DexterInd/BrickPi/README.txt

This project combines the brains of a Raspberry Pi with the brawn of a LEGO MINDSTORMS NXT.  Read more about it here:  http://www.dexterindustries.com/BrickPi

This repository only holds firmware and hardware designs.  
	* If you're looking for our BrickPi Python libraries, look here:	https://github.com/DexterInd/BrickPi_Python
	* If you're looking for the BrickPi C Libraries, look here: 		https://github.com/DexterInd/BrickPi_C
	* If you're looking for the BrickPi Scratch libraries, look here:	https://github.com/DexterInd/BrickPi_Scratch

The board firmware is made in Arduino in order to make it super-hackable.  The firmware is written in Arduino 1.0 and can be uploaded via an ISP programmer.  It can also be uploaded with an Arduino Uno, with an adapter explained in this repository.

The board supports LEGO NXT motors and LEGO NXT sensors, as well as many of Dexter Industries sensors for LEGO Mindstorms.

Dexter Industries
http://www.dexterindustries.com/BrickPi
