DexterInd/BrickPi/Software/BrickPi_Scratch/README.md

BrickPi Scratch Code and Examples
===================

This repository contains a Scratch library for BrickPi and Raspberry Pi, allowing you to use Scratch and LEGO Mindstorms NXT motors and sensors.
These files have been made available online through a [Creative Commons Attribution-ShareAlike 3.0](http://creativecommons.org/licenses/by-sa/3.0/) license.

Getting Started
============

Scratch and Scratch Examples come already installed on the Dexter Industries image.  See [more about the image here.](http://www.dexterindustries.com/BrickPi/getting-started/pi-prep/)

For step by step instructions on how to use Scratch with the BrickPi, please see our [tutorial on getting started with Scratch.](http://www.dexterindustries.com/BrickPi/program-it/scratch/)

Video and text tutorials for installation and operation are provided.

See Also
========

[BrickPi](http://www.dexterindustries.com/BrickPi.html) is a [Raspberry Pi](http://www.raspberrypi.org) Board that connects [LEGO MINDSTORMS motors and sensors](http://mindstorms.lego.com) to the Raspberry Pi.

More information on hardware, firmware, and software can be found on the [BrickPi site](http://www.dexterindustries.com/BrickPi)

The BrickPi can be [purchased here.](http://www.dexterindustries.com/BrickPi.html)
