DexterInd/BrickPi/Software/BrickPi_Python/Project_Examples/README.MD

# BrickPi Project Examples

This folder contains the code for the four example python projects..

BrickPi is a Raspberry Pi Board that connects LEGO MINDSTORMS motors and sensors to the Raspberry Pi.

[More information on hardware, firmware, and software can be found here.](http://www.dexterindustries.com/BrickPi)
