DexterInd/BrickPi/Software/BrickPi_Scratch/Programming/README.md

BrickPi Scratch Code and Examples
===================

This repository contains a Scratch library for BrickPi and Raspberry Pi, allowing you to use Scratch and LEGO Mindstorms NXT motors and sensors.
These files have been made available online through a [Creative Commons Attribution-ShareAlike 3.0](http://creativecommons.org/licenses/by-sa/3.0/) license.

Getting Started
============

Scratch and Scratch Examples come already installed on the Dexter Industries image.  See [more about the image here.](http://www.dexterindustries.com/BrickPi/getting-started/pi-prep/)

For step by step instructions on how to use Scratch with the BrickPi, please see our [tutorial on getting started with Scratch.](http://www.dexterindustries.com/BrickPi/program-it/scratch/)

Video and text tutorials for installation and operation are provided.

EV3 Sensors
============
Below are a few screenshots of various programs using EV3 sensors with the BrickPi and Scratch.

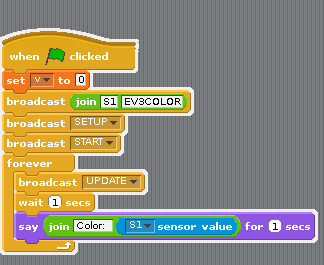
[picture p1: Software/BrickPi_Scratch/Programming/EV3_Color_on_S1.PNG]
EV3 Color Sensor


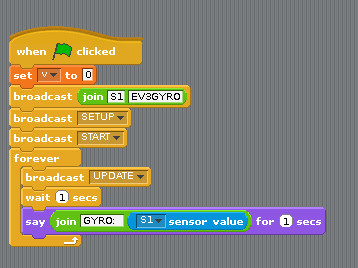
[picture p2: Software/BrickPi_Scratch/Programming/EV3_Gyro_on_S1.PNG]
EV3 Gyroscope Sensor


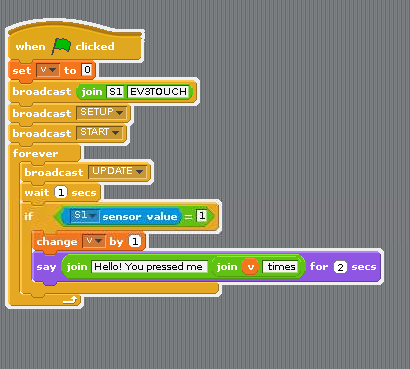
[picture p3: Software/BrickPi_Scratch/Programming/EV3_Touch_on_S1.PNG]
EV3 Touch Sensor


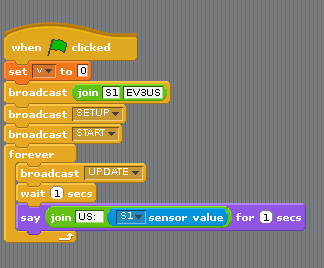
[picture p4: Software/BrickPi_Scratch/Programming/EV3_Ultrasonic_Sensor_on_S1.PNG]
EV3 Ultrasonic Sensor


See Also
========

[BrickPi](http://www.dexterindustries.com/brickpi) is a [Raspberry Pi](http://www.raspberrypi.org) Board that connects [LEGO MINDSTORMS motors and sensors](http://mindstorms.lego.com) to the Raspberry Pi.

More information on hardware, firmware, and software can be found on the [BrickPi site](http://www.dexterindustries.com/BrickPi)

The BrickPi can be [purchased here.](http://www.dexterindustries.com/BrickPi.html)
