DexterInd/BrickPi/Software/BrickPi_Python/Project_Examples/candysorter/README.md

## Raspberry Pi Candy Sorting Robot
### Candy Sorting Robot Using Google Cloud Vision, the Raspberry Pi, and the BrickPi.

In this tutorial, we're going to build a machine to sort your Halloween candy, using the Raspberry Pi and Google Cloud Vision.

Pile of candy too big this year?  Need to sort the junk from the gold?  Have a certain candy you hate?  Fear not, the BrickPi Candy Sorter is here to help!  In this tutorial we'll harness the powerful Google Cloud Vision, the BrickPi, the Raspberry Pi, the Pi Camera, and a pile of LEGO's to build a machine to fine what you want (and don't want) automatically!  After you run the BrickPi Candy Sorter, you'll have a pile of candy you want, and the junk you can give your little brother.

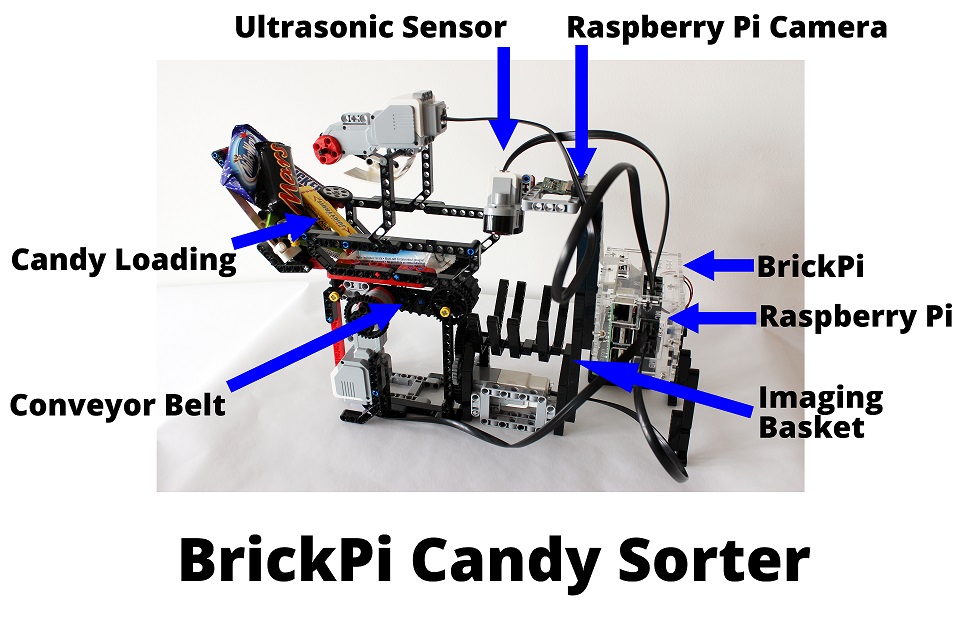
[picture p5: Software/BrickPi_Python/Project_Examples/candysorter/Overview-BrickPi-Candy-Sorter.jpg]
Controlling the GoPiGo robot with a mobile phone Overview of a Candy Sorting Robot Using Google Cloud Vision, the Raspberry Pi, and the BrickPi..


### Learn More

See the full [tutorial on how to build the Candy Sorting Robot on our website here.](http://www.dexterindustries.com/projects/brickpi-candy-sorter-sort-halloween-candy-with-google-cloud-vision-and-the-raspberry-pi)

See more about [the BrickPi here.](http://www.dexterindustries.com/BrickPi)
