DexterInd/BrickPi/Models/SimpleBot/README.md

SimpleBot Model
=====

These are the design files for the BrickPi SimpleBot robot, developed by Dexter Industries.

The SimpleBot as its name says is one of the simplest bot that you can build with the BrickPi. It is a 2 wheeled robot with a very easy to build chassis. We have added examples in the Github Repo for both Python(https://github.com/DexterInd/BrickPi/tree/master/Software/BrickPi_Python/Project_Examples/simplebot) and C(https://github.com/DexterInd/BrickPi/tree/master/Software/BrickPi_C/Project_Examples/simplebot) using which you can get this bot running directly from WiFi or use a PSP Controller to control the bot.

These files have been made available online through a [Creative Commons Attribution-ShareAlike 3.0](http://creativecommons.org/licenses/by-sa/3.0/) license.

You are welcome to distribute, remix, and use these files for commercial purposes. If you do so, please attribute the original design to Dexter Industries both on the website and on the physical packaging of the product or in the instruction manual. All derivative works must be published under the same or a similar license.

## What's Here

simplebot.lxf — LEGO Digital Designer Files fro the simplebot which can help you in building the simplebot
simplebot_bom - The Bill of Material for the SimpleBot with all the parts used in the build
