DexterInd/BrickPi/BrickPi_B+_Layout-Motors.png

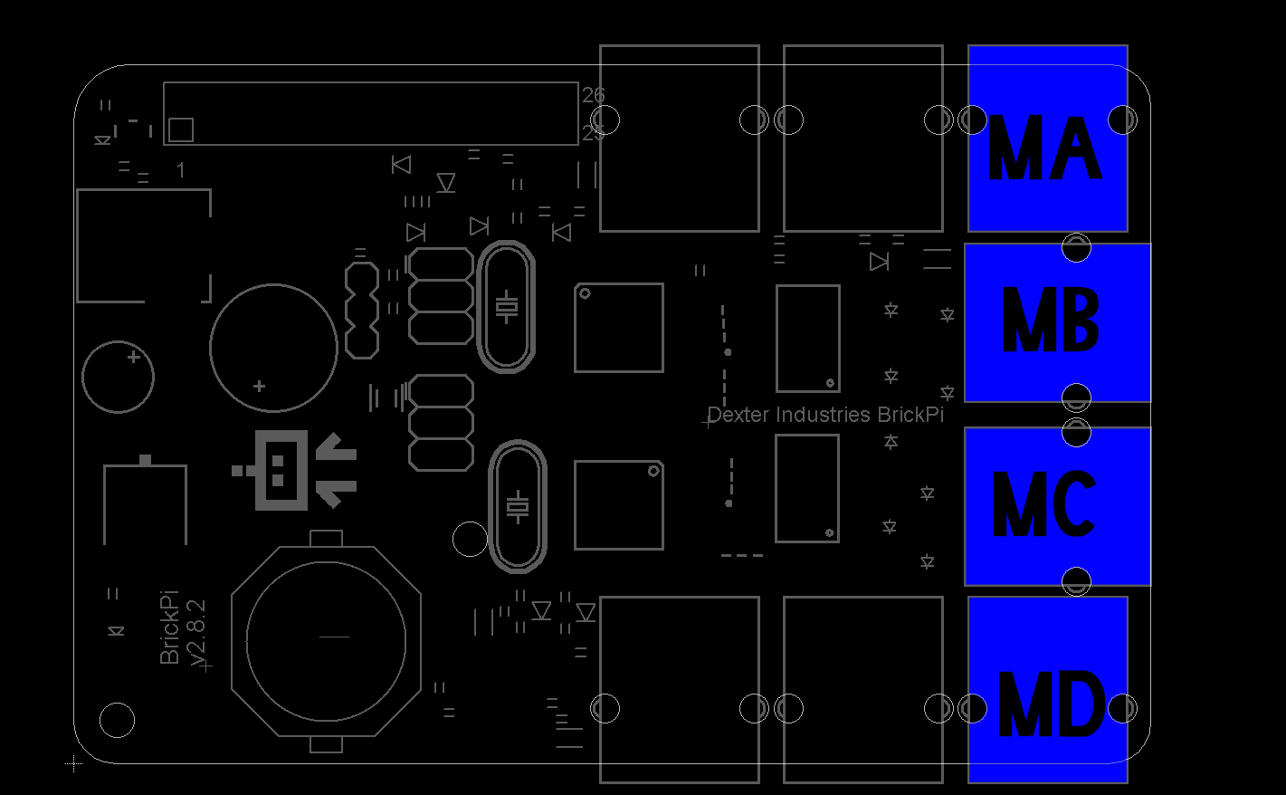
BrickPi_B+_Layout-Motors.png
