DexterInd/BrickPi/BrickPi_B+_Layout-Sensors.png

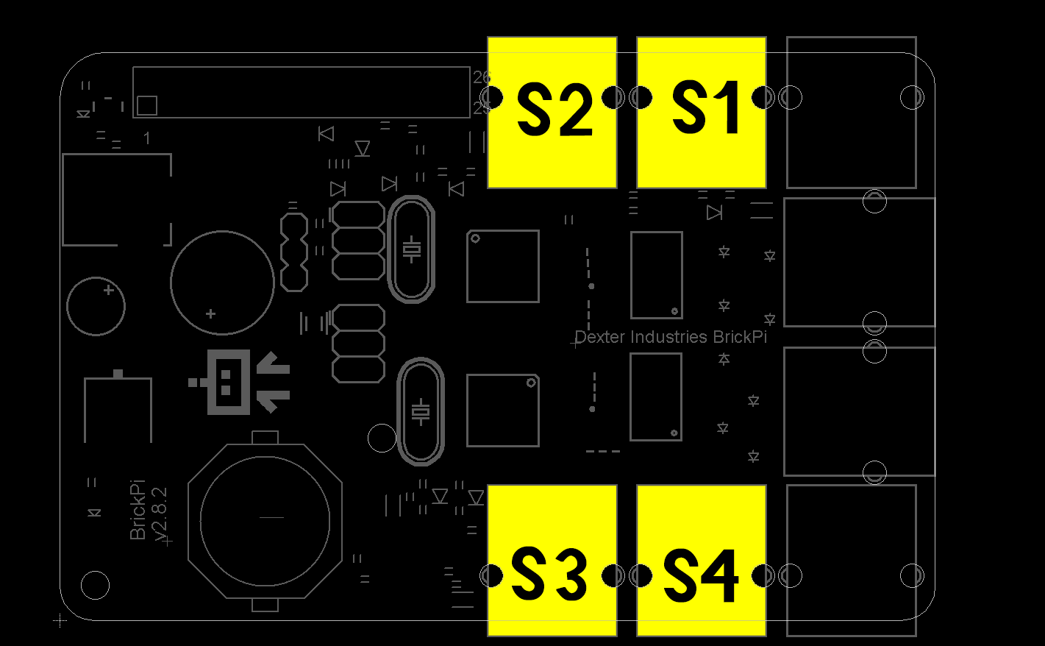
BrickPi_B+_Layout-Sensors.png
