DexterInd/BrickPi/Firmware_BrickPi/Updating_the_Firmware/BrickPi Programming - Arduino.jpg

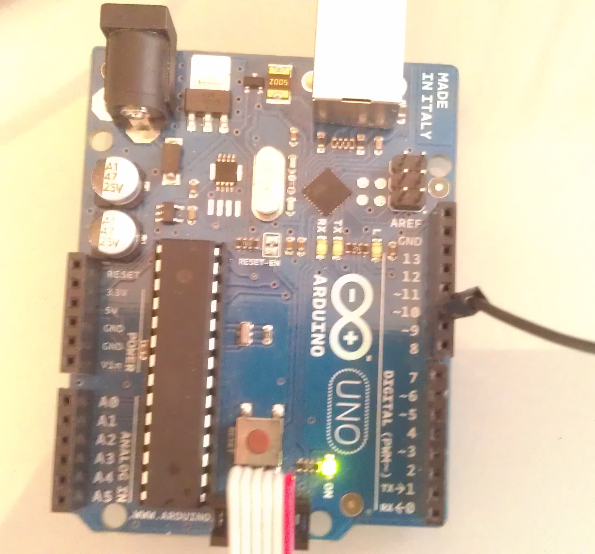
Firmware_BrickPi/Updating_the_Firmware/BrickPi Programming - Arduino.jpg
