DexterInd/BrickPi/Firmware_BrickPi/Updating_the_Firmware/BrickPi Programming - BrickPi and Arduino Programmer.jpg

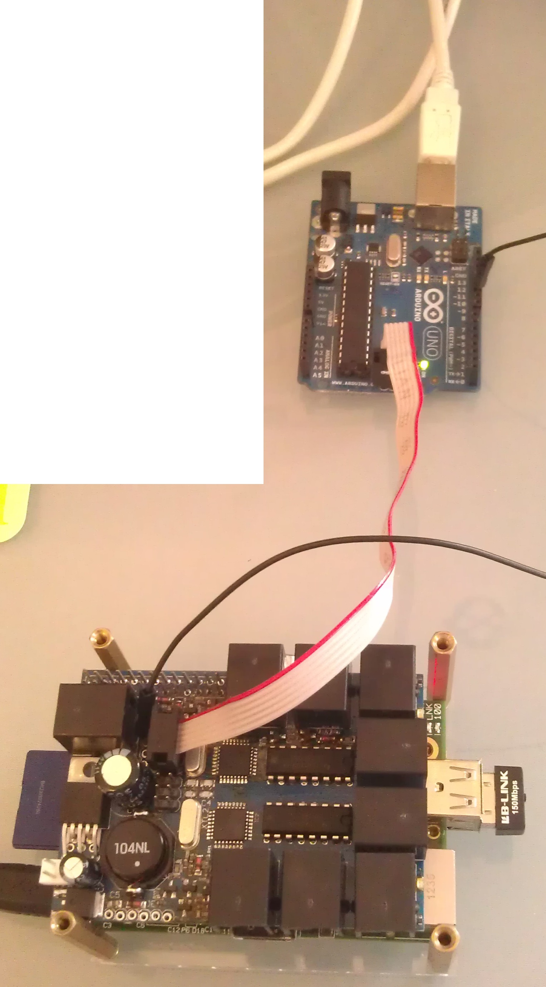
Firmware_BrickPi/Updating_the_Firmware/BrickPi Programming - BrickPi and Arduino Programmer.jpg
