DexterInd/BrickPi/Firmware_BrickPi/Updating_the_Firmware/BrickPi Programming - BrickPi from Above.jpg

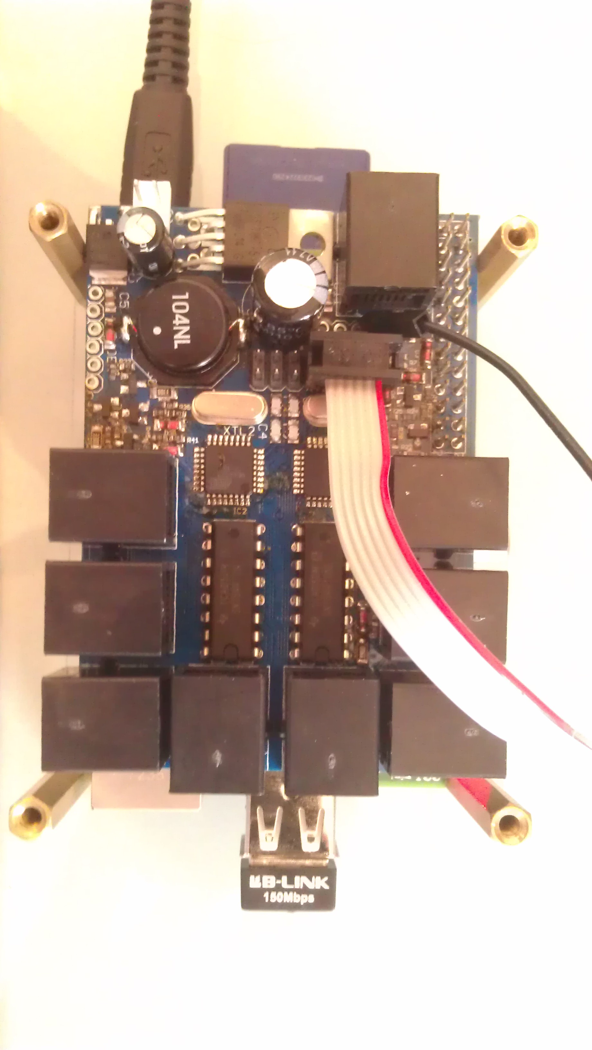
Firmware_BrickPi/Updating_the_Firmware/BrickPi Programming - BrickPi from Above.jpg
