DexterInd/BrickPi/Firmware_BrickPi/Updating_the_Firmware/Finding_the_COM_Port_Number.PNG

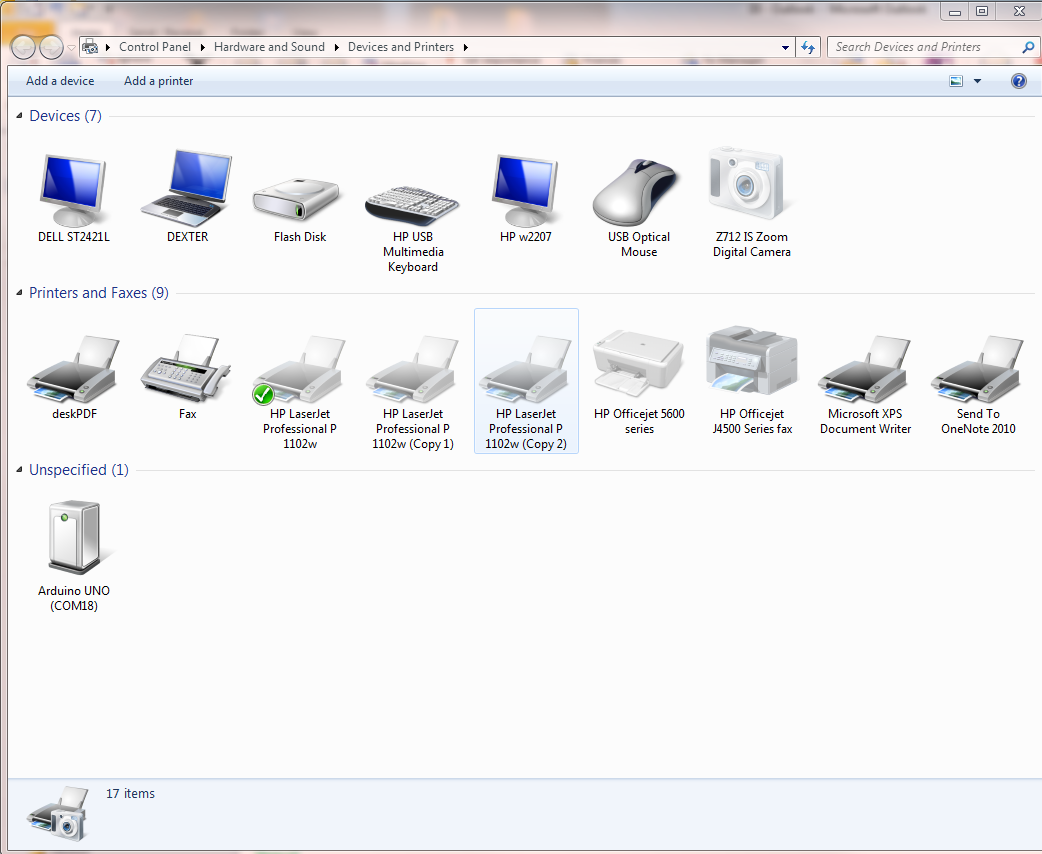
Firmware_BrickPi/Updating_the_Firmware/Finding_the_COM_Port_Number.PNG
