DexterInd/BrickPi/Firmware_BrickPi/Updating_the_Firmware/Finishing A Succesful Programming.PNG

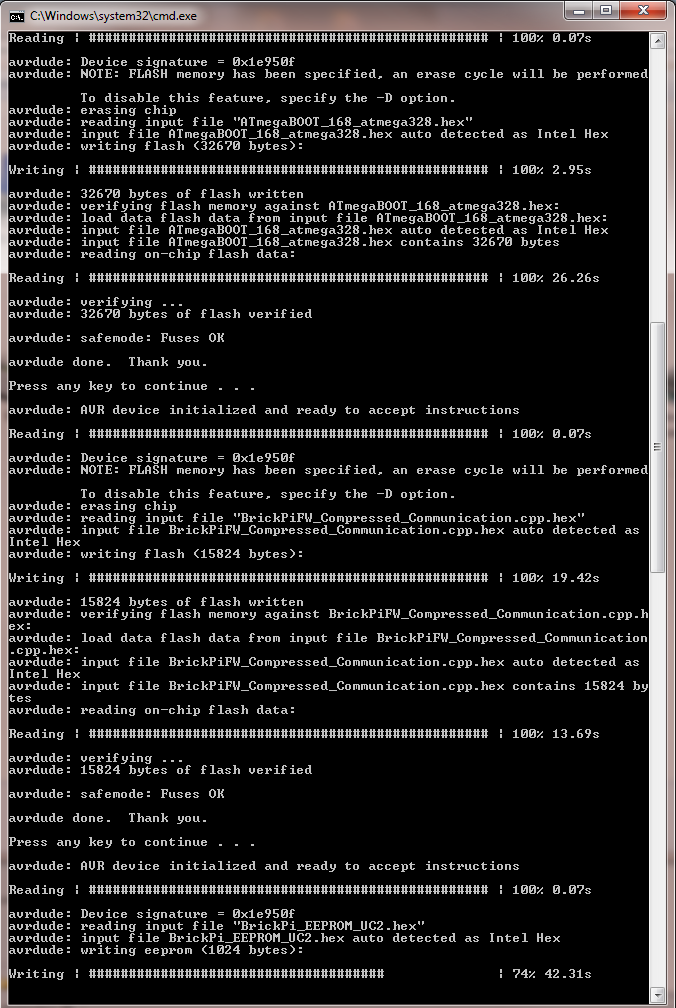
Firmware_BrickPi/Updating_the_Firmware/Finishing A Succesful Programming.PNG
