DexterInd/BrickPi/Firmware_BrickPi/Updating_the_Firmware/Setting Fuses Succesfully.PNG

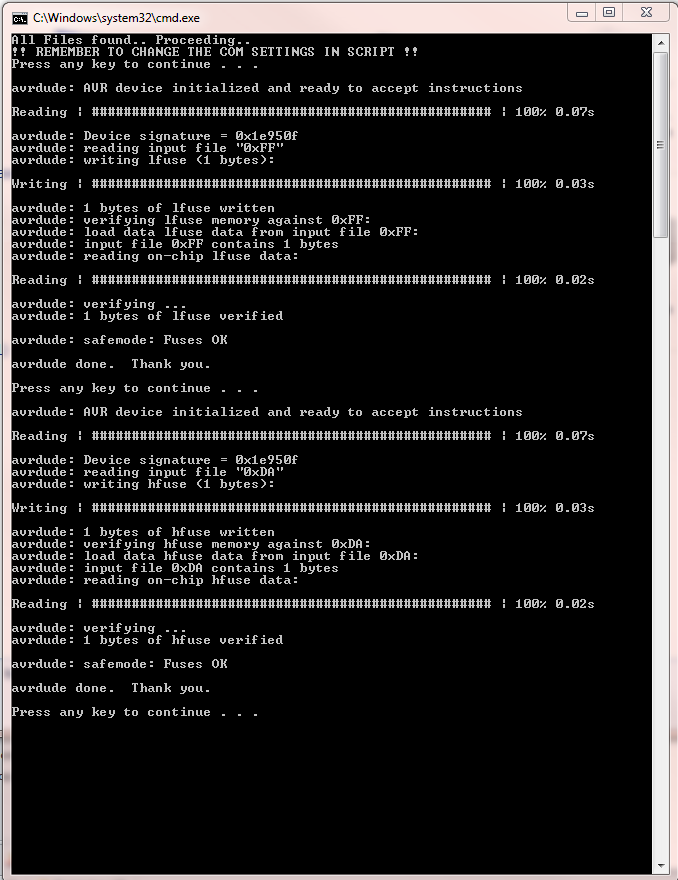
Firmware_BrickPi/Updating_the_Firmware/Setting Fuses Succesfully.PNG
