DexterInd/BrickPi/High Altitude Ballooning Project/weather_balloon_picture.jpg

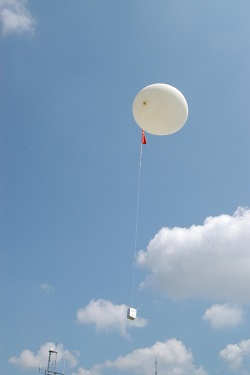
High Altitude Ballooning Project/weather_balloon_picture.jpg
