DexterInd/BrickPi/Models/Robotic_Arm/arm.png

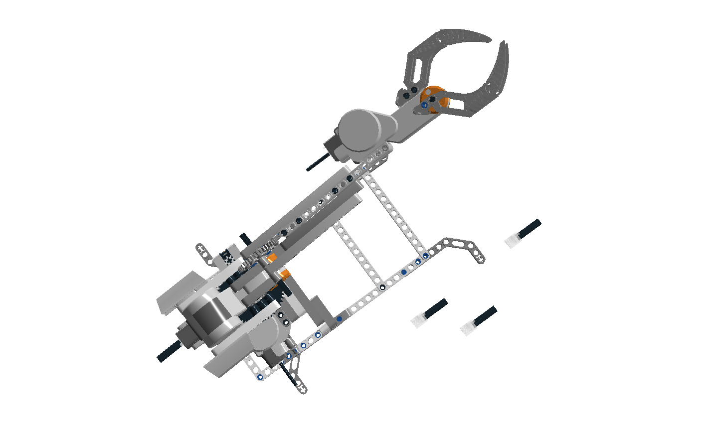
Models/Robotic_Arm/arm.png
