DexterInd/BrickPi/Models/Shooter/shooter.png

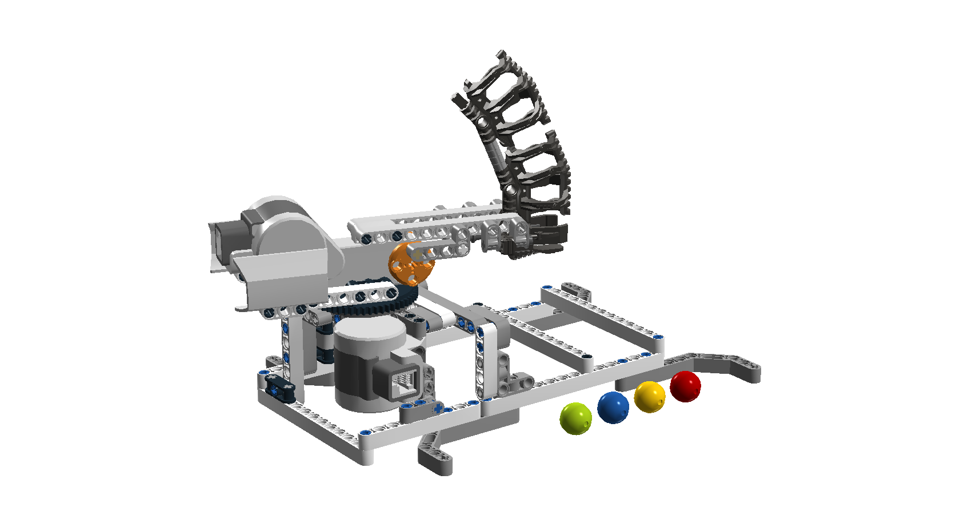
Models/Shooter/shooter.png
