DexterInd/BrickPi/Models/Tank/Tank.png

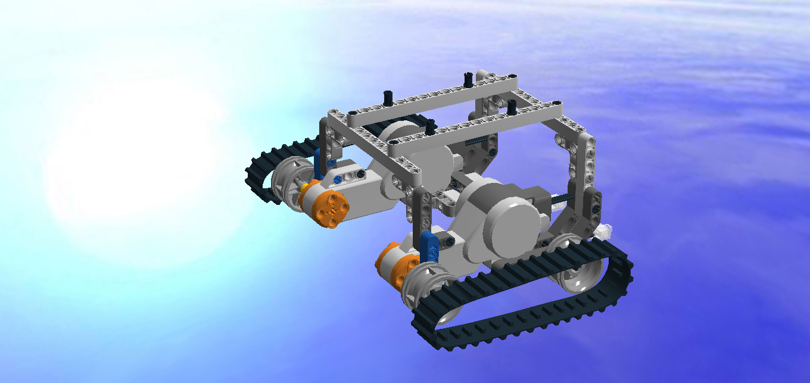
Models/Tank/Tank.png
