DexterInd/BrickPi/Models/WIFI_Car/WiFi Car in Space.png

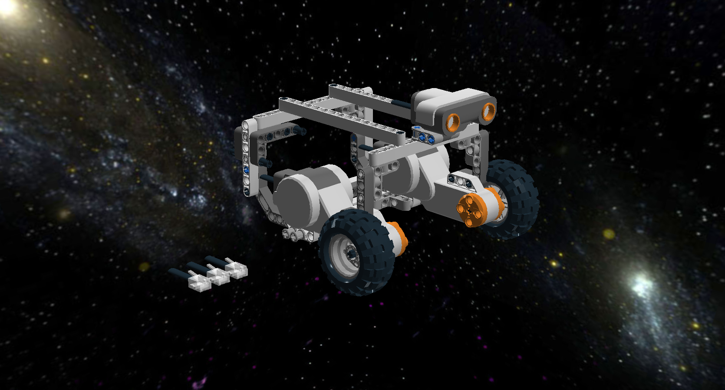
Models/WIFI_Car/WiFi Car in Space.png
