DexterInd/BrickPi/Models/WIFI_Car/WiFi Car In the Desert.png

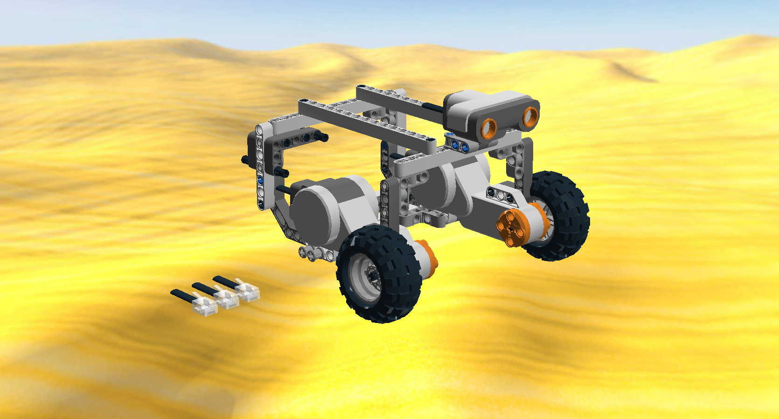
Models/WIFI_Car/WiFi Car In the Desert.png
