DexterInd/BrickPi/Models/WIFI_Car/WiFi Car.png

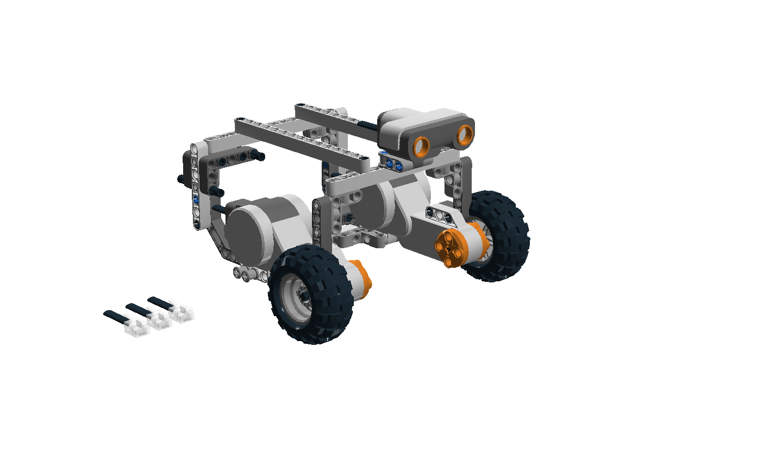
Models/WIFI_Car/WiFi Car.png
