DexterInd/BrickPi/Software/BrickPi_Python/Project_Examples/openCV/curve1.jpg

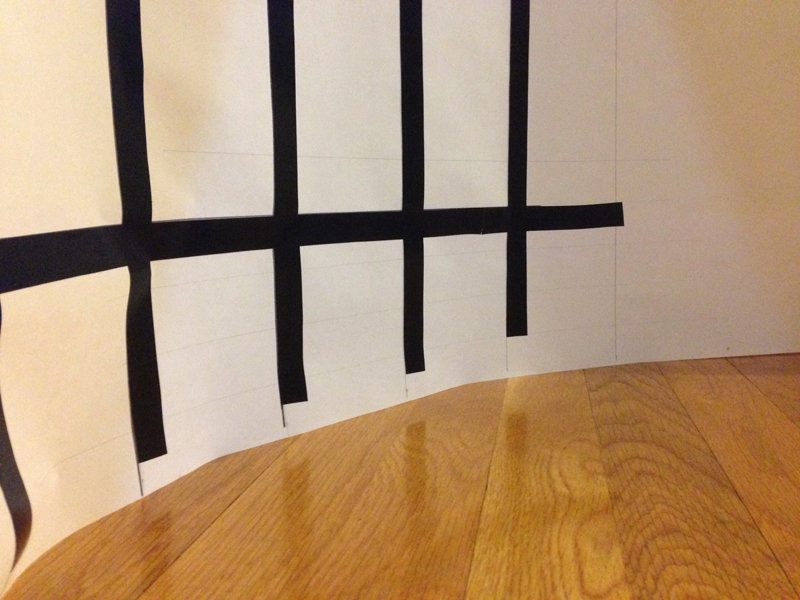
Software/BrickPi_Python/Project_Examples/openCV/curve1.jpg
