DexterInd/BrickPi/Software/BrickPi_Python/Project_Examples/openCV/curve2.jpg

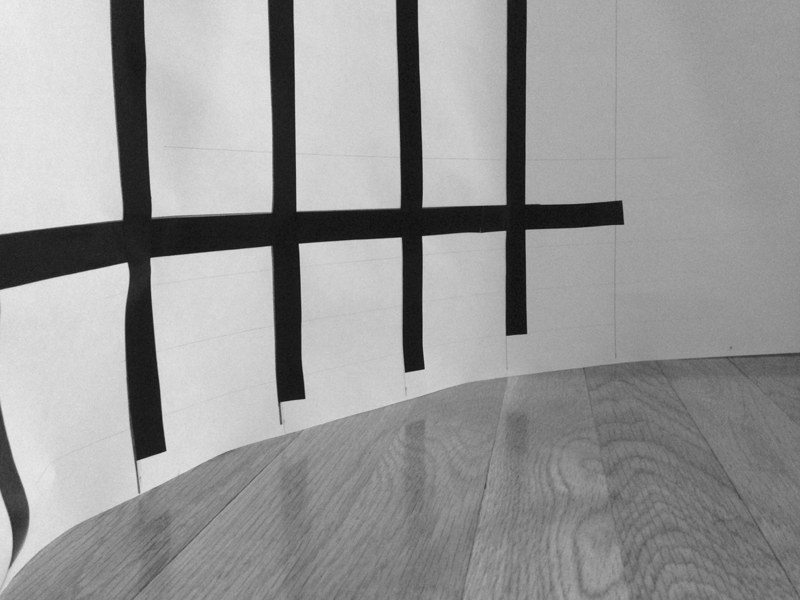
Software/BrickPi_Python/Project_Examples/openCV/curve2.jpg
