DexterInd/BrickPi/Software/BrickPi_Python/Project_Examples/openCV/gridlines1.jpg

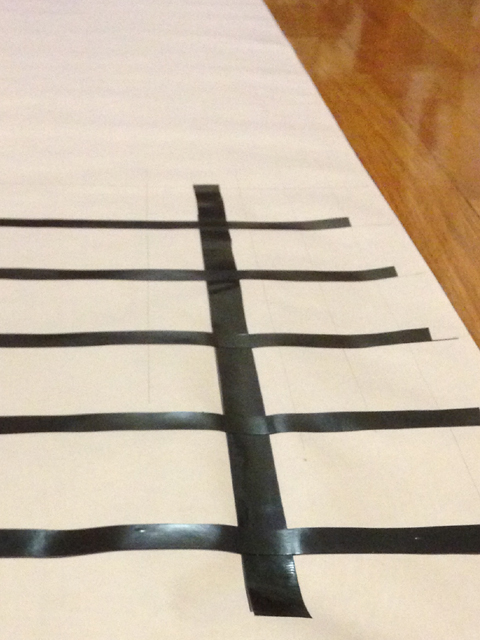
Software/BrickPi_Python/Project_Examples/openCV/gridlines1.jpg
