DexterInd/BrickPi/Software/BrickPi_Python/Project_Examples/openCV/gridlines2.jpg

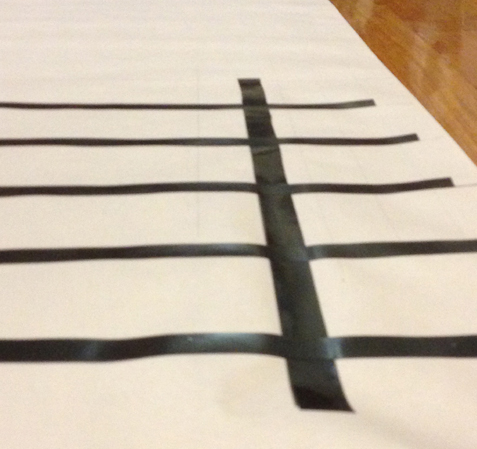
Software/BrickPi_Python/Project_Examples/openCV/gridlines2.jpg
