DexterInd/BrickPi/Software/BrickPi_Python/Project_Examples/openCV/gridlines3.jpg

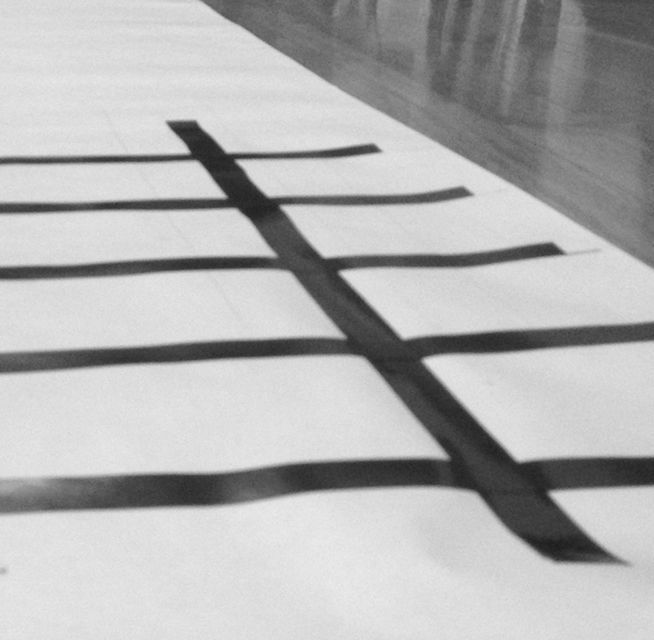
Software/BrickPi_Python/Project_Examples/openCV/gridlines3.jpg
