DexterInd/BrickPi/Software/BrickPi_Python/Project_Examples/openCV/houghlines5.jpg

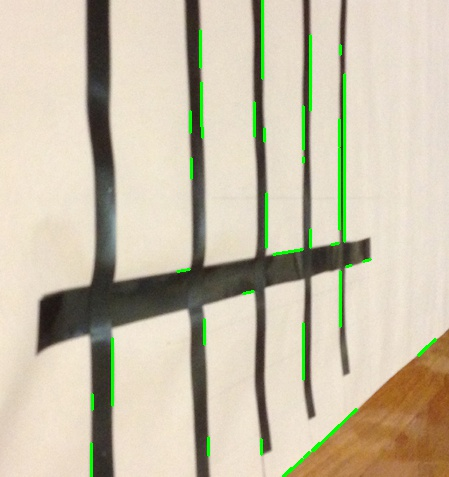
Software/BrickPi_Python/Project_Examples/openCV/houghlines5.jpg
