DexterInd/BrickPi/Software/BrickPi_Python/Project_Examples/openCV/houghlines7.jpg

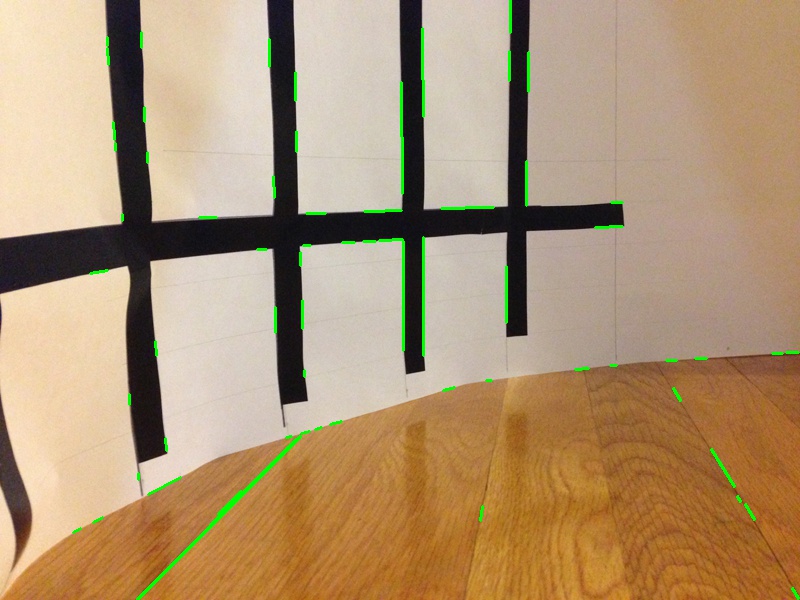
Software/BrickPi_Python/Project_Examples/openCV/houghlines7.jpg
