DexterInd/BrickPi/Software/BrickPi_Python/Project_Examples/openCV/racelines1.jpg

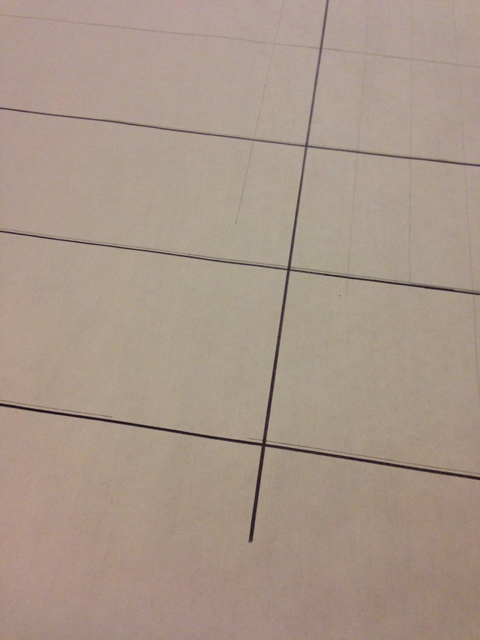
Software/BrickPi_Python/Project_Examples/openCV/racelines1.jpg
