DexterInd/BrickPi/Software/BrickPi_Python/Project_Examples/openCV/racelines2.jpg

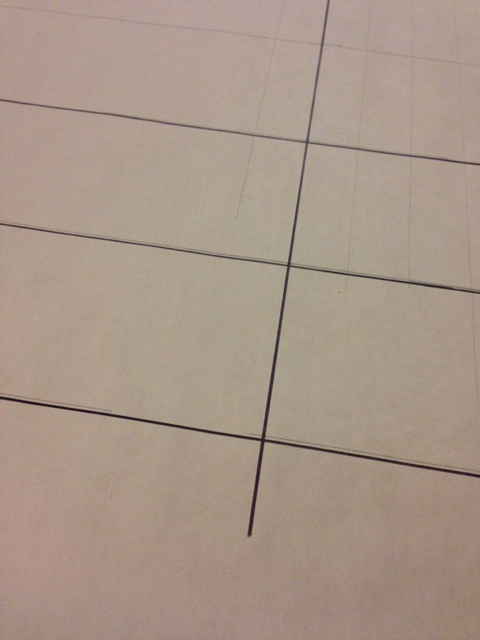
Software/BrickPi_Python/Project_Examples/openCV/racelines2.jpg
