DexterInd/BrickPi/Software/BrickPi_Python/Project_Examples/openCV/simple.jpg

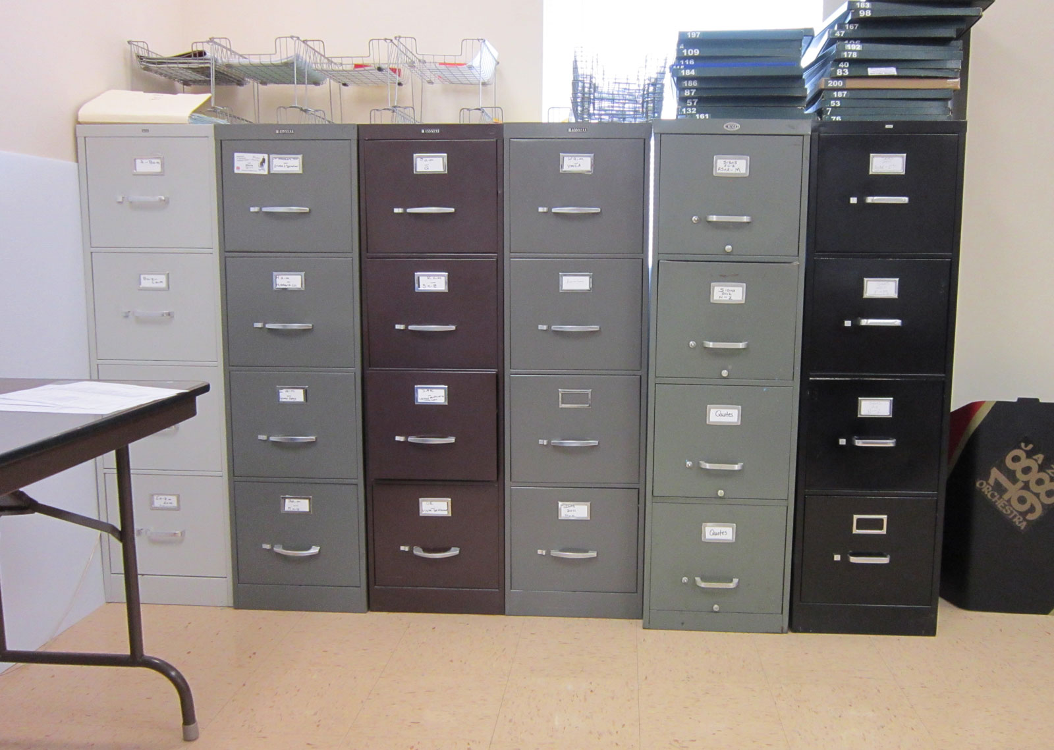
Software/BrickPi_Python/Project_Examples/openCV/simple.jpg
