DexterInd/BrickPi/Hardware Design/BrickPi BOM 1.7.3.xlsx

Sheet: BOM - BrickPi Basic
Part | Value | Device | Package | Description | Part Number and Link
C1 | 22 pF | C-USC0805 | C0805 | Capacitor | VJ0805A220GXAPW1BC (http://www.mouser.com/ProductDetail/Vishay-Vitramon/VJ0805A220GXAPW1BC/)
C2 | 22 pF | C-USC0805 | C0805 | Capacitor | VJ0805A220GXAPW1BC (http://www.mouser.com/ProductDetail/Vishay-Vitramon/VJ0805A220GXAPW1BC/)
C3 | 22 pF | C-USC0805 | C0805 | Capacitor | VJ0805A220GXAPW1BC (http://www.mouser.com/ProductDetail/Vishay-Vitramon/VJ0805A220GXAPW1BC/)
C4 | 22 pF | C-USC0805 | C0805 | Capacitor | VJ0805A220GXAPW1BC (http://www.mouser.com/ProductDetail/Vishay-Vitramon/VJ0805A220GXAPW1BC/)
C5 | 0.1 uF | C-USC0805 | C0805 | Capacitor | VJ0805V104MXBPW1BC (http://www.mouser.com/ProductDetail/Vishay-Vitramon/VJ0805V104MXBPW1BC/)
C6 | 0.1 uF | C-USC0805 | C0805 | Capacitor | VJ0805V104MXBPW1BC (http://www.mouser.com/ProductDetail/Vishay-Vitramon/VJ0805V104MXBPW1BC/)
C8 | 0.1 uF | C-USC0805 | C0805 | Capacitor | VJ0805V104MXBPW1BC (http://www.mouser.com/ProductDetail/Vishay-Vitramon/VJ0805V104MXBPW1BC/)
C10 | 0.1 uF | C-USC0805 | C0805 | Capacitor | VJ0805V104MXBPW1BC (http://www.mouser.com/ProductDetail/Vishay-Vitramon/VJ0805V104MXBPW1BC/)
C11 | 10uf | C-USC0805 | C0805 | CAPACITOR, American symbol | CGA4J1X5R1C106K (http://www.mouser.com/ProductDetail/TDK/CGA4J1X5R1C106K/)
D2 |  | DIODE-SOD80C | SOD80C | DIODE | LS4448GS08 (http://www.mouser.com/ProductDetail/Vishay-Semiconductors/LS4448GS08/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)
D3 |  | DIODE-SOD80C | SOD80C | DIODE | LS4448GS09 (http://www.mouser.com/ProductDetail/Vishay-Semiconductors/LS4448GS08/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)
D4 |  | DIODE-SOD80C | SOD80C | DIODE | LS4448GS10 (http://www.mouser.com/ProductDetail/Vishay-Semiconductors/LS4448GS08/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)
D5 |  | DIODE-SOD80C | SOD80C | DIODE | LS4448GS11 (http://www.mouser.com/ProductDetail/Vishay-Semiconductors/LS4448GS08/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)
D6 |  | DIODE-SOD80C | SOD80C | DIODE | LS4448GS12 (http://www.mouser.com/ProductDetail/Vishay-Semiconductors/LS4448GS08/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)
D10 |  | DIODE-SOD80C | SOD80C | DIODE | LS4448GS13 (http://www.mouser.com/ProductDetail/Vishay-Semiconductors/LS4448GS08/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)
D20 |  | DIODE-SOD80C | SOD80C | DIODE | LS4448GS14 (http://www.mouser.com/ProductDetail/Vishay-Semiconductors/LS4448GS08/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)
D30 |  | DIODE-SOD80C | SOD80C | DIODE | LS4448GS15 (http://www.mouser.com/ProductDetail/Vishay-Semiconductors/LS4448GS08/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)
D40 |  | DIODE-SOD80C | SOD80C | DIODE | LS4448GS16 (http://www.mouser.com/ProductDetail/Vishay-Semiconductors/LS4448GS08/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)
D50 |  | DIODE-SOD80C | SOD80C | DIODE | LS4448GS15 (http://www.mouser.com/ProductDetail/Vishay-Semiconductors/LS4448GS08/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)
D51 |  | DIODE-SOD80C | SOD80C | DIODE | LS4448GS16 (http://www.mouser.com/ProductDetail/Vishay-Semiconductors/LS4448GS08/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)
F1 | PTCSMD | PTCSMD | PTC-1206 | Resettable Fuse PTC | PTS12066V110 (http://www.mouser.com/ProductDetail/Cooper-Bussmann/PTS12066V110/)
IC1 |  | ATMEGA328P-AU | TQFP32-08 | Arduino | ATMEGA328P-AU (http://www.mouser.com/ProductDetail/Atmel/ATMEGA328P-AU/?qs=sGAEpiMZZMtVoztFdqDXO3RbBx7FKCmV)
IC2 |  | ATMEGA328P-AU | TQFP32-08 | Arduino | ATMEGA328P-AU (http://www.mouser.com/ProductDetail/Atmel/ATMEGA328P-AU/?qs=sGAEpiMZZMtVoztFdqDXO3RbBx7FKCmV)
IC3 | SN754410 | DIL16-ROUND-HEAT_DIS_SN754410 |  |  | SN754410NE (http://www.mouser.com/ProductDetail/Texas-Instruments/SN754410NE/)
IC4 | SN754410 | DIL16-ROUND-HEAT_DIS_SN754410 |  |  | SN754410NE (http://www.mouser.com/ProductDetail/Texas-Instruments/SN754410NE/)
IC6 | REGULATOR_5V_TO220-H_7805 | REGULATOR_5V_TO220-H_7805 | TO220-H | Positive VOLTAGE REGULATOR | 512-LM7805ACT (http://www.mouser.com/ProductDetail/Fairchild-Semiconductor/LM7805ACT/)
JP2 |  | M02LOCK | 1X02_LOCK | Header 2 | 538-22-23-2021 (http://www.mouser.com/ProductDetail/Molex/22-23-2021/)
LED1 |  | LED0805 | 0805-LED | LEDs | 638-172BHC-AN1P23T (https://www.mouser.com/Search/ProductDetail.aspx)
LED2 |  | LED0805 | 0805-LED | LEDs | 638-172BHC-AN1P23T (https://www.mouser.com/Search/ProductDetail.aspx)
Q10 |  | PNP-TRANSISTOR_SOT23 | SOT23 | PNP TRANSISTOR | MMBT3906LT3G (http://www.mouser.com/ProductDetail/ON-Semiconductor/MMBT3906LT3G/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)
Q11 |  | NPN-TRANSISTOR_SOT23 | SOT23 | NPN TRANSISTOR | MMBT3904 (http://www.mouser.com/ProductDetail/Fairchild-Semiconductor/MMBT3904/)
Q20 |  | PNP-TRANSISTOR_SOT23 | SOT23 | PNP TRANSISTOR | MMBT3906LT3G (http://www.mouser.com/ProductDetail/ON-Semiconductor/MMBT3906LT3G/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)
Q21 |  | NPN-TRANSISTOR_SOT23 | SOT23 | NPN TRANSISTOR | MMBT3904 (http://www.mouser.com/ProductDetail/Fairchild-Semiconductor/MMBT3904/)
Q30 |  | PNP-TRANSISTOR_SOT23 | SOT23 | PNP TRANSISTOR | MMBT3906LT3G (http://www.mouser.com/ProductDetail/ON-Semiconductor/MMBT3906LT3G/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)
Q31 |  | NPN-TRANSISTOR_SOT23 | SOT23 | NPN TRANSISTOR | MMBT3904 (http://www.mouser.com/ProductDetail/Fairchild-Semiconductor/MMBT3904/)
Q40 |  | PNP-TRANSISTOR_SOT23 | SOT23 | PNP TRANSISTOR | MMBT3906LT3G (http://www.mouser.com/ProductDetail/ON-Semiconductor/MMBT3906LT3G/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)
Q41 |  | NPN-TRANSISTOR_SOT23 | SOT23 | NPN TRANSISTOR | MMBT3904 (http://www.mouser.com/ProductDetail/Fairchild-Semiconductor/MMBT3904/)
XTL1 |  | CRYSTALHC49S | HC49/S | CRYSTAL | ATS16B (http://www.mouser.com/ProductDetail/CTS-Electronic-Components/ATS16B/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)
XTL2 |  | CRYSTALHC49S | HC49/S | CRYSTAL | ATS16B (http://www.mouser.com/ProductDetail/CTS-Electronic-Components/ATS16B/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)
U$3 |  | NXT-SOCKETREGULAR | NXT-SOCKETREGULAR | NXT-SOCKET | Female Sockets (http://www.dexterindustries.com/NXTFemaleSockets.html)
U$4 |  | NXT-SOCKETREGULAR | NXT-SOCKETREGULAR | NXT-SOCKET | Female Sockets (http://www.dexterindustries.com/NXTFemaleSockets.html)
U$5 |  | NXT-SOCKETREGULAR | NXT-SOCKETREGULAR | NXT-SOCKET | Female Sockets (http://www.dexterindustries.com/NXTFemaleSockets.html)
U$7 |  | NXT-SOCKETREGULAR | NXT-SOCKETREGULAR | NXT-SOCKET | Female Sockets (http://www.dexterindustries.com/NXTFemaleSockets.html)
U$8 |  | NXT-SOCKETREGULAR | NXT-SOCKETREGULAR | NXT-SOCKET | Female Sockets (http://www.dexterindustries.com/NXTFemaleSockets.html)
U$9 |  | NXT-SOCKETREGULAR | NXT-SOCKETREGULAR | NXT-SOCKET | Female Sockets (http://www.dexterindustries.com/NXTFemaleSockets.html)
U$10 |  | NXT-SOCKETREGULAR | NXT-SOCKETREGULAR | NXT-SOCKET | Female Sockets (http://www.dexterindustries.com/NXTFemaleSockets.html)
U$11 |  | NXT-SOCKETREGULAR | NXT-SOCKETREGULAR | NXT-SOCKET | Female Sockets (http://www.dexterindustries.com/NXTFemaleSockets.html)
U$12 |  | NXT-SOCKETREGULAR | NXT-SOCKETREGULAR | NXT-SOCKET | Female Sockets (http://www.dexterindustries.com/NXTFemaleSockets.html)
R1 | 10k | RESISTOR0603-RES | 603 | Resistor | RK73B1JTTDD103J (http://www.mouser.com/ProductDetail/KOA-Speer/RK73B1JTTDD103J/)
R2 | 10k | RESISTOR0603-RES | 603 | Resistor | RK73B1JTTDD103J (http://www.mouser.com/ProductDetail/KOA-Speer/RK73B1JTTDD103J/)
R3 | 2k4 | RESISTOR0603-RES | 603 | Resistor | RK73B1JTTDD242J (http://www.mouser.com/ProductDetail/KOA-Speer/RK73B1JTTDD242J/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)
R4 | 10k | RESISTOR0603-RES | 603 | Resistor | RK73B1JTTDD103J (http://www.mouser.com/ProductDetail/KOA-Speer/RK73B1JTTDD103J/)
R6 | 4k7 | RESISTOR0603-RES | 603 | Resistor | RK73B1JTTDD472J (http://www.mouser.com/ProductDetail/KOA-Speer/RK73B1JTTDD472J/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)
R7 | 2k4 | RESISTOR0603-RES | 603 | Resistor | RK73B1JTTDD242J (http://www.mouser.com/ProductDetail/KOA-Speer/RK73B1JTTDD242J/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)
R8 | 220 | RESISTOR0603-RES | 603 | Resistor | RK73B1JTTDD221J (http://www.mouser.com/ProductDetail/KOA-Speer/RK73B1JTTDD221J/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)
R9 | 220 | RESISTOR0603-RES | 603 | Resistor | RK73B1JTTDD221J (http://www.mouser.com/ProductDetail/KOA-Speer/RK73B1JTTDD221J/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)
R10 | 10k | RESISTOR0603-RES | 603 | Resistor | RK73B1JTTDD103J (http://www.mouser.com/ProductDetail/KOA-Speer/RK73B1JTTDD103J/)
R11 | 4k7 | RESISTOR0603-RES | 603 | Resistor | RK73B1JTTDD472J (http://www.mouser.com/ProductDetail/KOA-Speer/RK73B1JTTDD472J/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)
R12 | 325 | RESISTOR1206 | 1206 | Resistor | CR1206-FX-3300ELF (http://www.mouser.com/ProductDetail/Bourns/CR1206-FX-3300ELF/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)
R13 | 4k7 | RESISTOR0603-RES | 603 | Resistor | RK73B1JTTDD472J (http://www.mouser.com/ProductDetail/KOA-Speer/RK73B1JTTDD472J/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)
R14 | 10k | RESISTOR0603-RES | 603 | Resistor | RK73B1JTTDD103J (http://www.mouser.com/ProductDetail/KOA-Speer/RK73B1JTTDD103J/)
R15 | 4k7 | RESISTOR0603-RES | 603 | Resistor | RK73B1JTTDD472J (http://www.mouser.com/ProductDetail/KOA-Speer/RK73B1JTTDD472J/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)
R20 | 10k | RESISTOR0603-RES | 603 | Resistor | RK73B1JTTDD103J (http://www.mouser.com/ProductDetail/KOA-Speer/RK73B1JTTDD103J/)
R21 | 4k7 | RESISTOR0603-RES | 603 | Resistor | RK73B1JTTDD472J (http://www.mouser.com/ProductDetail/KOA-Speer/RK73B1JTTDD472J/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)
R22 | 325 | RESISTOR1206 | 1206 | Resistor | CR1206-FX-3300ELF (http://www.mouser.com/ProductDetail/Bourns/CR1206-FX-3300ELF/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)
R23 | 4k7 | RESISTOR0603-RES | 603 | Resistor | RK73B1JTTDD472J (http://www.mouser.com/ProductDetail/KOA-Speer/RK73B1JTTDD472J/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)
R24 | 10k | RESISTOR0603-RES | 603 | Resistor | RK73B1JTTDD103J (http://www.mouser.com/ProductDetail/KOA-Speer/RK73B1JTTDD103J/)
R25 | 4k7 | RESISTOR0603-RES | 603 | Resistor | RK73B1JTTDD472J (http://www.mouser.com/ProductDetail/KOA-Speer/RK73B1JTTDD472J/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)
R30 | 10k | RESISTOR0603-RES | 603 | Resistor | RK73B1JTTDD103J (http://www.mouser.com/ProductDetail/KOA-Speer/RK73B1JTTDD103J/)
R31 | 4k7 | RESISTOR0603-RES | 603 | Resistor | RK73B1JTTDD472J (http://www.mouser.com/ProductDetail/KOA-Speer/RK73B1JTTDD472J/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)
R32 | 325 | RESISTOR1206 | 1206 | Resistor | CR1206-FX-3300ELF (http://www.mouser.com/ProductDetail/Bourns/CR1206-FX-3300ELF/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)
R33 | 4k7 | RESISTOR0603-RES | 603 | Resistor | RK73B1JTTDD472J (http://www.mouser.com/ProductDetail/KOA-Speer/RK73B1JTTDD472J/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)
R34 | 10k | RESISTOR0603-RES | 603 | Resistor | RK73B1JTTDD103J (http://www.mouser.com/ProductDetail/KOA-Speer/RK73B1JTTDD103J/)
R35 | 4k7 | RESISTOR0603-RES | 603 | Resistor | RK73B1JTTDD472J (http://www.mouser.com/ProductDetail/KOA-Speer/RK73B1JTTDD472J/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)
R40 | 10k | RESISTOR0603-RES | 603 | Resistor | RK73B1JTTDD103J (http://www.mouser.com/ProductDetail/KOA-Speer/RK73B1JTTDD103J/)
R41 | 4k7 | RESISTOR0603-RES | 603 | Resistor | RK73B1JTTDD472J (http://www.mouser.com/ProductDetail/KOA-Speer/RK73B1JTTDD472J/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)
R42 | 325 | RESISTOR1206 | 1206 | Resistor | CR1206-FX-3300ELF (http://www.mouser.com/ProductDetail/Bourns/CR1206-FX-3300ELF/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)
R43 | 4k7 | RESISTOR0603-RES | 603 | Resistor | RK73B1JTTDD472J (http://www.mouser.com/ProductDetail/KOA-Speer/RK73B1JTTDD472J/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)
R44 | 10k | RESISTOR0603-RES | 603 | Resistor | RK73B1JTTDD103J (http://www.mouser.com/ProductDetail/KOA-Speer/RK73B1JTTDD103J/)
R45 | 4k7 | RESISTOR0603-RES | 603 | Resistor | RK73B1JTTDD472J (http://www.mouser.com/ProductDetail/KOA-Speer/RK73B1JTTDD472J/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)
R52 | 325 | RESISTOR1206 | 1206 | Resistor | NOT FILLED
PI_OUTLINE | RASPBERRY-PI | RASPBERRY-PI | RASPBERRY-PI | Raspberry Pi Adapter | Stacking Header 2x13 Extra Tall (http://www.adafruit.com/products/1112)
SJ1 | SOLDERJUMPERNO | SOLDERJUMPERNO | SJ_2 | Solder Jumper | NOT FILLED
FTDI-HEADER |  | M06LOCK | 1X06_LOCK | Header 6 | NOT FILLED
J1 | AVR_SPI_PRG_62X3_LOCK | AVR_SPI_PRG_62X3_LOCK | 2X3_LOCK | AVR ISP 6 Pin | NOT FILLED
J2 | AVR_SPI_PRG_62X3_LOCK | AVR_SPI_PRG_62X3_LOCK | 2X3_LOCK | AVR ISP 6 Pin | NOT FILLED
JP1 |  | M03LOCK | 1X03_LOCK | Header 3 | NOT FILLED
C7 | 120uF |  |  |  | NOT FILLED
C9 | 1000uF |  |  |  | NOT FILLED
D1 | DIODE_SCHOTTKY_VS-6CWQ04FNTRPBF | DIODE_SCHOTTKY_VS-6CWQ04FNTRPBF | DPAK |  | NOT FILLED
IC5 | LM2576 |  |  |  | NOT FILLED
U$14 | INDUCTOR_PULSE_P0250.XXXNL | INDUCTOR_PULSE_P0250.XXXNL | INDUCTOR_PULSE_P0250.XXXNL |  | NOT FILLED

Sheet: BOM - BrickPi Advanced
Part | Value | Device | Package | Description | Part Number and Link
C1 | 22 pF | C-USC0805 | C0805 | Capacitor | VJ0805A220GXAPW1BC (http://www.mouser.com/ProductDetail/Vishay-Vitramon/VJ0805A220GXAPW1BC/)
C2 | 22 pF | C-USC0805 | C0805 | Capacitor | VJ0805A220GXAPW1BC (http://www.mouser.com/ProductDetail/Vishay-Vitramon/VJ0805A220GXAPW1BC/)
C3 | 22 pF | C-USC0805 | C0805 | Capacitor | VJ0805A220GXAPW1BC (http://www.mouser.com/ProductDetail/Vishay-Vitramon/VJ0805A220GXAPW1BC/)
C4 | 22 pF | C-USC0805 | C0805 | Capacitor | VJ0805A220GXAPW1BC (http://www.mouser.com/ProductDetail/Vishay-Vitramon/VJ0805A220GXAPW1BC/)
C5 | 0.1 uF | C-USC0805 | C0805 | Capacitor | VJ0805V104MXBPW1BC (http://www.mouser.com/ProductDetail/Vishay-Vitramon/VJ0805V104MXBPW1BC/)
C6 | 0.1 uF | C-USC0805 | C0805 | Capacitor | VJ0805V104MXBPW1BC (http://www.mouser.com/ProductDetail/Vishay-Vitramon/VJ0805V104MXBPW1BC/)
C8 | 0.1 uF | C-USC0805 | C0805 | Capacitor | VJ0805V104MXBPW1BC (http://www.mouser.com/ProductDetail/Vishay-Vitramon/VJ0805V104MXBPW1BC/)
C10 | 0.1 uF | C-USC0805 | C0805 | Capacitor | VJ0805V104MXBPW1BC (http://www.mouser.com/ProductDetail/Vishay-Vitramon/VJ0805V104MXBPW1BC/)
C11 | 10uf | C-USC0805 | C0805 | CAPACITOR, American symbol | CGA4J1X5R1C106K (http://www.mouser.com/ProductDetail/TDK/CGA4J1X5R1C106K/)
D2 |  | DIODE-SOD80C | SOD80C | DIODE | LS4448GS08 (http://www.mouser.com/ProductDetail/Vishay-Semiconductors/LS4448GS08/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)
D3 |  | DIODE-SOD80C | SOD80C | DIODE | LS4448GS09 (http://www.mouser.com/ProductDetail/Vishay-Semiconductors/LS4448GS08/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)
D4 |  | DIODE-SOD80C | SOD80C | DIODE | LS4448GS10 (http://www.mouser.com/ProductDetail/Vishay-Semiconductors/LS4448GS08/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)
D5 |  | DIODE-SOD80C | SOD80C | DIODE | LS4448GS11 (http://www.mouser.com/ProductDetail/Vishay-Semiconductors/LS4448GS08/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)
D6 |  | DIODE-SOD80C | SOD80C | DIODE | LS4448GS12 (http://www.mouser.com/ProductDetail/Vishay-Semiconductors/LS4448GS08/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)
D10 |  | DIODE-SOD80C | SOD80C | DIODE | LS4448GS13 (http://www.mouser.com/ProductDetail/Vishay-Semiconductors/LS4448GS08/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)
D20 |  | DIODE-SOD80C | SOD80C | DIODE | LS4448GS14 (http://www.mouser.com/ProductDetail/Vishay-Semiconductors/LS4448GS08/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)
D30 |  | DIODE-SOD80C | SOD80C | DIODE | LS4448GS15 (http://www.mouser.com/ProductDetail/Vishay-Semiconductors/LS4448GS08/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)
D40 |  | DIODE-SOD80C | SOD80C | DIODE | LS4448GS16 (http://www.mouser.com/ProductDetail/Vishay-Semiconductors/LS4448GS08/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)
D50 |  | DIODE-SOD80C | SOD80C | DIODE | LS4448GS15 (http://www.mouser.com/ProductDetail/Vishay-Semiconductors/LS4448GS08/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)
D51 |  | DIODE-SOD80C | SOD80C | DIODE | LS4448GS16 (http://www.mouser.com/ProductDetail/Vishay-Semiconductors/LS4448GS08/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)
F1 | PTCSMD | PTCSMD | PTC-1206 | Resettable Fuse PTC | PTS12066V110 (http://www.mouser.com/ProductDetail/Cooper-Bussmann/PTS12066V110/)
IC1 |  | ATMEGA328P-AU | TQFP32-08 | Arduino | ATMEGA328P-AU (http://www.mouser.com/ProductDetail/Atmel/ATMEGA328P-AU/?qs=sGAEpiMZZMtVoztFdqDXO3RbBx7FKCmV)
IC2 |  | ATMEGA328P-AU | TQFP32-08 | Arduino | ATMEGA328P-AU (http://www.mouser.com/ProductDetail/Atmel/ATMEGA328P-AU/?qs=sGAEpiMZZMtVoztFdqDXO3RbBx7FKCmV)
IC3 | SN754410 | DIL16-ROUND-HEAT_DIS_SN754410 |  |  | SN754410NE (http://www.mouser.com/ProductDetail/Texas-Instruments/SN754410NE/)
IC4 | SN754410 | DIL16-ROUND-HEAT_DIS_SN754410 |  |  | SN754410NE (http://www.mouser.com/ProductDetail/Texas-Instruments/SN754410NE/)
JP2 |  | M02LOCK | 1X02_LOCK | Header 2 | 538-22-23-2021 (http://www.mouser.com/ProductDetail/Molex/22-23-2021/)
LED1 |  | LED0805 | 0805-LED | LEDs | 638-172BHC-AN1P23T (https://www.mouser.com/Search/ProductDetail.aspx)
LED2 |  | LED0805 | 0805-LED | LEDs | 638-172BHC-AN1P23T (https://www.mouser.com/Search/ProductDetail.aspx)
Q10 |  | PNP-TRANSISTOR_SOT23 | SOT23 | PNP TRANSISTOR | MMBT3906LT3G (http://www.mouser.com/ProductDetail/ON-Semiconductor/MMBT3906LT3G/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)
Q11 |  | NPN-TRANSISTOR_SOT23 | SOT23 | NPN TRANSISTOR | MMBT3904 (http://www.mouser.com/ProductDetail/Fairchild-Semiconductor/MMBT3904/)
Q20 |  | PNP-TRANSISTOR_SOT23 | SOT23 | PNP TRANSISTOR | MMBT3906LT3G (http://www.mouser.com/ProductDetail/ON-Semiconductor/MMBT3906LT3G/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)
Q21 |  | NPN-TRANSISTOR_SOT23 | SOT23 | NPN TRANSISTOR | MMBT3904 (http://www.mouser.com/ProductDetail/Fairchild-Semiconductor/MMBT3904/)
Q30 |  | PNP-TRANSISTOR_SOT23 | SOT23 | PNP TRANSISTOR | MMBT3906LT3G (http://www.mouser.com/ProductDetail/ON-Semiconductor/MMBT3906LT3G/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)
Q31 |  | NPN-TRANSISTOR_SOT23 | SOT23 | NPN TRANSISTOR | MMBT3904 (http://www.mouser.com/ProductDetail/Fairchild-Semiconductor/MMBT3904/)
Q40 |  | PNP-TRANSISTOR_SOT23 | SOT23 | PNP TRANSISTOR | MMBT3906LT3G (http://www.mouser.com/ProductDetail/ON-Semiconductor/MMBT3906LT3G/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)
Q41 |  | NPN-TRANSISTOR_SOT23 | SOT23 | NPN TRANSISTOR | MMBT3904 (http://www.mouser.com/ProductDetail/Fairchild-Semiconductor/MMBT3904/)
XTL1 |  | CRYSTALHC49S | HC49/S | CRYSTAL | ATS16B (http://www.mouser.com/ProductDetail/CTS-Electronic-Components/ATS16B/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)
XTL2 |  | CRYSTALHC49S | HC49/S | CRYSTAL | ATS16B (http://www.mouser.com/ProductDetail/CTS-Electronic-Components/ATS16B/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)
U$3 |  | NXT-SOCKETREGULAR | NXT-SOCKETREGULAR | NXT-SOCKET | Female Sockets (http://www.dexterindustries.com/NXTFemaleSockets.html)
U$4 |  | NXT-SOCKETREGULAR | NXT-SOCKETREGULAR | NXT-SOCKET | Female Sockets (http://www.dexterindustries.com/NXTFemaleSockets.html)
U$5 |  | NXT-SOCKETREGULAR | NXT-SOCKETREGULAR | NXT-SOCKET | Female Sockets (http://www.dexterindustries.com/NXTFemaleSockets.html)
U$7 |  | NXT-SOCKETREGULAR | NXT-SOCKETREGULAR | NXT-SOCKET | Female Sockets (http://www.dexterindustries.com/NXTFemaleSockets.html)
U$8 |  | NXT-SOCKETREGULAR | NXT-SOCKETREGULAR | NXT-SOCKET | Female Sockets (http://www.dexterindustries.com/NXTFemaleSockets.html)
U$9 |  | NXT-SOCKETREGULAR | NXT-SOCKETREGULAR | NXT-SOCKET | Female Sockets (http://www.dexterindustries.com/NXTFemaleSockets.html)
U$10 |  | NXT-SOCKETREGULAR | NXT-SOCKETREGULAR | NXT-SOCKET | Female Sockets (http://www.dexterindustries.com/NXTFemaleSockets.html)
U$11 |  | NXT-SOCKETREGULAR | NXT-SOCKETREGULAR | NXT-SOCKET | Female Sockets (http://www.dexterindustries.com/NXTFemaleSockets.html)
U$12 |  | NXT-SOCKETREGULAR | NXT-SOCKETREGULAR | NXT-SOCKET | Female Sockets (http://www.dexterindustries.com/NXTFemaleSockets.html)
R1 | 10k | RESISTOR0603-RES | 603 | Resistor | RK73B1JTTDD103J (http://www.mouser.com/ProductDetail/KOA-Speer/RK73B1JTTDD103J/)
R2 | 10k | RESISTOR0603-RES | 603 | Resistor | RK73B1JTTDD103J (http://www.mouser.com/ProductDetail/KOA-Speer/RK73B1JTTDD103J/)
R3 | 2k4 | RESISTOR0603-RES | 603 | Resistor | RK73B1JTTDD242J (http://www.mouser.com/ProductDetail/KOA-Speer/RK73B1JTTDD242J/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)
R4 | 10k | RESISTOR0603-RES | 603 | Resistor | RK73B1JTTDD103J (http://www.mouser.com/ProductDetail/KOA-Speer/RK73B1JTTDD103J/)
R6 | 4k7 | RESISTOR0603-RES | 603 | Resistor | RK73B1JTTDD472J (http://www.mouser.com/ProductDetail/KOA-Speer/RK73B1JTTDD472J/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)
R7 | 2k4 | RESISTOR0603-RES | 603 | Resistor | RK73B1JTTDD242J (http://www.mouser.com/ProductDetail/KOA-Speer/RK73B1JTTDD242J/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)
R8 | 220 | RESISTOR0603-RES | 603 | Resistor | RK73B1JTTDD221J (http://www.mouser.com/ProductDetail/KOA-Speer/RK73B1JTTDD221J/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)
R9 | 220 | RESISTOR0603-RES | 603 | Resistor | RK73B1JTTDD221J (http://www.mouser.com/ProductDetail/KOA-Speer/RK73B1JTTDD221J/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)
R10 | 10k | RESISTOR0603-RES | 603 | Resistor | RK73B1JTTDD103J (http://www.mouser.com/ProductDetail/KOA-Speer/RK73B1JTTDD103J/)
R11 | 4k7 | RESISTOR0603-RES | 603 | Resistor | RK73B1JTTDD472J (http://www.mouser.com/ProductDetail/KOA-Speer/RK73B1JTTDD472J/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)
R12 | 325 | RESISTOR1206 | 1206 | Resistor | CR1206-FX-3300ELF (http://www.mouser.com/ProductDetail/Bourns/CR1206-FX-3300ELF/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)
R13 | 4k7 | RESISTOR0603-RES | 603 | Resistor | RK73B1JTTDD472J (http://www.mouser.com/ProductDetail/KOA-Speer/RK73B1JTTDD472J/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)
R14 | 10k | RESISTOR0603-RES | 603 | Resistor | RK73B1JTTDD103J (http://www.mouser.com/ProductDetail/KOA-Speer/RK73B1JTTDD103J/)
R15 | 4k7 | RESISTOR0603-RES | 603 | Resistor | RK73B1JTTDD472J (http://www.mouser.com/ProductDetail/KOA-Speer/RK73B1JTTDD472J/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)
R20 | 10k | RESISTOR0603-RES | 603 | Resistor | RK73B1JTTDD103J (http://www.mouser.com/ProductDetail/KOA-Speer/RK73B1JTTDD103J/)
R21 | 4k7 | RESISTOR0603-RES | 603 | Resistor | RK73B1JTTDD472J (http://www.mouser.com/ProductDetail/KOA-Speer/RK73B1JTTDD472J/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)
R22 | 325 | RESISTOR1206 | 1206 | Resistor | CR1206-FX-3300ELF (http://www.mouser.com/ProductDetail/Bourns/CR1206-FX-3300ELF/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)
R23 | 4k7 | RESISTOR0603-RES | 603 | Resistor | RK73B1JTTDD472J (http://www.mouser.com/ProductDetail/KOA-Speer/RK73B1JTTDD472J/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)
R24 | 10k | RESISTOR0603-RES | 603 | Resistor | RK73B1JTTDD103J (http://www.mouser.com/ProductDetail/KOA-Speer/RK73B1JTTDD103J/)
R25 | 4k7 | RESISTOR0603-RES | 603 | Resistor | RK73B1JTTDD472J (http://www.mouser.com/ProductDetail/KOA-Speer/RK73B1JTTDD472J/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)
R30 | 10k | RESISTOR0603-RES | 603 | Resistor | RK73B1JTTDD103J (http://www.mouser.com/ProductDetail/KOA-Speer/RK73B1JTTDD103J/)
R31 | 4k7 | RESISTOR0603-RES | 603 | Resistor | RK73B1JTTDD472J (http://www.mouser.com/ProductDetail/KOA-Speer/RK73B1JTTDD472J/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)
R32 | 325 | RESISTOR1206 | 1206 | Resistor | CR1206-FX-3300ELF (http://www.mouser.com/ProductDetail/Bourns/CR1206-FX-3300ELF/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)
R33 | 4k7 | RESISTOR0603-RES | 603 | Resistor | RK73B1JTTDD472J (http://www.mouser.com/ProductDetail/KOA-Speer/RK73B1JTTDD472J/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)
R34 | 10k | RESISTOR0603-RES | 603 | Resistor | RK73B1JTTDD103J (http://www.mouser.com/ProductDetail/KOA-Speer/RK73B1JTTDD103J/)
R35 | 4k7 | RESISTOR0603-RES | 603 | Resistor | RK73B1JTTDD472J (http://www.mouser.com/ProductDetail/KOA-Speer/RK73B1JTTDD472J/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)
R40 | 10k | RESISTOR0603-RES | 603 | Resistor | RK73B1JTTDD103J (http://www.mouser.com/ProductDetail/KOA-Speer/RK73B1JTTDD103J/)
R41 | 4k7 | RESISTOR0603-RES | 603 | Resistor | RK73B1JTTDD472J (http://www.mouser.com/ProductDetail/KOA-Speer/RK73B1JTTDD472J/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)
R42 | 325 | RESISTOR1206 | 1206 | Resistor | CR1206-FX-3300ELF (http://www.mouser.com/ProductDetail/Bourns/CR1206-FX-3300ELF/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)
R43 | 4k7 | RESISTOR0603-RES | 603 | Resistor | RK73B1JTTDD472J (http://www.mouser.com/ProductDetail/KOA-Speer/RK73B1JTTDD472J/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)
R44 | 10k | RESISTOR0603-RES | 603 | Resistor | RK73B1JTTDD103J (http://www.mouser.com/ProductDetail/KOA-Speer/RK73B1JTTDD103J/)
R45 | 4k7 | RESISTOR0603-RES | 603 | Resistor | RK73B1JTTDD472J (http://www.mouser.com/ProductDetail/KOA-Speer/RK73B1JTTDD472J/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)
R52 | 325 | RESISTOR1206 | 1206 | Resistor | NOT FILLED
PI_OUTLINE | RASPBERRY-PI | RASPBERRY-PI | RASPBERRY-PI | Raspberry Pi Adapter | Stacking Header 2x13 Extra Tall (http://www.adafruit.com/products/1112)
SJ1 | SOLDERJUMPERNO | SOLDERJUMPERNO | SJ_2 | Solder Jumper | NOT FILLED
FTDI-HEADER |  | M06LOCK | 1X06_LOCK | Header 6 | NOT FILLED
J1 | AVR_SPI_PRG_62X3_LOCK | AVR_SPI_PRG_62X3_LOCK | 2X3_LOCK | AVR ISP 6 Pin | NOT FILLED
J2 | AVR_SPI_PRG_62X3_LOCK | AVR_SPI_PRG_62X3_LOCK | 2X3_LOCK | AVR ISP 6 Pin | NOT FILLED
JP1 |  | M03LOCK | 1X03_LOCK | Header 3 | NOT FILLED
C7 | 120uF |  |  |  | EEU-FC1C121 (http://in.mouser.com/ProductDetail/Panasonic-Electronic-Components/EEU-FC1C121/)
C9 | 1000uF |  |  |  | B41827A3108M8 (http://in.mouser.com/ProductDetail/EPCOS/B41827A3108M8/)
D1 | DIODE_SCHOTTKY_VS-6CWQ04FNTRPBF | DIODE_SCHOTTKY_VS-6CWQ04FNTRPBF | DPAK |  | VS-6CWQ04FNTRPBF (http://in.mouser.com/ProductDetail/Vishay-Semiconductors/VS-6CWQ04FNTRPBF/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)
IC5 | LM2576 |  |  |  | LM2576T-005G (http://in.mouser.com/ProductDetail/ON-Semiconductor/LM2576T-005G/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)
U$14 | INDUCTOR_PULSE_P0250.XXXNL | INDUCTOR_PULSE_P0250.XXXNL | INDUCTOR_PULSE_P0250.XXXNL |  | P0250.104NLT (http://in.mouser.com/ProductDetail/Pulse/P0250104NLT/)
