DexterInd/BrickPi/Hardware Design/BrickPi BOM 0.7.xlsx

Part | Value | Device | Package | Description | Part Number and Link | Cost
C1 | 0.10 uF | CAP0805 | 805 | Capacitor | C0805C104M3RACTU (http://in.mouser.com/ProductDetail/Kemet/C0805C104M3RACTU/) | $0.10
C2 | 0.10 uF | CAP0805 | 805 | Capacitor | C0805C104M3RACTU (http://in.mouser.com/ProductDetail/Kemet/C0805C104M3RACTU/) | $0.10
C3 | 0.10 uF | CAP0805 | 805 | Capacitor | C0805C104M3RACTU (http://in.mouser.com/ProductDetail/Kemet/C0805C104M3RACTU/) | $0.10
C4 | 10 uF | CAP0805 | 805 | Capacitor | 603-CC805ZKY5V6BB106 (http://www.mouser.com/ProductDetail/Yageo/CC0805ZKY5V6BB106/) | $0.10
C5 | 10 uF | CAP0805 | 805 | Capacitor | 603-CC805ZKY5V6BB106 (http://www.mouser.com/ProductDetail/Yageo/CC0805ZKY5V6BB106/) | $0.10
IC1 | 7805T | 7805T | TO220H | Positive VOLTAGE REGULATOR | 512-LM7805ACT (http://www.mouser.com/ProductDetail/Fairchild-Semiconductor/LM7805ACT/) | $0.69
F1 | PTCSMD | PTCSMD | PTC-1206 | Resettable Fuse PTC | 1206L150THWR (http://www.mouser.com/ProductDetail/Littelfuse/1206L150THWR/) | $0.53
J1 | AVR_SPI_PRG_62X3_LOCK | AVR_SPI_PRG_62X3_LOCK | 2X3_LOCK | AVR ISP 6 Pin | 538-10-89-7061 (https://www.mouser.com/Search/ProductDetail.aspx) | $0.70
JP1 |  | M02LOCK | 1X02_LOCK | Header 2 | Not Needed | $0.00
JP2 | FTDI_DEVICE | FTDI_DEVICE | FTDI_DEVICE_SIDE |  | Not Needed | $0.00
LED1 |  | LED1206 | LED-1206 | LEDs | 638-172BHC-AN1P23T (https://www.mouser.com/Search/ProductDetail.aspx) | $0.25
LED2 |  | LED1206 | LED-1206 | LEDs | 638-172BHC-AN1P23T (https://www.mouser.com/Search/ProductDetail.aspx) | $0.25
MC1 | SN754410 | SN754410 | DIL16 | Quad Half-Bridge | 595-SN754410NE (https://www.mouser.com/Search/ProductDetail.aspx) | $2.16
MC2 | SN754410 | SN754410 | DIL16 | Quad Half-Bridge | 595-SN754410NE (https://www.mouser.com/Search/ProductDetail.aspx) | $2.16
MOTOR_1 | YH-55-10 | YH-55-10 | YH-55-10 | RJ11 6 connects | NXT Female Socket (http://www.dexterindustries.com/NXTFemaleSockets.html) | $0.75
MOTOR_2 | YH-55-10 | YH-55-10 | YH-55-10 | RJ11 6 connects | NXT Female Socket (http://www.dexterindustries.com/NXTFemaleSockets.html) | $0.75
MOTOR_3 | YH-55-10 | YH-55-10 | YH-55-10 | RJ11 6 connects | NXT Female Socket (http://www.dexterindustries.com/NXTFemaleSockets.html) | $0.75
PI_OUTLINE | RASPBERRY-PI | RASPBERRY-PI | RASPBERRY-PI | Raspberry Pi Adapter | Stacking Header for Raspberry Pi - 2x13 Extra Tall (http://www.adafruit.com/products/1112) | $1.95
R1 | 220 | 220-5% | 0603-RES |  | RK73H1HTTC2200F (http://www.mouser.com/ProductDetail/KOA-Speer/RK73H1HTTC2200F/) | $0.07
R2 | 220 | 220-5% | 0603-RES |  | RK73H1HTTC2200F (http://www.mouser.com/ProductDetail/KOA-Speer/RK73H1HTTC2200F/) | $0.07
R3 | 43k |  | 0603-RES |  | RK73B1HTTC433J (http://www.mouser.com/ProductDetail/KOA-Speer/RK73B1HTTC433J/) | $0.07
R4 | 43k |  | 0603-RES |  | RK73B1HTTC433J (http://www.mouser.com/ProductDetail/KOA-Speer/RK73B1HTTC433J/) | $0.07
R5 | 10k |  | 0603-RES |  | RK73H1HTTC1002F (http://www.mouser.com/ProductDetail/KOA-Speer/RK73H1HTTC1002F/) | $0.07
R6 | 10k |  | 0603-RES |  | RK73H1HTTC1002F (http://www.mouser.com/ProductDetail/KOA-Speer/RK73H1HTTC1002F/) | $0.07
R7 | 10k |  | 0603-RES |  | RK73H1HTTC1002F (http://www.mouser.com/ProductDetail/KOA-Speer/RK73H1HTTC1002F/) | $0.07
R8 | 10k |  | 0603-RES |  | RK73H1HTTC1002F (http://www.mouser.com/ProductDetail/KOA-Speer/RK73H1HTTC1002F/) | $0.07
R9 | 10k |  | 0603-RES |  | RK73H1HTTC1002F (http://www.mouser.com/ProductDetail/KOA-Speer/RK73H1HTTC1002F/) | $0.07
R10 | 1k |  | 0603-RES |  | CR0201-JW-102GLF (http://www.mouser.com/ProductDetail/Bourns/CR0201-JW-102GLF/) | $0.06
R11 | 1k |  | 0603-RES |  | CR0201-JW-102GLF (http://www.mouser.com/ProductDetail/Bourns/CR0201-JW-102GLF/) | $0.06
SENSOR_1 | YH-55-10 | YH-55-10 | YH-55-10 | RJ11 6 connects | NXT Female Socket (http://www.dexterindustries.com/NXTFemaleSockets.html) | $0.75
SENSOR_2 | YH-55-10 | YH-55-10 | YH-55-10 | RJ11 6 connects | NXT Female Socket (http://www.dexterindustries.com/NXTFemaleSockets.html) | $0.75
SENSOR_3 | YH-55-10 | YH-55-10 | YH-55-10 | RJ11 6 connects | NXT Female Socket (http://www.dexterindustries.com/NXTFemaleSockets.html) | $0.75
SENSOR_4 | YH-55-10 | YH-55-10 | YH-55-10 | RJ11 6 connects | NXT Female Socket (http://www.dexterindustries.com/NXTFemaleSockets.html) | $0.75
U1 | ATMEGA328P | ATMEGA328_SMT | TQFP32-08 | 32-Pin Atmega328 | 556-ATMEGA328P-AU (https://www.mouser.com/Search/ProductDetail.aspx) | $3.05
Y1 | RESONATORSMD | RESONATORSMD | RESONATOR-SMD | Resonator | 81-CSTCE16M0V53-R0 (https://www.mouser.com/Search/ProductDetail.aspx) | $0.96
 | 9V Battery Adapter |  |  |  | 123-5006/M-GR (http://www.mouser.com/Search/ProductDetail.aspx) | $0.53
 |  |  |  |  | Total: | $19.73
