DexterInd/BrickPi/Models/Tank/Tank_BOM.xlsx

Brick | Name | Picture | Part | Color code | Quantity
4297210 | RIM WIDE W.CROSS 30x20 |  | 56145 | 194 - Medium Stone Grey | 4
4502834 | CATERPILLAR TRACK |  | 53992 | 26 - Black | 2
6024583 | CABLE 350 MM |  | 11146 | 40 - Transparent, 26 - Black | 2
4297008 | Tacho Motor |  | 53787 | 208 - Light Stone Grey, 199 - Dark Stone Grey, 106 - Bright Orange | 2
4297199 | TECHNIC 7M BEAM |  | 32524 | 208 - Light Stone Grey | 2
4168114 | TECHNIC ANG. BEAM 4X2 90 DEG |  | 32140 | 23 - Bright Blue | 2
4297202 | TECHNIC 9M BEAM |  | 40490 | 208 - Light Stone Grey | 2
4522937 | TECHNIC 13M BEAM |  | 41239 | 199 - Dark Stone Grey | 1
4297203 | TECHNIC 13M BEAM |  | 41239 | 208 - Light Stone Grey | 2
4297197 | TECHNIC 15M BEAM |  | 32278 | 208 - Light Stone Grey | 2
4210753 | TECHNIC ANG. BEAM 3X5 90 DEG. |  | 32526 | 199 - Dark Stone Grey | 2
4210668 | DOUBLE ANGULAR BEAM 3X7 45° |  | 32009 | 199 - Dark Stone Grey | 4
4239601 | 1/2 BUSH |  | 32123 | 24 - Bright Yellow | 4
4121715 | CONNECTOR PEG W. FRICTION |  | 2780 | 26 - Black | 22
4211622 | BUSH FOR CROSS AXLE |  | 6590 | 194 - Medium Stone Grey | 2
4206482 | CONN.BUSH W.FRIC./CROSSALE |  | 43093 | 23 - Bright Blue | 4
4514553 | CONNECTOR PEG W. FRICTION 3M |  | 6558 | 23 - Bright Blue | 2
6031821 | CROSSAXLE 3M WITH KNOB |  | 6587 | 138 - Sand Yellow | 2
4211639 | CROSS AXLE 5M |  | 32073 | 194 - Medium Stone Grey | 2
370626 | CROSS AXLE 6M |  | 3706 | 26 - Black | 2
4296059 | Angular beam 90degr. w.4 snaps |  | 55615 | 194 - Medium Stone Grey | 6
Total:
