DexterInd/BrickPi/Models/SimpleBot/simplebot_bom.xlsx

Brick | Name | Picture | Part | Color code | Quantity
4297210 | RIM WIDE W.CROSS 30x20 |  | 56145 | 194 - Medium Stone Grey | 4
4297209 | TYRE BALOON WIDE Ø56 X 26 |  | 55976 | 26 - Black | 2
4297185 | Cable 495 mm |  | 55806 | 40 - Transparent, 26 - Black | 1
4297008 | Tacho Motor |  | 53787 | 208 - Light Stone Grey, 199 - Dark Stone Grey, 106 - Bright Orange | 2
4297202 | TECHNIC 9M BEAM |  | 40490 | 208 - Light Stone Grey | 2
4522937 | TECHNIC 13M BEAM |  | 41239 | 199 - Dark Stone Grey | 1
4297203 | TECHNIC 13M BEAM |  | 41239 | 208 - Light Stone Grey | 1
4210753 | TECHNIC ANG. BEAM 3X5 90 DEG. |  | 32526 | 199 - Dark Stone Grey | 2
4211573 | 1/2 BUSH |  | 32123 | 194 - Medium Stone Grey | 1
4121715 | CONNECTOR PEG W. FRICTION |  | 2780 | 26 - Black | 16
4211815 | CROSS AXLE 3M |  | 4519 | 194 - Medium Stone Grey | 2
4666579 | CONNECTOR PEG/CROSS AXLE |  | 6562 | 5 - Brick Yellow | 2
4211622 | BUSH FOR CROSS AXLE |  | 6590 | 194 - Medium Stone Grey | 2
4211639 | CROSS AXLE 5M |  | 32073 | 194 - Medium Stone Grey | 2
4121667 | DOUBLE CROSS BLOCK |  | 32184 | 26 - Black | 2
4296059 | Angular beam 90degr. w.4 snaps |  | 55615 | 194 - Medium Stone Grey | 4
Total:
