DexterInd/BrickPi/Models/Robotic_Arm/arm_Bill_Of_Materials.xlsx

Brick | Name | Picture | Part | Color code | Quantity
4297187 | Cable 208mm |  | 55804 | 40 - Transparent, 26 - Black | 2
4297188 | Cable 368 mm |  | 55805 | 40 - Transparent, 26 - Black | 1
4297008 | Tacho Motor |  | 53787 | 208 - Light Stone Grey, 199 - Dark Stone Grey, 106 - Bright Orange | 3
4211655 | TECHNIC 3M BEAM |  | 32523 | 194 - Medium Stone Grey | 4
4140465 | TECHNIC 5M BEAM |  | 32316 | 1 - White | 2
4297199 | TECHNIC 7M BEAM |  | 32524 | 208 - Light Stone Grey | 3
4142969 | TECHNIC 7M BEAM |  | 32524 | 1 - White | 1
4211610 | TECHNIC ANG. BEAM 4X2 90 DEG |  | 32140 | 194 - Medium Stone Grey | 2
 | TECHNIC 9M BEAM |  | 40490 | 1 - White | 4
4156151 | TECHNIC 11M BEAM |  | 32525 | 194 - Medium Stone Grey | 2
4297203 | TECHNIC 13M BEAM |  | 41239 | 208 - Light Stone Grey | 1
4203517 | TECHNIC 13M BEAM |  | 41239 | 1 - White | 3
4297197 | TECHNIC 15M BEAM |  | 32278 | 208 - Light Stone Grey | 2
4141998 | TECHNIC 15M BEAM |  | 32278 | 1 - White | 2
4211713 | TECHNIC ANG. BEAM 3X5 90 DEG. |  | 32526 | 194 - Medium Stone Grey | 3
4234240 | DOUBLE ANGULAR BEAM 3X7 45° |  | 32009 | 194 - Medium Stone Grey | 4
278026 | CONNECTOR PEG W. FRICTION |  | 2780 | 26 - Black | 16
 | CONNECTOR PEG |  | 3673 | 26 - Black | 2
4211807 | CONNECTOR PEG |  | 3673 | 194 - Medium Stone Grey | 2
4129886 | CONNECTOR PEG |  | 3673 | 23 - Bright Blue | 24
4211815 | CROSS AXLE 3M |  | 4519 | 194 - Medium Stone Grey | 4
4211808 | CONNECTOR PEG/CROSS AXLE |  | 6562 | 194 - Medium Stone Grey | 3
4225927 | CONNECTOR PEG/CROSS AXLE |  | 6562 | 23 - Bright Blue | 3
4211622 | BUSH FOR CROSS AXLE |  | 6590 | 194 - Medium Stone Grey | 2
4174429 | CONN.BUSH W.FRIC./CROSSALE |  | 43093 | 1 - White | 1
4189110 | CONN.BUSH W.FRIC./CROSSALE |  | 43093 | 23 - Bright Blue | 8
655826 | CONNECTOR PEG W. FRICTION 3M |  | 6558 | 26 - Black | 8
4514553 | CONNECTOR PEG W. FRICTION 3M |  | 6558 | 23 - Bright Blue | 6
4211709 | 3M CONNECTOR PEG |  | 32556 | 194 - Medium Stone Grey | 1
4114740 | CROSS AXLE 5M |  | 32073 | 26 - Black | 1
370626 | CROSS AXLE 6M |  | 3706 | 26 - Black | 1
4211865 | 2M FRIC. SNAP W/CROSS HOLE |  | 32054 | 194 - Medium Stone Grey | 1
4121667 | DOUBLE CROSS BLOCK |  | 32184 | 26 - Black | 4
370726 | CROSS AXLE 8M |  | 3707 | 26 - Black | 2
4211779 | CROSS BLOCK 3M |  | 42003 | 194 - Medium Stone Grey | 2
4225033 | BEAM 3 M. W/4 SNAPS |  | 48989 | 194 - Medium Stone Grey | 2
4296059 | Angular beam 90degr. w.4 snaps |  | 55615 | 194 - Medium Stone Grey | 2
4140436 | GEAR WHEEL T=8, M=1 |  | 3647 | 1 - White | 2
4211433 | GEAR WHEEL 40T |  | 3649 | 194 - Medium Stone Grey | 1
4235858 | TURNTABLE 4.85 |  | 50163 | 26 - Black, 199 - Dark Stone Grey | 1
4548553 | DESIGN SHELL W. RIBS Ø4.85 |  | 61069 | 208 - Light Stone Grey | 2
4617728 | Tool 4x12 nr. 4 |  | 50914 | 315 - Silver Metallic | 4
Total:
