DexterInd/BrickPi/Models/WIFI_Car/WiFi-Car-BOM.xlsx

Brick | Name | Picture | Part | Color code | Quantity
4211544 | WEDGE-BELT WHEEL Ø24 |  | 4185 | 194 - Medium Stone Grey | 1
4297210 | RIM WIDE W.CROSS 30x20 |  | 56145 | 194 - Medium Stone Grey | 2
4297209 | TYRE BALOON WIDE Ø56 X 26 |  | 55976 | 26 - Black | 2
4297187 | Cable 208mm |  | 55804 | 40 - Transparent, 26 - Black | 2
4297188 | Cable 368 mm |  | 55805 | 40 - Transparent, 26 - Black | 1
4297174 | Ultrasound sensor |  | 53792 | 208 - Light Stone Grey, 199 - Dark Stone Grey, 194 - Medium Stone Grey, 106 - Bright Orange | 1
4297008 | Tacho Motor |  | 53787 | 208 - Light Stone Grey, 199 - Dark Stone Grey, 106 - Bright Orange | 2
4210686 | TECHNIC 5M BEAM |  | 32316 | 199 - Dark Stone Grey | 2
4297199 | TECHNIC 7M BEAM |  | 32524 | 208 - Light Stone Grey | 2
4297202 | TECHNIC 9M BEAM |  | 40490 | 208 - Light Stone Grey | 2
4522937 | TECHNIC 13M BEAM |  | 41239 | 199 - Dark Stone Grey | 1
4297203 | TECHNIC 13M BEAM |  | 41239 | 208 - Light Stone Grey | 2
4297197 | TECHNIC 15M BEAM |  | 32278 | 208 - Light Stone Grey | 2
4210753 | TECHNIC ANG. BEAM 3X5 90 DEG. |  | 32526 | 199 - Dark Stone Grey | 4
4210668 | DOUBLE ANGULAR BEAM 3X7 45° |  | 32009 | 199 - Dark Stone Grey | 2
4211573 | 1/2 BUSH |  | 32123 | 194 - Medium Stone Grey | 1
4121715 | CONNECTOR PEG W. FRICTION |  | 2780 | 26 - Black | 22
4211815 | CROSS AXLE 3M |  | 4519 | 194 - Medium Stone Grey | 1
4211622 | BUSH FOR CROSS AXLE |  | 6590 | 194 - Medium Stone Grey | 1
4206482 | CONN.BUSH W.FRIC./CROSSALE |  | 43093 | 23 - Bright Blue | 7
370526 | CROSS AXLE 4M |  | 3705 | 26 - Black | 2
655826 | CONNECTOR PEG W. FRICTION 3M |  | 6558 | 26 - Black | 2
4514553 | CONNECTOR PEG W. FRICTION 3M |  | 6558 | 23 - Bright Blue | 2
4211639 | CROSS AXLE 5M |  | 32073 | 194 - Medium Stone Grey | 1
4211865 | 2M FRIC. SNAP W/CROSS HOLE |  | 32054 | 194 - Medium Stone Grey | 4
4121667 | DOUBLE CROSS BLOCK |  | 32184 | 26 - Black | 2
4211779 | CROSS BLOCK 3M |  | 42003 | 194 - Medium Stone Grey | 2
4225033 | BEAM 3 M. W/4 SNAPS |  | 48989 | 194 - Medium Stone Grey | 1
4296059 | Angular beam 90degr. w.4 snaps |  | 55615 | 194 - Medium Stone Grey | 6
Total: |  |  |  |  | 82
