DexterInd/BrickPi/Firmware_BrickPi/Old_Firmware/BrickPi_Firmware_3_0/How to enable I2C.txt

https://projects.drogon.net/raspberry-pi/wiringpi/i2c-library/

Install:
	sudo apt-get install libi2c-dev

Load and optionally set speed (in k baud):
	gpio load i2c 10
