DexterInd/BrickPi/Software/BrickPi_Python/Project_Examples/Thingspeak Temperature Logging/Thingspeak- Pictures/Thingspeak - Step 1 - Highlighted.PNG

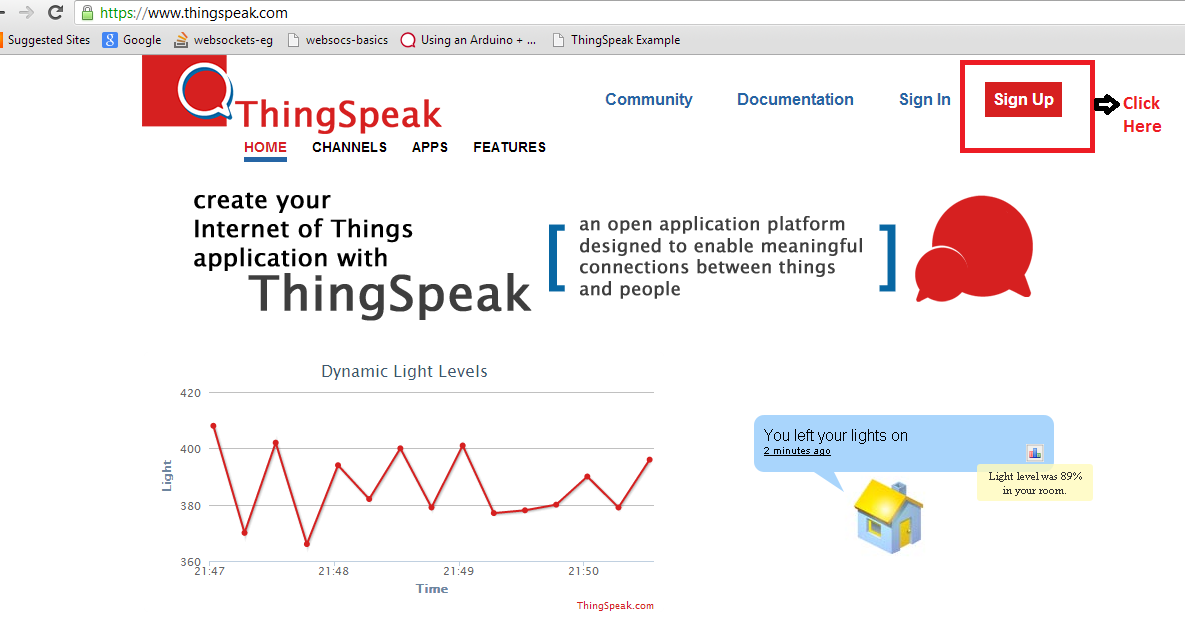
Software/BrickPi_Python/Project_Examples/Thingspeak Temperature Logging/Thingspeak- Pictures/Thingspeak - Step 1 - Highlighted.PNG
