DexterInd/BrickPi/Software/BrickPi_Python/Project_Examples/Thingspeak Temperature Logging/Thingspeak- Pictures/Thingspeak - Step 2 - Highlighted.png

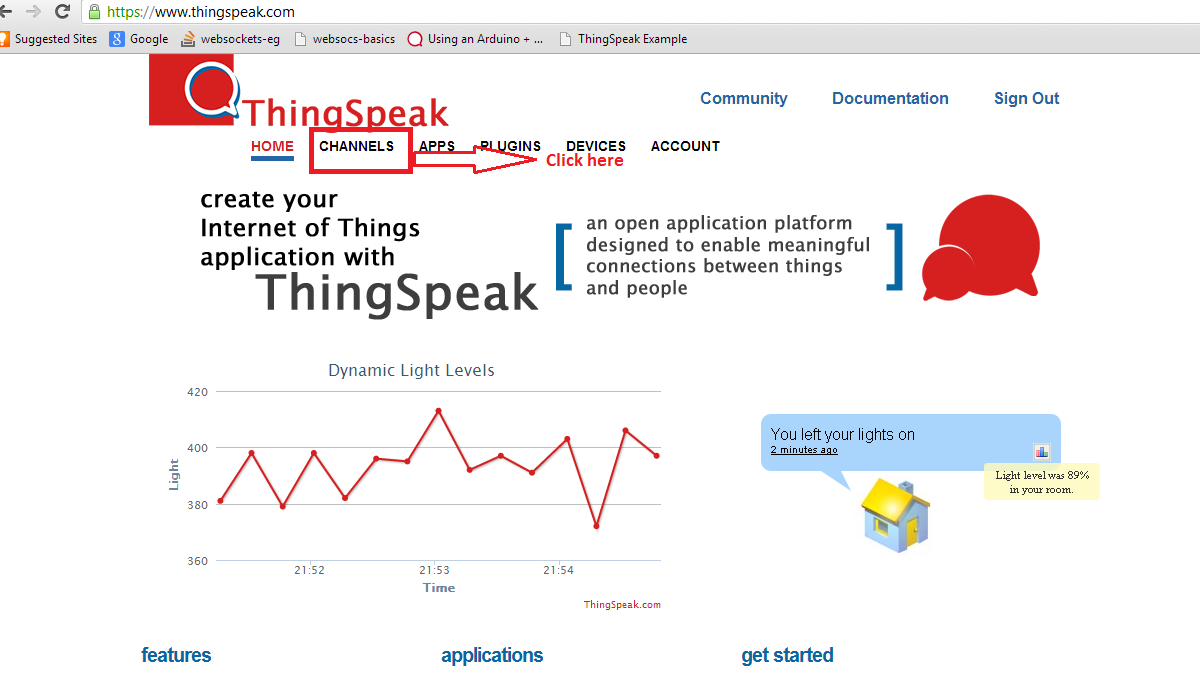
Software/BrickPi_Python/Project_Examples/Thingspeak Temperature Logging/Thingspeak- Pictures/Thingspeak - Step 2 - Highlighted.png
