DexterInd/BrickPi/Software/BrickPi_Python/Project_Examples/browserStreamingRobot/profile-results.xlsx

Sheet: with camera
918/354 | 0.091 | 0 | 0.112 | 0 | sre_parse.py:140(getwidth)
89/86 | 0.003 | 0 | 0.015 | 0 | concurrent.py:138(set_result)
89/86 | 0.003 | 0 | 0.012 | 0 | concurrent.py:173(_set_done)
78/77 | 0.011 | 0 | 0.664 | 0.009 | sre_parse.py:663(parse)
68/55 | 0.001 | 0 | 0.012 | 0 | {issubclass}
643/77 | 0.167 | 0 | 0.481 | 0.006 | sre_compile.py:32(_compile)
591/550 | 0.044 | 0 | 0.649 | 0.001 | {next}
43/20 | 0.013 | 0 | 0.664 | 0.033 | gen.py:150(wrapper)
39/30 | 0.001 | 0 | 0.64 | 0.021 | {method | 'send' | of | 'generator' | objects}
38/29 | 0.009 | 0 | 0.662 | 0.023 | gen.py:612(run)
33/28 | 0.005 | 0 | 0.333 | 0.012 | gen.py:560(__init__)
327/81 | 0.236 | 0.001 | 0.634 | 0.008 | sre_parse.py:379(_parse)
242/78 | 0.033 | 0 | 0.642 | 0.008 | sre_parse.py:301(_parse_sub)
234/233 | 0.053 | 0 | 0.152 | 0.001 | {method | 'encode' | of | 'unicode' | objects}
19/17 | 0.005 | 0 | 0.015 | 0.001 | abc.py:148(__subclasscheck__)
16856 | 0.183 | 0 | 0.183 | 0 | {method | 'append' | of | 'list' | objects}
7778 | 0.036 | 0 | 0.036 | 0 | {ord}
6372 | 0.326 | 0 | 0.962 | 0 | {isinstance}
5916 | 0.226 | 0 | 0.226 | 0 | {range}
5138 | 0.082 | 0 | 0.082 | 0 | {chr}
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
