DexterInd/BrickPi/High Altitude Ballooning Project/debug.txt

Image taken
File not found!  Rebooting!
0
Image taken
File not found!  Rebooting!
0
Image taken
File not found!  Rebooting!
0
Image taken
File not found!  Rebooting!
0
Image taken
File not found!  Rebooting!
0
Image taken
File not found!  Rebooting!
0
Image taken
File not found!  Rebooting!
0
Image taken
File not found!  Rebooting!
0
Image taken
File not found!  Rebooting!
0
Image taken
File not found!  Rebooting!
0
Image taken
File not found!  Rebooting!
0
Image taken
File not found!  Rebooting!
0
Image taken
File not found!  Rebooting!
0
Image taken
File not found!  Rebooting!
0
Image taken
File not found!  Rebooting!
0
Image taken
File not found!  Rebooting!
0
Image taken
File not found!  Rebooting!
0
Image taken
File not found!  Rebooting!
0
Image taken
File not found!  Rebooting!
0
Image taken
File not found!  Rebooting!
0
Image taken
File not found!  Rebooting!
0
Image taken
File not found!  Rebooting!
0
Image taken
File not found!  Rebooting!
0
Image taken
File not found!  Rebooting!
0
Image taken
File not found!  Rebooting!
0
Image taken
File not found!  Rebooting!
0
Image taken
File not found!  Rebooting!
0
Image taken
File not found!  Rebooting!
0
Image taken
File not found!  Rebooting!
0
Image taken
File not found!  Rebooting!
0
Image taken
File not found!  Rebooting!
0
Image taken
File not found!  Rebooting!
0
Image taken
File not found!  Rebooting!
0
Image taken
File not found!  Rebooting!
0
Image taken
File not found!  Rebooting!
0
Image taken
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
File not found!  Rebooting!
115736
Image taken /media/DiskGO_/1600_115739.jpg
File not found!  Rebooting!
115739
Image taken /media/DiskGO_/1601_120315.jpg
Found File
Image taken /media/DiskGO_/1602_120327.jpg
Found File
Image taken /media/DiskGO_/1603_120339.jpg
Found File
