DexterInd/BrickPi/(threads)

Thread 24 (2015-05-10):

Timing issues with EV3 UART sensors.

dlech, 2015-05-10:
I've notice that the EV3 UART sensors return an error value quite often instead of the sensor value. Usually, the value is -2, and sometimes -4. I can see these are error values returned by the [EV3_Update](https://github.com/DexterInd/BrickPi/blob/026c85efd3aceaa17efa1c3b72a646be6d614b32/Firmware_BrickPi/Firmware_2.0/BrickPiEV3/BrickPiEV3.cpp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) function. I stuck my logic analyzer on it and immediately saw the problem.

Normally, the timing works like this...

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

1. The RPi polls the BrickPi by executing the BrickPiUpdateValues function.
2. The BrickPi sends a keep-alive (called NAK in the code) to the UART sensor.
3. The UART sensor sends back data in response to keep-alive.
4. The BrickPi sends the data back to the RPi.

However, quite often, this happens...

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

1. The RPi polls the BrickPi by executing the BrickPiUpdateValues function.
2. The BrickPi sends a keep-alive (called NAK in the code) to the UART sensor.
3. (This happens after 4, which is too late.) The UART sensor sends back data in response to keep-alive.
4. The BrickPi sends the data back an error because there was not data to be read.

---

It seems that this happens most often when data value is changing rapidly. A couple of easy fixes would be to A) wait a bit longer for the UART sensor to respond before sending an error or B) send the previous value received.

---

I've worked around this for now by filtering out the error values, but it makes the sensor unresponsive for noticeable periods of time, which does not make for good robot building. Also, some of the sensors can return negative values in certain modes, so I also have to filter out possibly good data in those modes, which is not nice.

dlech, 2015-05-10:
The hard fix would be to make receiving the UART data in the BrickPi happen asynchronously and cache the most recent value. Then the EV3_Update function could always just return the most recent value without having to wait for a send and receive to/from the UART sensor.

guervillep, 2016-03-22:
In file BrickPiEV3.cpp line 176, we check that at least one byte is available before reading it line 178.
Line 183, we read the remaining of the message from the EV3 sensor without checking that it is already available.

Could it be the reason of all these error values ?

dlech, 2016-03-22:
What happens is that no data is available in line 176, so `sensor1.available()` is false and the function returns `-4` at line 203.

It been so long since I looked at this, I don't remember if I was also seeing a `-2` error or how frequently.

guervillep, 2016-03-22:
In your first comment of this issue you said "Usually, the value is -2, and sometimes -4" (top of this page).

I definitively suspect this piece of code to be the source of the read errors with EV3 sensors.

kortschak, 2016-05-14:
I've just stumbled across this problem. Is there any intention in @DexterInd to fix this? The device is being sold as something that ["works with all NXT and EV3 sensors and motors."](http://www.dexterindustries.com/BrickPi/)

DexterInd, 2016-05-15:
@kortschak it's something we're working on.  Yes, we have intention to fix it.

kortschak, 2017-09-20:
@DexterInd, what is the time-frame for this?

Thread 25 (2015-05-10):

LEGO EV3 Color sensor RGB-RAW mode.

dlech, 2015-05-10:
The `RGB-RAW` mode of the LEGO EV3 Color sensor (UART) always returns a bad checksum. The checksum should be ignored in this mode so that it can be used.

References:
* https://github.com/ev3dev/lego-linux-drivers/blob/master/sensors/ev3_uart_sensor_ld.c#L601
* https://github.com/mindboards/ev3sources/pull/30

Thread 28 (2016-03-24):

What is the right layout to connect sensor & motors

jabrena, 2016-03-24:
Good morning,

I am doing some tests with Brickpi+ for the project:
https://github.com/ev3dev-lang-java/ev3dev-lang-java

and I am not sure what is the best way to connect sensors & motors for brickpi v2.8:

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

In the documentation on the website appear other layout:
http://www.dexterindustries.com/BrickPi/getting-started/attaching-lego/

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

with 5 sensors, but in my board in the position of the 5th sensor, I have the energy connector.
Following other images, I notice that the first row of RJ45 input is for motors and the rest of the connectors is for sensors, isn't it?

Juan Antonio

jabrena, 2016-03-24:
This layout to connect sensor & motors is right?

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

DexterInd, 2016-03-24:
The picture you've got above is for the BrickPi Advanced, the older version (no longer sold).  I'll get an updated picture up there asap.  Thanks for pointing this out!

DexterInd, 2016-03-27:
This should be updated now.  Thanks or the heads up and reminder!

jabrena, 2016-03-27:
No problem :)

Closed 2016-03-24.

Thread 33 (2017-01-10):

How to see Brickpi firmware version?

jabrena, 2017-01-10:
I would like to know, some way to read the version of BrickPi firmware.

Many thanks in advance.

Juan Antonio

dlech, 2017-01-10:
https://github.com/DexterInd/BrickPi_Python/blob/a8452123a23e610382f7f18bf4950f2f2a787de6/Sensor_Examples/EV3-Firmware_Check.py

DexterInd, 2017-01-11:
Indeed, you run the file @dlech recommends and it should help you figure out which version of firmware you're board is running.

Closed 2017-01-11.

Thread 40 (2017-04-13):

Run according to readme get error

totalrisp, 2017-04-13:
Clone git and follow webpage's instructions:

`$ python RPi_Server_Code.py
Traceback (most recent call last):
  File "RPi_Server_Code.py", line 38, in <module>
    from BrickPi import * #import BrickPi.py file to use BrickPi operations
ImportError: No module named BrickPi
`

Thread 45 (2018-02-19):

gpio package dependency missing

dothebart, 2018-02-19:
while others are apt'ed these packages seem to be missing:

Dependencies installed
Installing WiringPi
===================
/home/pi/Dexter/lib/Dexter/script_tools/update_wiringpi.sh: line 11: gpio: command not found
wiringPi VERSION is
/home/pi/Dexter/lib/Dexter/script_tools/update_wiringpi.sh: line 30: [: -eq: unary operator expected
Did NOT find WiringPi Version 2.36

Thread 47 (2019-09-05):

Incorrect rotational Speed with EV3 Gyro

zipper555, 2019-09-05:
The mode TYPE_SENSOR_EV3_GYRO_M1 doesn't give the rotational speed, it instead reads out the angle same as TYPE_SENSOR_EV3_GYRO_M0. In fact, I tried all the modes and none of it give the rotational speed.
https://github.com/DexterInd/BrickPi/blob/df3da4807db23e21b287aacaf19daf08f25e97b1/Software/BrickPi_Python/Sensor_Examples/EV3-Gyro.py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

The same query is posted in the forum too.
https://forum.dexterindustries.com/t/how-to-read-the-rate-of-rotation-using-ev3-dev-gyro-sensor/6832
