DexterInd/BrickPi/Hardware Design/BrickPi_2_8_1.pdf

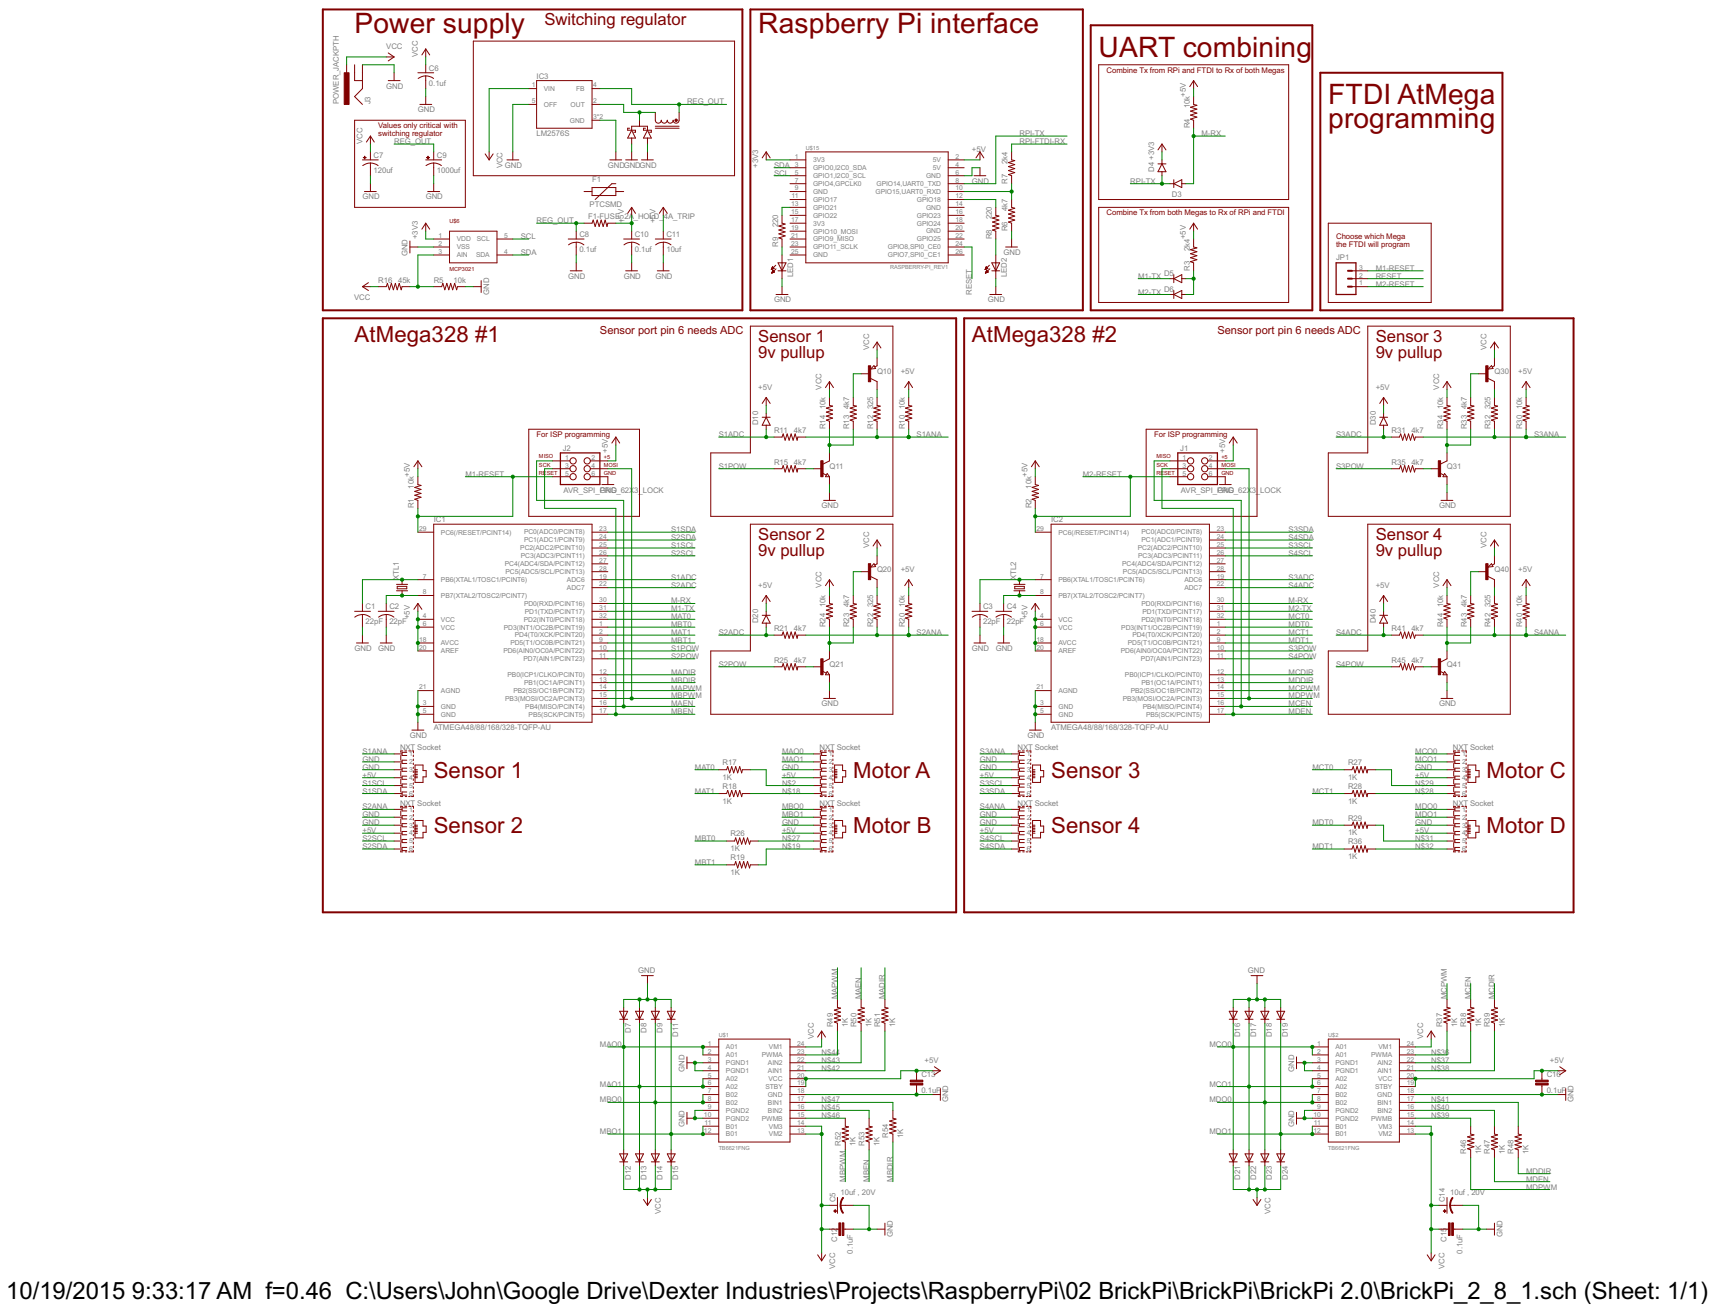
[picture p44: page 1]

switching regulator Power supply
VCC GND

Combine Tx from RPi and FTDI to Rx of both Megas

Values only critical with

Combine Tx from both Megas to Rx of RPi and FTDI

Choose which Mega
the FTDI will program

Sensor port pin 6 needs ADC

10/19/2015 9:33:17 AM f=0.46 C:\Users\John\Google Drive\Dexter Industries\Projects\RaspberryPi\02 BrickPi\BrickPi\BrickPi 2.0\BrickPi_2_8_1.sch (Sheet: 1/1)
