DexterInd/BrickPi/Hardware Design/BrickPi 1.7.3.pdf

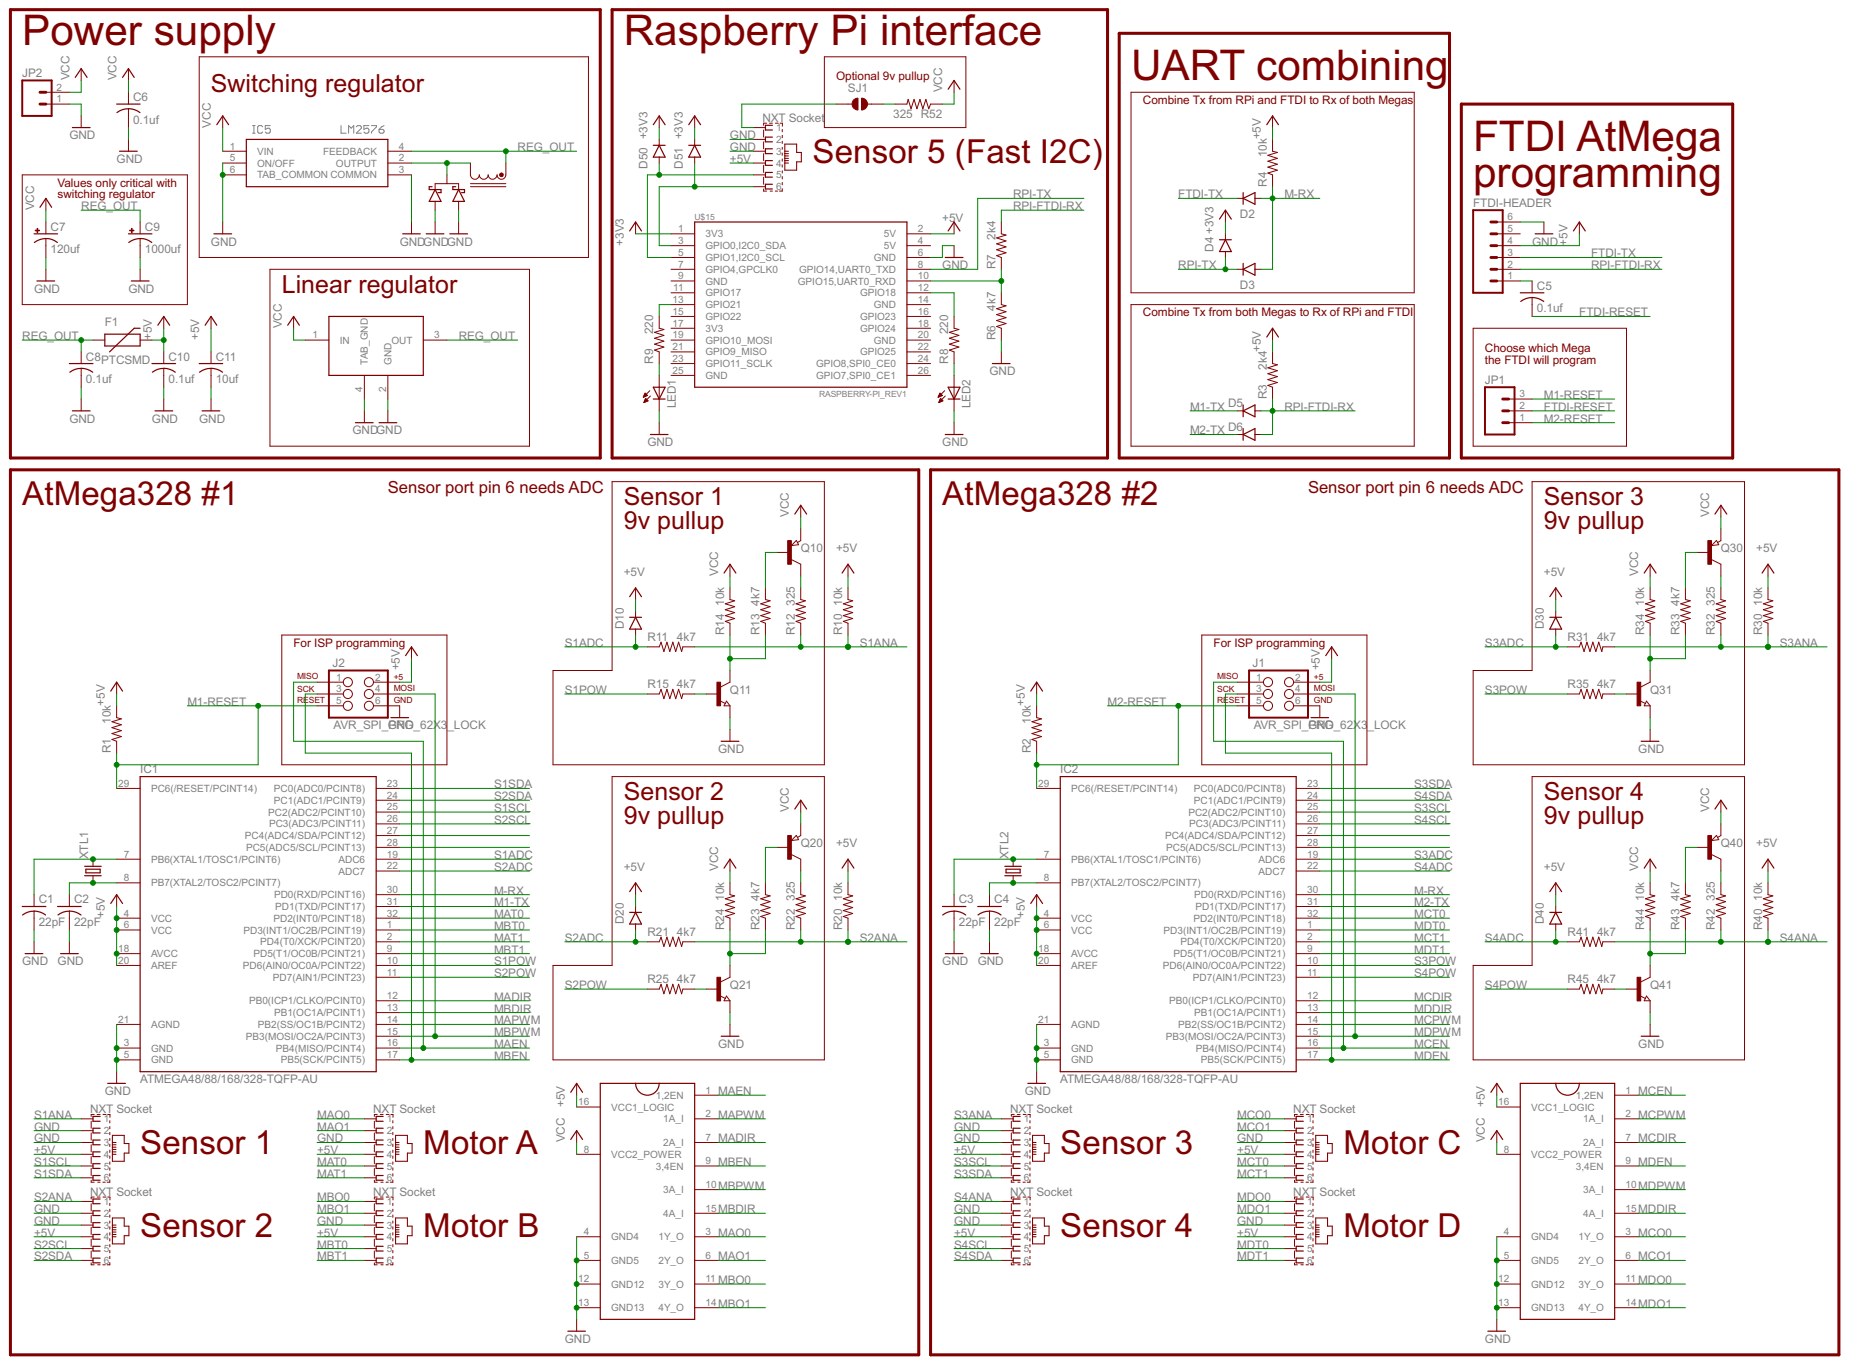
[picture p45: page 1]

switching regulator Power supply

Combine Tx from RPi and FTDI to Rx of both Megas

Values only critical with

Combine Tx from both Megas to Rx of RPi and FTDI Linear regulator

Choose which Mega
the FTDI will program

Sensor port pin 6 needs ADC
