DexterInd/BrickPi/Case Design/Raspberry Pi board enclosure-Ver_2 -  june-09-2014.PDF

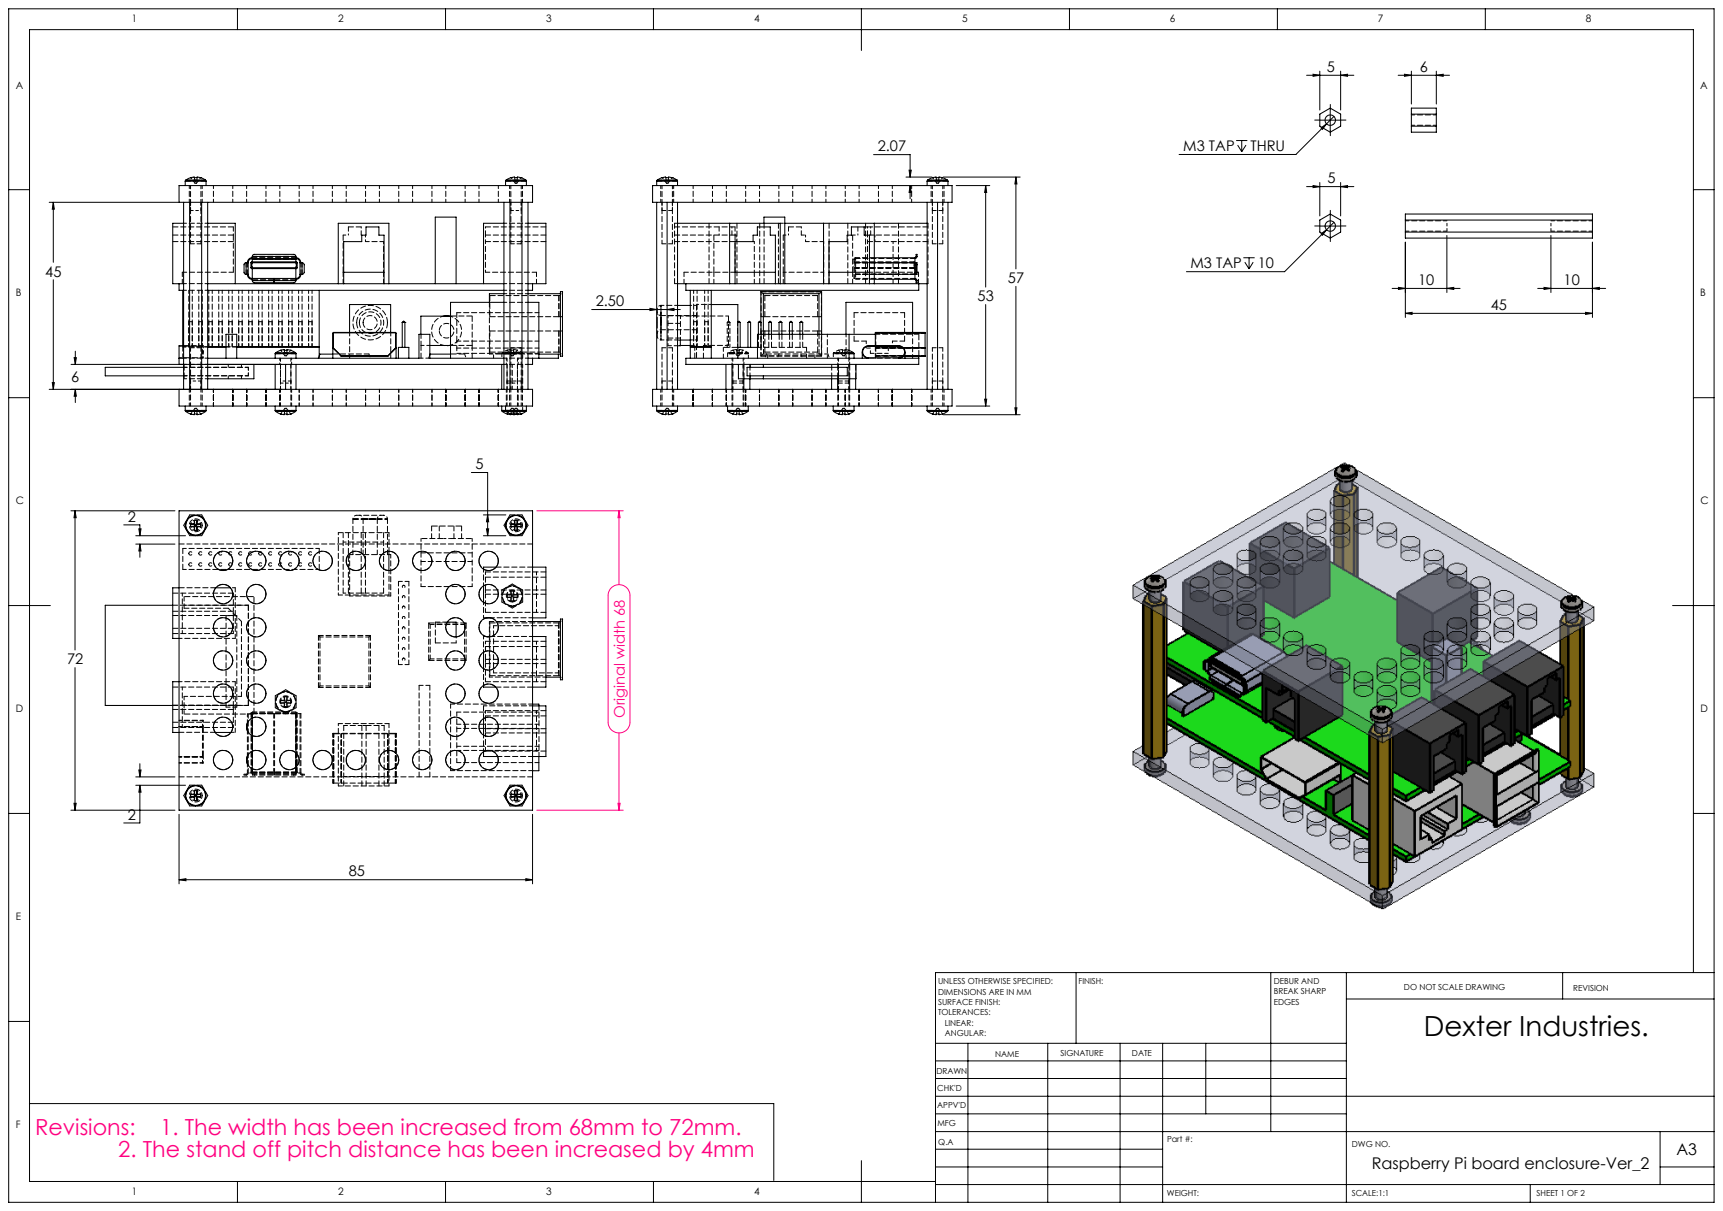
[picture p46: page 1]
Original width 68; M3 TAP THRU; M3 TAP 10; SCALE:1:1; SHEET 1 OF 2; DO NOT SCALE DRAWING; REVISION; DEBUR AND BREAK SHARP; UNLESS OTHERWISE SPECIFIED:; FINISH:; Dexter Industries.

DIMENSIONS ARE IN MM
SURFACE FINISH:
TOLERANCES:
LINEAR:
ANGULAR:

NAME | SIGNATURE | DATE

DRAWN
CHK'D
APPV'D
MFG
Q.A | | | | Part #: | DWG NO. Raspberry Pi board enclosure-Ver_2 | A3

Revisions: 1. The width has been increased from 68mm to 72mm.

2. The stand off pitch distance has been increased by 4mm

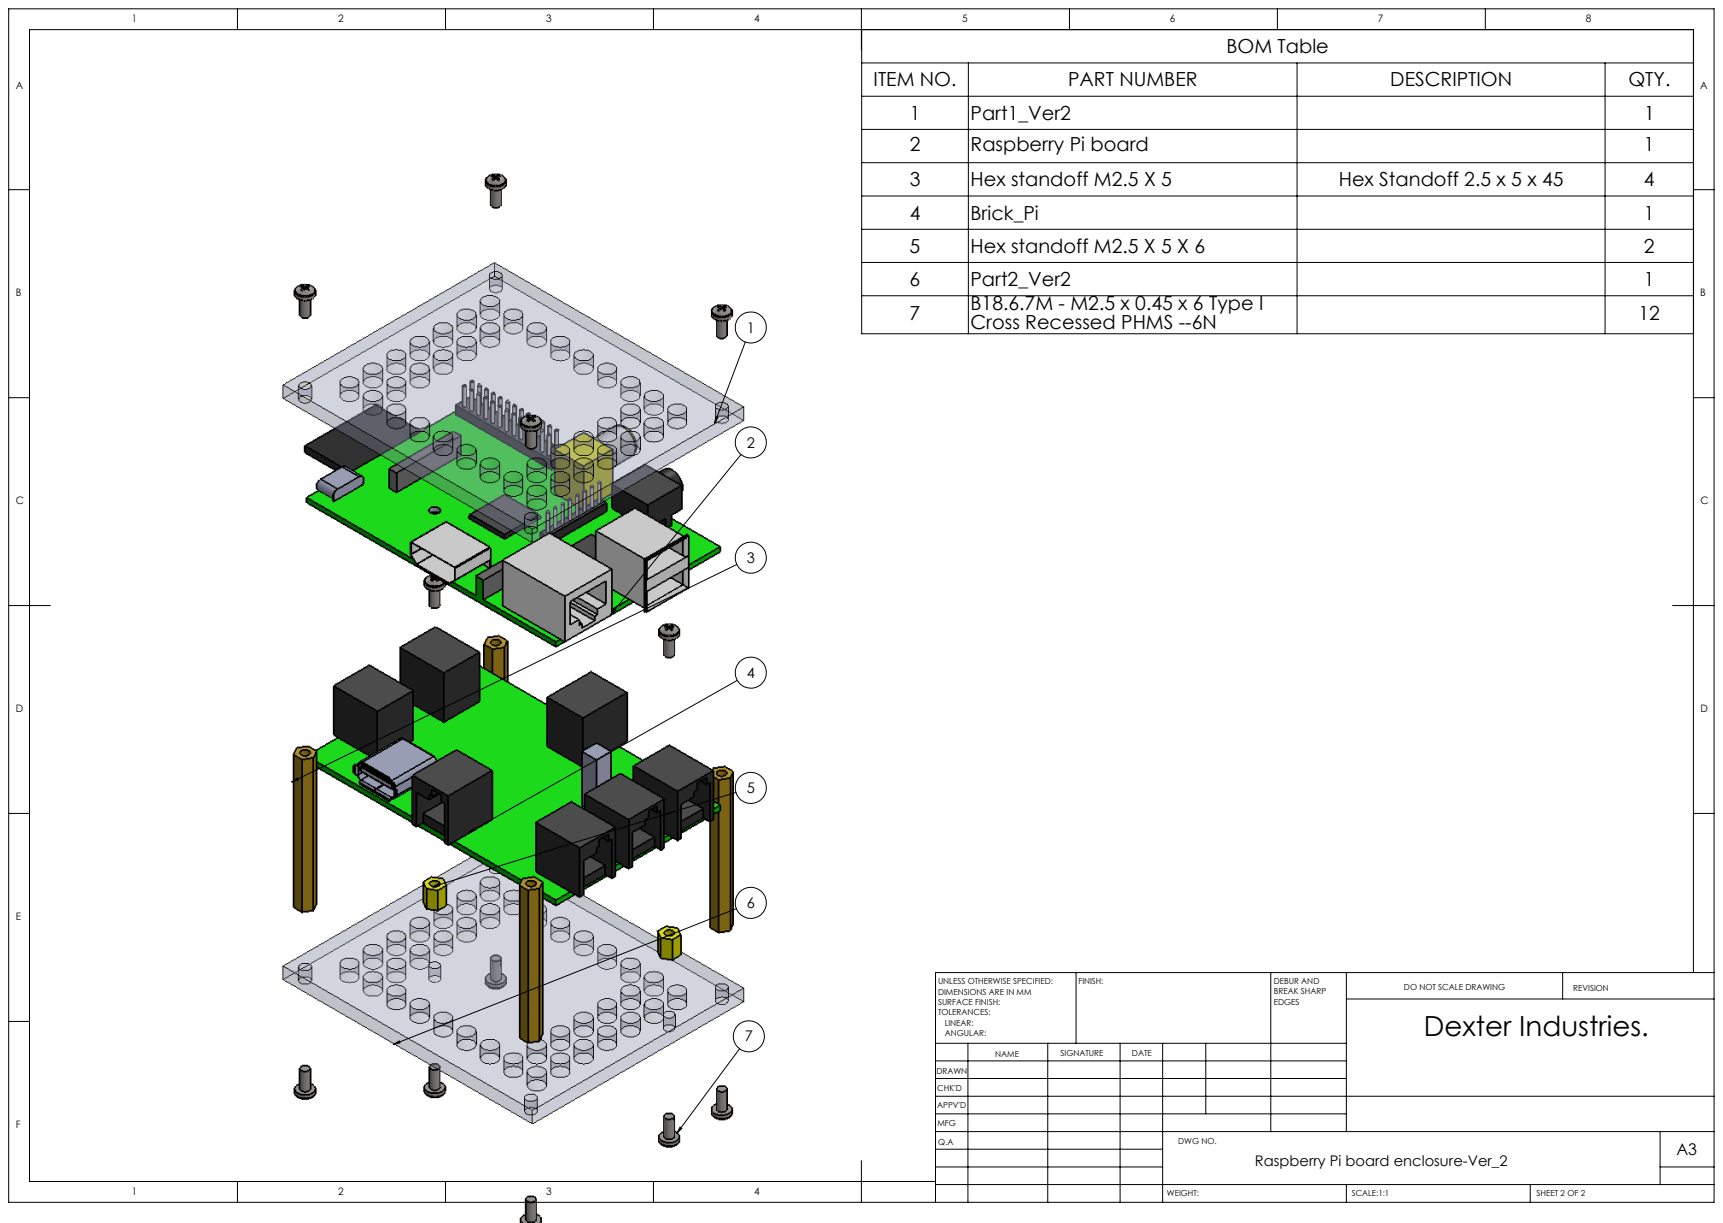
[picture p47: page 2]
SCALE:1:1; SHEET 2 OF 2; DO NOT SCALE DRAWING; REVISION; DEBUR AND BREAK SHARP; UNLESS OTHERWISE SPECIFIED:; FINISH:; Dexter Industries.

BOM Table

ITEM NO. | PART NUMBER | DESCRIPTION | QTY.
1 | Part1_Ver2 | | 1
2 | Raspberry Pi board | | 1
3 | Hex standoff M2.5 X 5 | Hex Standoff 2.5 x 5 x 45 | 4
4 | Brick_Pi | | 1
5 | Hex standoff M2.5 X 5 X 6 | | 2
6 | Part2_Ver2 | | 1
7 | B18.6.7M - M2.5 x 0.45 x 6 Type I Cross Recessed PHMS --6N | | 12

DIMENSIONS ARE IN MM
SURFACE FINISH:
TOLERANCES:
LINEAR:
ANGULAR:

NAME | SIGNATURE | DATE

DRAWN
CHK'D
APPV'D
MFG
Q.A | | | | DWG NO. Raspberry Pi board enclosure-Ver_2 | A3
