DexterInd/BrickPi/Hardware Design/BrickPi 0_7.pdf

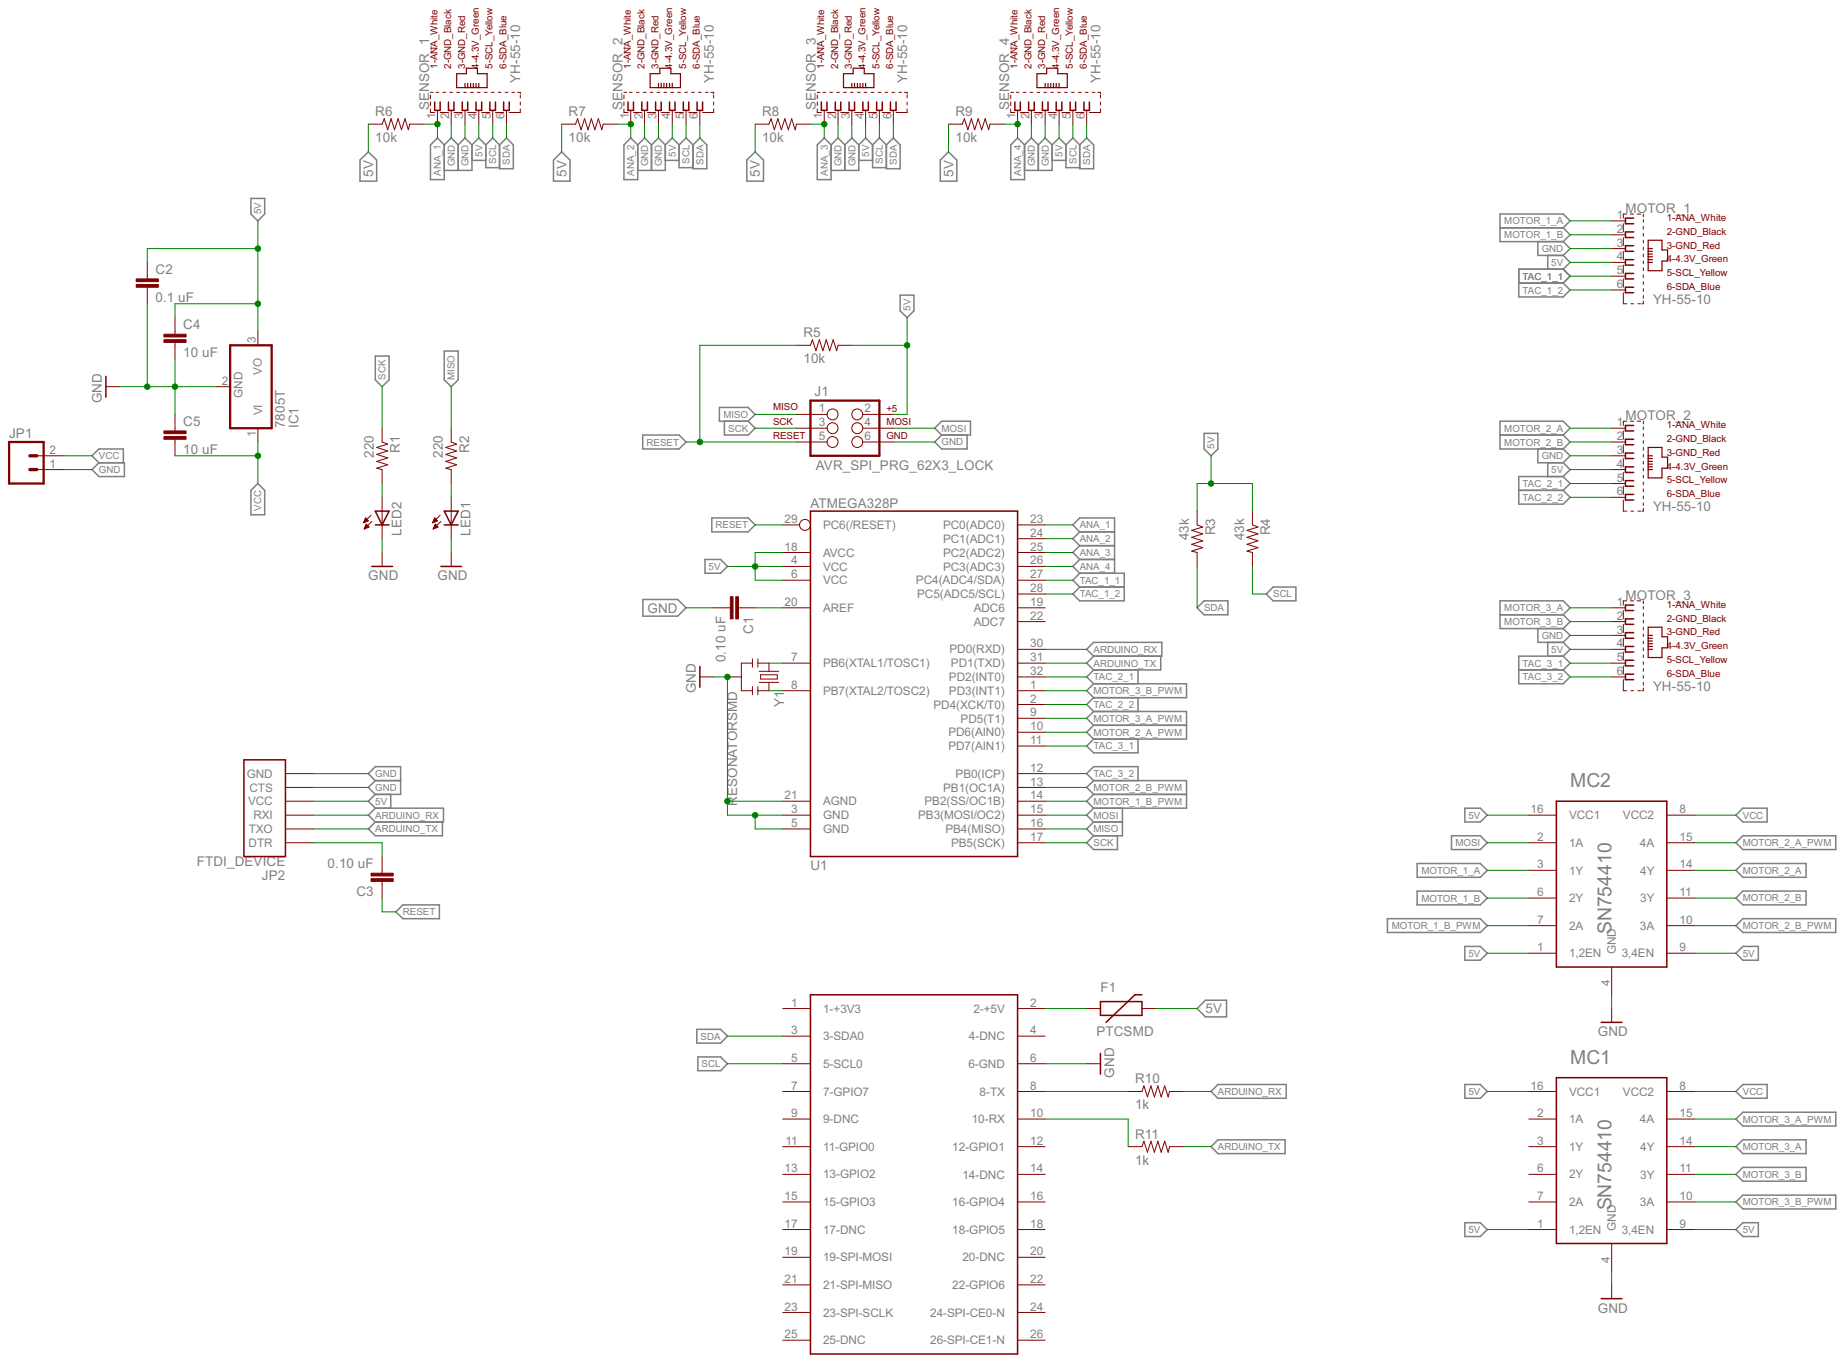
[picture p48: page 1]

YH-55-10 YH-55-10 YH-55-10 YH-55-10 YH-55-10 YH-55-10 YH-55-10 ATMEGA328P AVR_SPI_PRG_62X3_LOCK RESONATORSMDGND GND 10 uF 10 uF 220 220 GND GND GND 43k 43k GND GND 0.10 uF 7805T 0.1 uF 10k PTCSMD 10k 10k 10k 10k 1k1k FTDI_DEVICE 0.10 uF 1-+3V3 1 2-+5V 2 3-SDA0 3 4-DNC 4 5-SCL0 5 6-GND 6 7-GPIO7 7 8-TX 8 9-DNC 9 10-RX 10 11-GPIO0 11 12-GPIO1 12 13-GPIO2 13 14-DNC 14 15-GPIO3 15 16-GPIO4 16 17-DNC 17 18-GPIO5 18 19-SPI-MOSI 19 20-DNC 20 21-SPI-MISO 21 22-GPIO6 22 23-SPI-SCLK 23 24-SPI-CE0-N 24 25-DNC 25 26-SPI-CE1-N 26 SENSOR_1 123456SENSOR_2 123456SENSOR_3 123456SENSOR_4 123456 MOTOR_1 123456MOTOR_2 123456MOTOR_3 123456 U1 PB5(SCK) 17 PB7(XTAL2/TOSC2) 8 PB6(XTAL1/TOSC1) 7 GND 3 GND 5 VCC 4 VCC 6 AGND 21 AREF 20 AVCC 18 PB4(MISO) 16 PB3(MOSI/OC2) 15 PB2(SS/OC1B) 14 PB1(OC1A) 13 PB0(ICP) 12 PD7(AIN1) 11 PD6(AIN0) 10 PD5(T1) 9 PD4(XCK/T0) 2 PD3(INT1) 1 PD2(INT0) 32 PD1(TXD) 31 PD0(RXD) 30 ADC7 22 ADC6 19 PC5(ADC5/SCL) 28 PC4(ADC4/SDA) 27 PC3(ADC3) 26 PC2(ADC2) 25 PC1(ADC1) 24 PC0(ADC0) 23 PC6(/RESET) 29 LED1 LED2 J11 2 3 4 5 6 Y1 JP1 12 C4 C5 MC2SN754410 1Y 3 1A 2 VCC1 16 2Y 6 2A 7 1,2EN 1 VCC2 8 4A 15 4Y 14 3Y 11 3A 10 3,4EN G9 ND 4 MC1SN754410 1Y 3 1A 2 VCC1 16 2Y 6 2A 7 1,2EN 1 VCC2 8 4A 15 4Y 14 3Y 11 3A 10 3,4EN G9 ND 4 R1 R2 R3 R4 C1 IC1 GND VI 1 2 VO 3 C2 R5 F1 R6 R7 R8 R9 R10 R11 DTR TXORXI VCC CTS GNDJP2 C3 GND GND GND GND GND GND GND GND GND GND GND GND GND GND GND GND VCC VCC VCC VCC 5V 5V 5V 5V 5V5V5V 5V5V 5V 5V 5V 5V 5V5V5V5V 5V 5V 5V5V5V5V SDA SDA SDA SDA SDA SDA SCL SCL SCL SCL SCL SCL RESET RESET RESET SCK SCK SCK MISO MISO MISO MOSI MOSI MOSI MOTOR_1_A MOTOR_1_A MOTOR_1_B MOTOR_1_B TAC_1_1 TAC_1_1 TAC_1_2 TAC_1_2 MOTOR_2_A MOTOR_2_A MOTOR_2_B MOTOR_2_B TAC_2_1 TAC_2_1 TAC_2_2 TAC_2_2 MOTOR_3_A MOTOR_3_A MOTOR_3_B MOTOR_3_B TAC_3_1 TAC_3_1 TAC_3_2 TAC_3_2 MOTOR_1_B_PWM MOTOR_1_B_PWM MOTOR_2_B_PWM MOTOR_2_B_PWM MOTOR_3_A_PWM MOTOR_3_A_PWM MOTOR_3_B_PWM MOTOR_3_B_PWM MOTOR_2_A_PWM MOTOR_2_A_PWM ANA_4 ANA_4 ANA_3 ANA_3 ANA_2 ANA_2 ANA_1 ANA_1 ARDUINO_RX ARDUINO_RX ARDUINO_RX ARDUINO_TX ARDUINO_TX ARDUINO_TX1-ANA_White 2-GND_Black 3-GND_Red 4-4.3V_Green 5-SCL_Yellow 6-SDA_Blue 1-ANA_White 2-GND_Black 3-GND_Red 4-4.3V_Green 5-SCL_Yellow 6-SDA_Blue 1-ANA_White 2-GND_Black 3-GND_Red 4-4.3V_Green 5-SCL_Yellow 6-SDA_Blue 1-ANA_White 2-GND_Black 3-GND_Red 4-4.3V_Green 5-SCL_Yellow 6-SDA_Blue 1-ANA_White 2-GND_Black 3-GND_Red 4-4.3V_Green 5-SCL_Yellow 6-SDA_Blue 1-ANA_White 2-GND_Black 3-GND_Red 4-4.3V_Green 5-SCL_Yellow 6-SDA_Blue 1-ANA_White 2-GND_Black 3-GND_Red 4-4.3V_Green 5-SCL_Yellow 6-SDA_Blue MOSI RESET SCK MISO +5GND
