DexterInd/BrickPi/Hardware Design/BrickPi 1.7.3.brd

## EAGLE design Hardware Design/BrickPi 1.7.3.brd (2013-07-05)

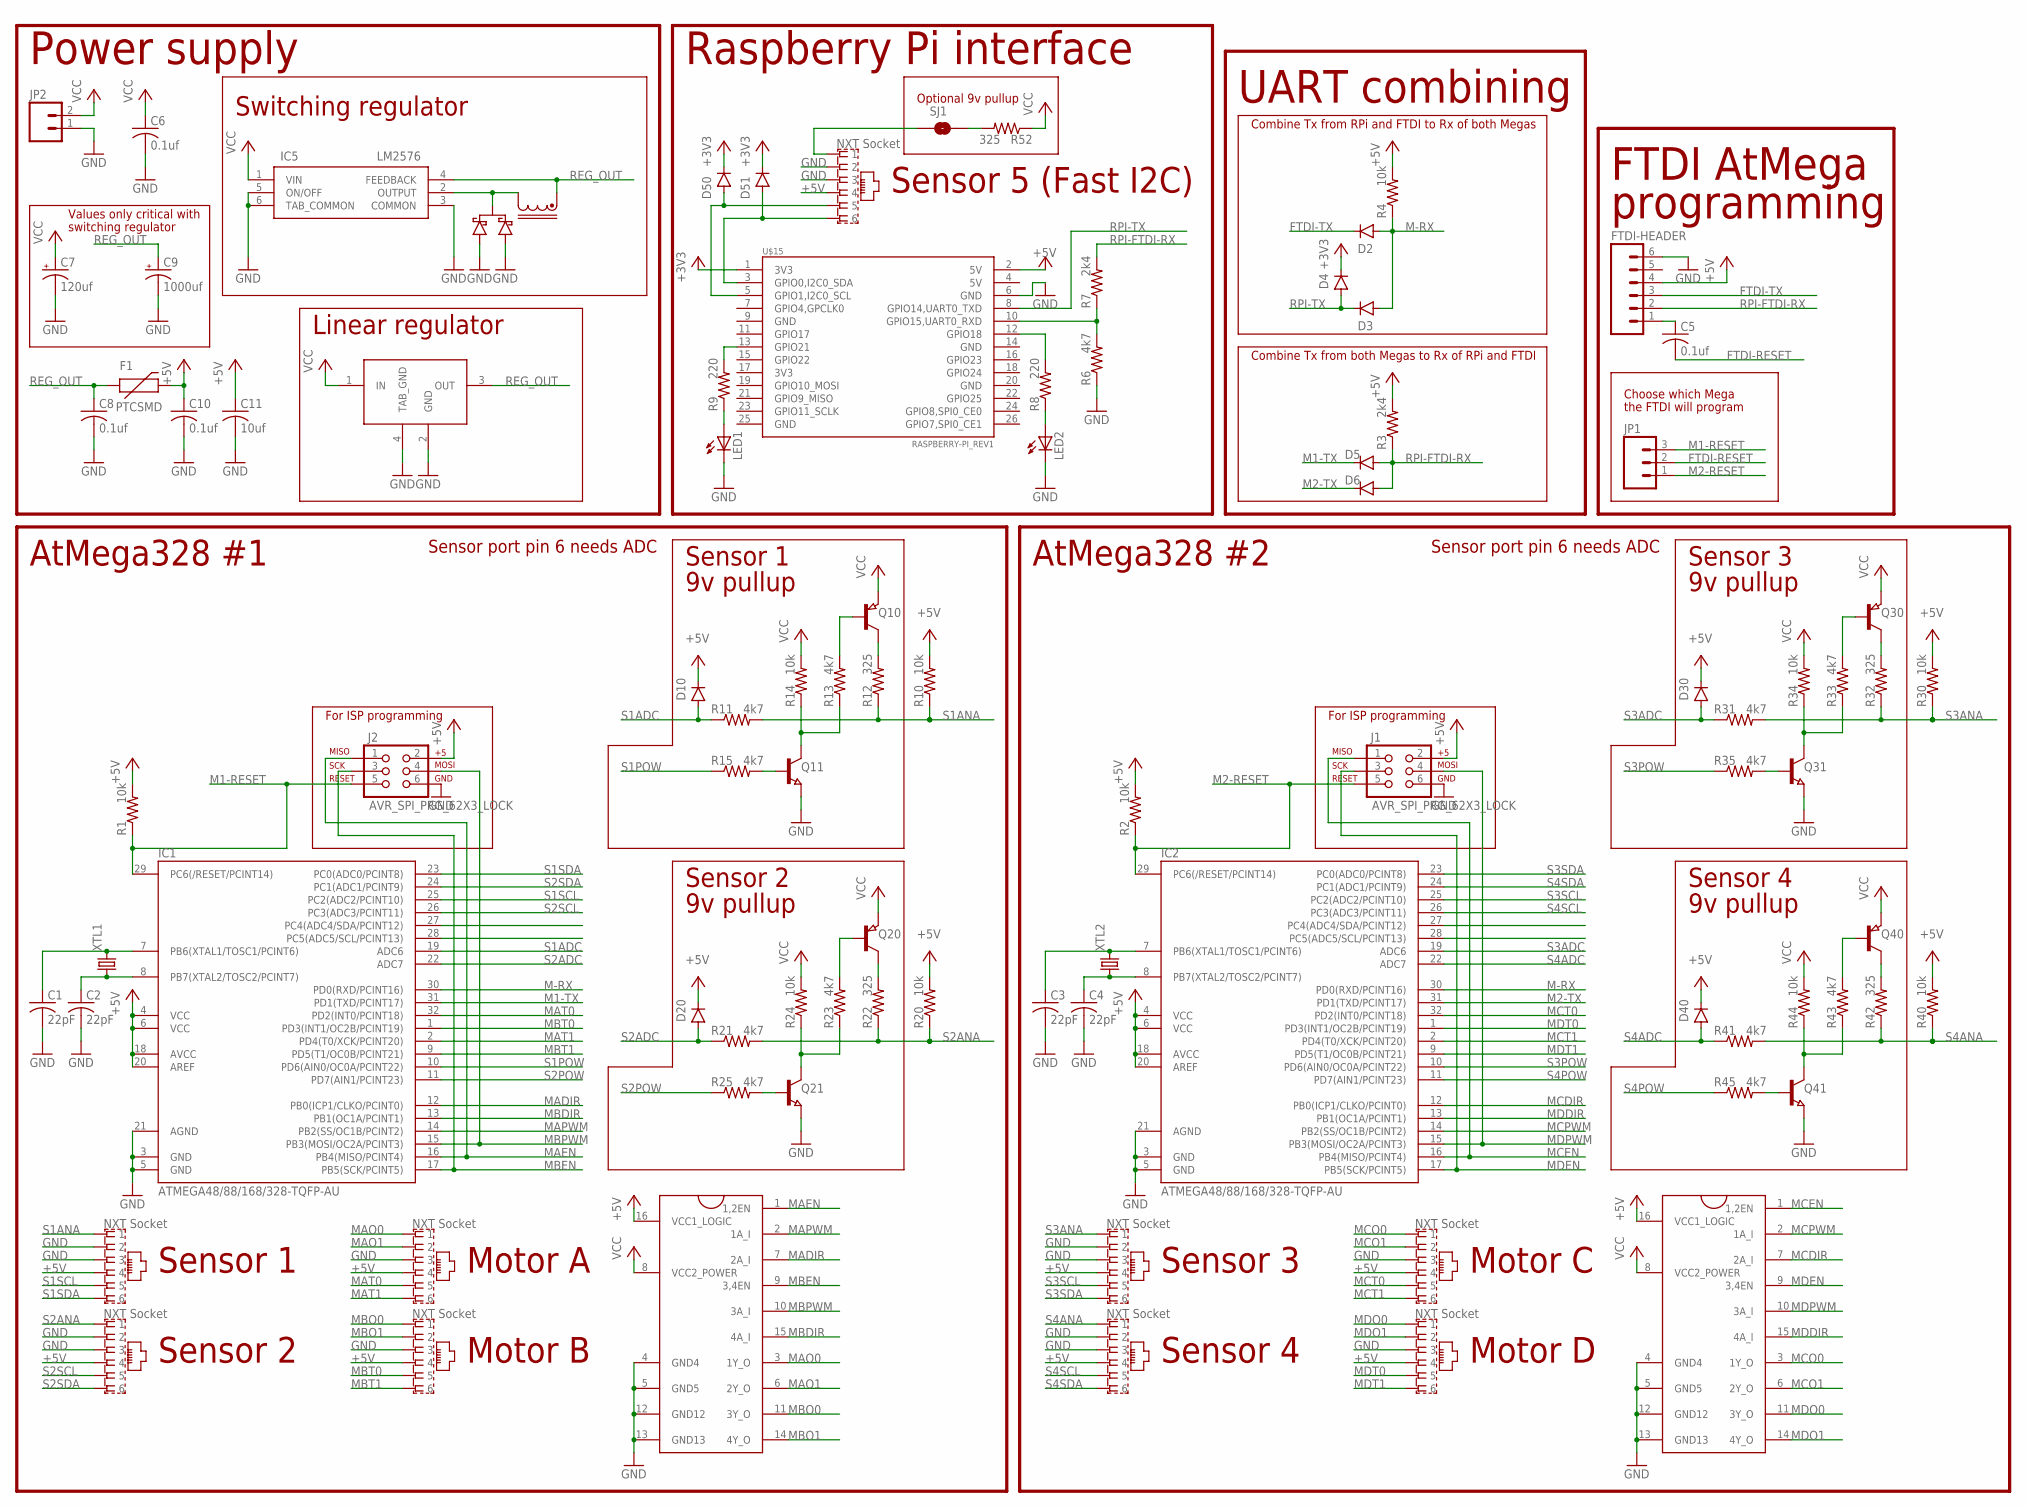
[picture p49: schematic BrickPi 1.7.3.sch]

Parts:
C1, C2, C3, C4: 22pF; C0805
C5, C6, C8, C10: 0.1uf; C0805
C7: 120uf; E2,5-6
C9: 1000uf; E3,5-10
C11: 10uf; C0805
D1: DIODE_SCHOTTKY_VS-6CWQ04FNTRPBF; DPAK
D2, D3, D4, D5, D6, D10, D20, D30, D40, D50, D51: DIODESOD80; SOD80
F1: PTCSMD; PTC-1206
FTDI-HEADER: M06LOCK; 1X06_LOCK
IC1, IC2: ATMEGA48/88/168/328-TQFP-AU; TQFP32-08
IC3, IC4: SN754410; DIL16-ROUND-HEAT_DIS_SN754410
IC5: LM2576; TO220-5-H
IC6: REGULATOR_5V_TO220-H_7805; TO220-H
J1, J2: AVR_SPI_PRG_62X3_LOCK; 2X3_LOCK
JP1: M03LOCK; 1X03_LOCK
JP2: M02LOCK; 1X02_LOCK
LED1, LED2: LED0805; 0805-LED
Q10, Q20, Q30, Q40: PNP-TRANSISTOR_SOT23; SOT23
Q11, Q21, Q31, Q41: NPN-TRANSISTOR_SOT23; SOT23
R1, R2, R4, R10, R14, R20, R24, R30, R34, R40, R44: 10k; 0603
R3, R7: 2k4; 0603
R6, R11, R13, R15, R21, R23, R25, R31, R33, R35, R41, R43, R45: 4k7; 0603
R8, R9: 220; 0603
R12, R22, R32, R42, R52: 325; 1206
SJ1: SOLDERJUMPERNO; SJ_2
U$3, U$4, U$5, U$7, U$8, U$9, U$10, U$11, U$12: NXT-SOCKETREGULAR; NXT-SOCKET
U$14: INDUCTOR_PULSE_P0250.XXXNL
U$15: RASPBERRY-PI_REV1
XTL1, XTL2: CRYSTALHC49S; HC49/S

Connections:
+3V3: D4.C, D50.C, D51.C, U$15.1 (3V3)
+5V: C10.1, C11.1, D10.C, D20.C, D30.C, D40.C, F1.2, FTDI-HEADER.4, IC1.4 (VCC), IC1.6 (VCC), IC1.18 (AVCC), IC1.20 (AREF), IC2.4 (VCC), IC2.6 (VCC), IC2.18 (AVCC), IC2.20 (AREF), IC3.16 (VCC1_LOGIC), IC4.16 (VCC1_LOGIC), J1.2, J2.2, R1.2, R2.2, R3.2, R4.2, R10.2, R20.2, R30.2, R40.2, U$3.4, U$4.4, U$5.4, U$7.4, U$8.4, U$9.4, U$10.4, U$11.4, U$12.4, U$15.2 (5V)
FTDI-RESET: C5.2, JP1.2
FTDI-TX: D2.C, FTDI-HEADER.3
GND: C1.2, C2.2, C3.2, C4.2, C6.2, C7.-, C8.2, C9.-, C10.2, C11.2, D1.1, D1.3, FTDI-HEADER.6, IC1.3 (GND), IC1.5 (GND), IC1.21 (AGND), IC2.3 (GND), IC2.5 (GND), IC2.21 (AGND), IC3.4 (GND4), IC3.5 (GND5), IC3.12 (GND12), IC3.13 (GND13), IC4.4 (GND4), IC4.5 (GND5), IC4.12 (GND12), IC4.13 (GND13), IC5.3 (COMMON), IC5.5 (ON/OFF), IC5.6 (TAB_COMMON), IC6.2 (GND), IC6.4 (TAB_GND), J1.6, J2.6, JP2.1, LED1.2 (C), LED2.2 (C), Q11.2 (E), Q21.2 (E), Q31.2 (E), Q41.2 (E), R6.1, U$3.3, U$4.3, U$5.3, U$7.3, U$8.2, U$8.3, U$9.2, U$9.3, U$10.2, U$10.3, U$11.2, U$11.3, U$12.2, U$12.3, U$15.6 (GND)
M1-RESET: IC1.29 (PC6(/RESET/PCINT14)), J2.5, JP1.3, R1.1
M1-TX: D5.C, IC1.31 (PD1(TXD/PCINT17))
M2-RESET: IC2.29 (PC6(/RESET/PCINT14)), J1.5, JP1.1, R2.1
M2-TX: D6.C, IC2.31 (PD1(TXD/PCINT17))
M-RX: D2.A, D3.A, IC1.30 (PD0(RXD/PCINT16)), IC2.30 (PD0(RXD/PCINT16)), R4.1
MADIR: IC1.12 (PB0(ICP1/CLKO/PCINT0)), IC3.7 (2A_I)
MAEN: IC1.16 (PB4(MISO/PCINT4)), IC3.1 (1,2EN), J2.1
MAO0: IC3.3 (1Y_O), U$3.1
MAO1: IC3.6 (2Y_O), U$3.2
MAPWM: IC1.14 (PB2(SS/OC1B/PCINT2)), IC3.2 (1A_I)
MAT0: IC1.32 (PD2(INT0/PCINT18)), U$3.5
MAT1: IC1.2 (PD4(T0/XCK/PCINT20)), U$3.6
MBDIR: IC1.13 (PB1(OC1A/PCINT1)), IC3.15 (4A_I)
MBEN: IC1.17 (PB5(SCK/PCINT5)), IC3.9 (3,4EN), J2.3
MBO0: IC3.11 (3Y_O), U$4.1
MBO1: IC3.14 (4Y_O), U$4.2
MBPWM: IC1.15 (PB3(MOSI/OC2A/PCINT3)), IC3.10 (3A_I), J2.4
MBT0: IC1.1 (PD3(INT1/OC2B/PCINT19)), U$4.5
MBT1: IC1.9 (PD5(T1/OC0B/PCINT21)), U$4.6
MCDIR: IC2.12 (PB0(ICP1/CLKO/PCINT0)), IC4.7 (2A_I)
MCEN: IC2.16 (PB4(MISO/PCINT4)), IC4.1 (1,2EN), J1.1
MCO0: IC4.3 (1Y_O), U$5.1
MCO1: IC4.6 (2Y_O), U$5.2
MCPWM: IC2.14 (PB2(SS/OC1B/PCINT2)), IC4.2 (1A_I)
MCT0: IC2.32 (PD2(INT0/PCINT18)), U$5.5
MCT1: IC2.2 (PD4(T0/XCK/PCINT20)), U$5.6
MDDIR: IC2.13 (PB1(OC1A/PCINT1)), IC4.15 (4A_I)
MDEN: IC2.17 (PB5(SCK/PCINT5)), IC4.9 (3,4EN), J1.3
MDO0: IC4.11 (3Y_O), U$7.1
MDO1: IC4.14 (4Y_O), U$7.2
MDPWM: IC2.15 (PB3(MOSI/OC2A/PCINT3)), IC4.10 (3A_I), J1.4
MDT0: IC2.1 (PD3(INT1/OC2B/PCINT19)), U$7.5
MDT1: IC2.9 (PD5(T1/OC0B/PCINT21)), U$7.6
unnamed: D1.4, IC5.2 (OUTPUT), U$14.P$2
unnamed: C5.1, FTDI-HEADER.1
unnamed: LED2.1 (A), R8.1
unnamed: LED1.1 (A), R9.1
unnamed: C1.1, IC1.7 (PB6(XTAL1/TOSC1/PCINT6)), XTL1.2
unnamed: R9.2, U$15.13 (GPIO21)
unnamed: C2.1, IC1.8 (PB7(XTAL2/TOSC2/PCINT7)), XTL1.1
unnamed: Q11.1 (B), R15.2
unnamed: Q20.3 (C), R22.2
unnamed: Q21.1 (B), R25.2
unnamed: R6.2, R7.1, U$15.10 (GPIO15,UART0_RXD)
unnamed: R8.2, U$15.12 (GPIO18)
unnamed: Q11.3 (C), R13.1, R14.1
unnamed: C3.1, IC2.7 (PB6(XTAL1/TOSC1/PCINT6)), XTL2.2
unnamed: C4.1, IC2.8 (PB7(XTAL2/TOSC2/PCINT7)), XTL2.1
unnamed: Q21.3 (C), R23.1, R24.1
unnamed: Q20.1 (B), R23.2
unnamed: Q30.3 (C), R32.2
unnamed: Q31.1 (B), R35.2
unnamed: Q10.1 (B), R13.2
unnamed: Q31.3 (C), R33.1, R34.1
unnamed: Q30.1 (B), R33.2
unnamed: Q10.3 (C), R12.2
unnamed: Q40.3 (C), R42.2
unnamed: SJ1.1, U$12.1
unnamed: R52.2, SJ1.2
unnamed: D51.A, U$12.6, U$15.3 (GPIO0,I2C0_SDA)
unnamed: D50.A, U$12.5, U$15.5 (GPIO1,I2C0_SCL)
unnamed: Q41.1 (B), R45.2
unnamed: Q41.3 (C), R43.1, R44.1
unnamed: Q40.1 (B), R43.2
REG_OUT: C8.1, C9.+, F1.1, IC5.4 (FEEDBACK), IC6.3 (OUT), U$14.P$1
RPI-FTDI-RX: D5.A, D6.A, FTDI-HEADER.2, R3.1, R7.2
RPI-TX: D3.C, D4.A, U$15.8 (GPIO14,UART0_TXD)
S1ADC: D10.A, IC1.19 (ADC6), R11.1
S1ANA: R10.1, R11.2, R12.1, U$8.1
S1POW: IC1.10 (PD6(AIN0/OC0A/PCINT22)), R15.1
S1SCL: IC1.25 (PC2(ADC2/PCINT10)), U$8.5
S1SDA: IC1.23 (PC0(ADC0/PCINT8)), U$8.6
S2ADC: D20.A, IC1.22 (ADC7), R21.1
S2ANA: R20.1, R21.2, R22.1, U$9.1
S2POW: IC1.11 (PD7(AIN1/PCINT23)), R25.1
S2SCL: IC1.26 (PC3(ADC3/PCINT11)), U$9.5
S2SDA: IC1.24 (PC1(ADC1/PCINT9)), U$9.6
S3ADC: D30.A, IC2.19 (ADC6), R31.1
S3ANA: R30.1, R31.2, R32.1, U$10.1
S3POW: IC2.10 (PD6(AIN0/OC0A/PCINT22)), R35.1
S3SCL: IC2.25 (PC2(ADC2/PCINT10)), U$10.5
S3SDA: IC2.23 (PC0(ADC0/PCINT8)), U$10.6
S4ADC: D40.A, IC2.22 (ADC7), R41.1
S4ANA: R40.1, R41.2, R42.1, U$11.1
S4POW: IC2.11 (PD7(AIN1/PCINT23)), R45.1
S4SCL: IC2.26 (PC3(ADC3/PCINT11)), U$11.5
S4SDA: IC2.24 (PC1(ADC1/PCINT9)), U$11.6
VCC: C6.1, C7.+, IC3.8 (VCC2_POWER), IC4.8 (VCC2_POWER), IC5.1 (VIN), IC6.1 (IN), JP2.2, Q10.2 (E), Q20.2 (E), Q30.2 (E), Q40.2 (E), R14.2, R24.2, R34.2, R44.2, R52.1

Notes on the sheet:
Sensor 1
Motor A
Motor B
Sensor 5 (Fast I2C)
Sensor port pin 6 needs ADC
Sensor 2
Sensor 3
Motor C
Motor D
Sensor 4
Choose which Mega
the FTDI will program
Combine Tx from RPi and FTDI to Rx of both Megas
Combine Tx from both Megas to Rx of RPi and FTDI
Linear regulator
Switching regulator
Values only critical with
switching regulator
Power supply
FTDI AtMega
UART combining
9v pullup
AtMega328 #1
For ISP programming
AtMega328 #2
Raspberry Pi interface
programming
Optional 9v pullup

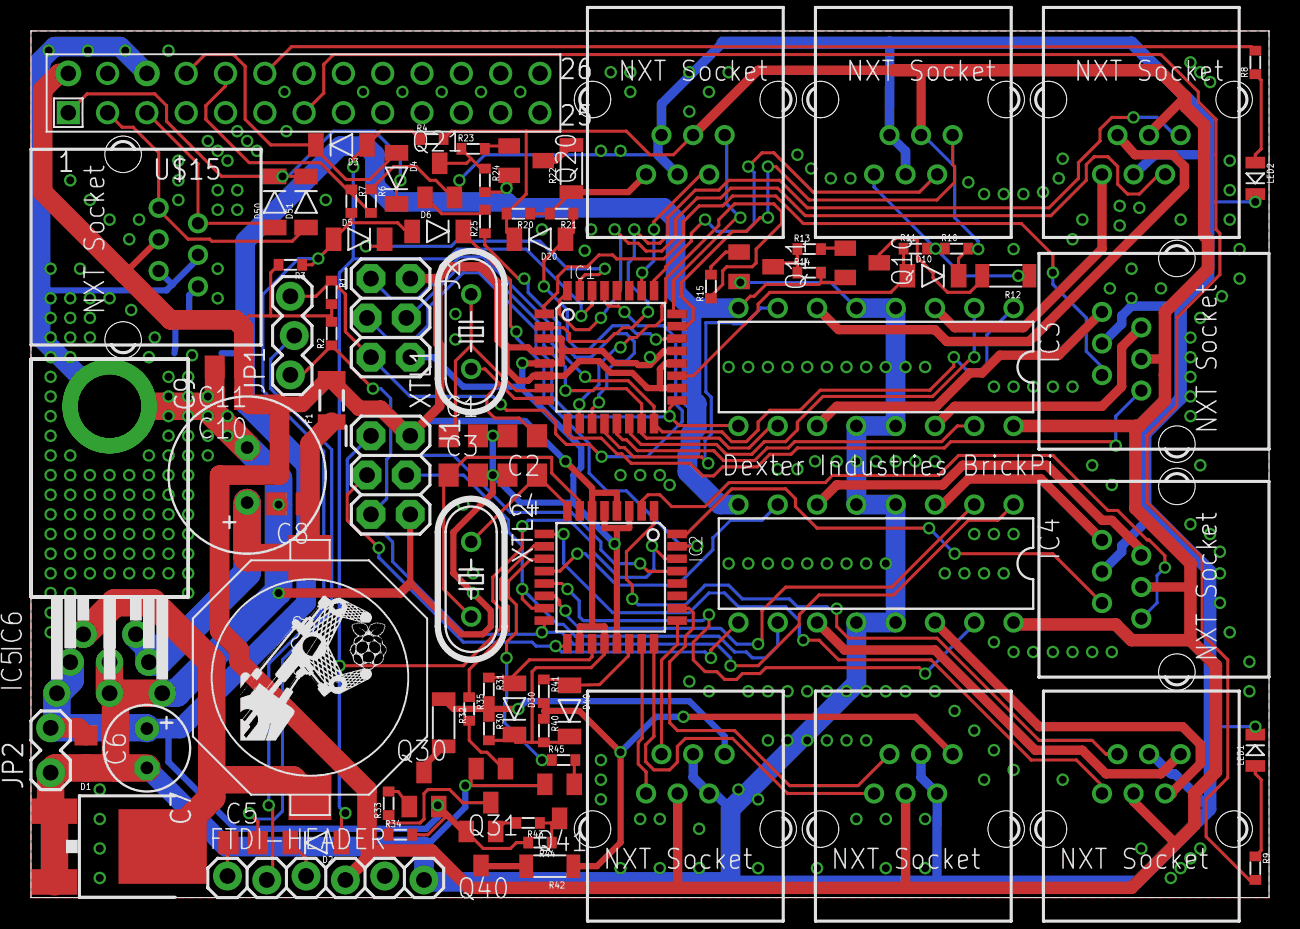
[picture p50: board BrickPi 1.7.3.brd from above]

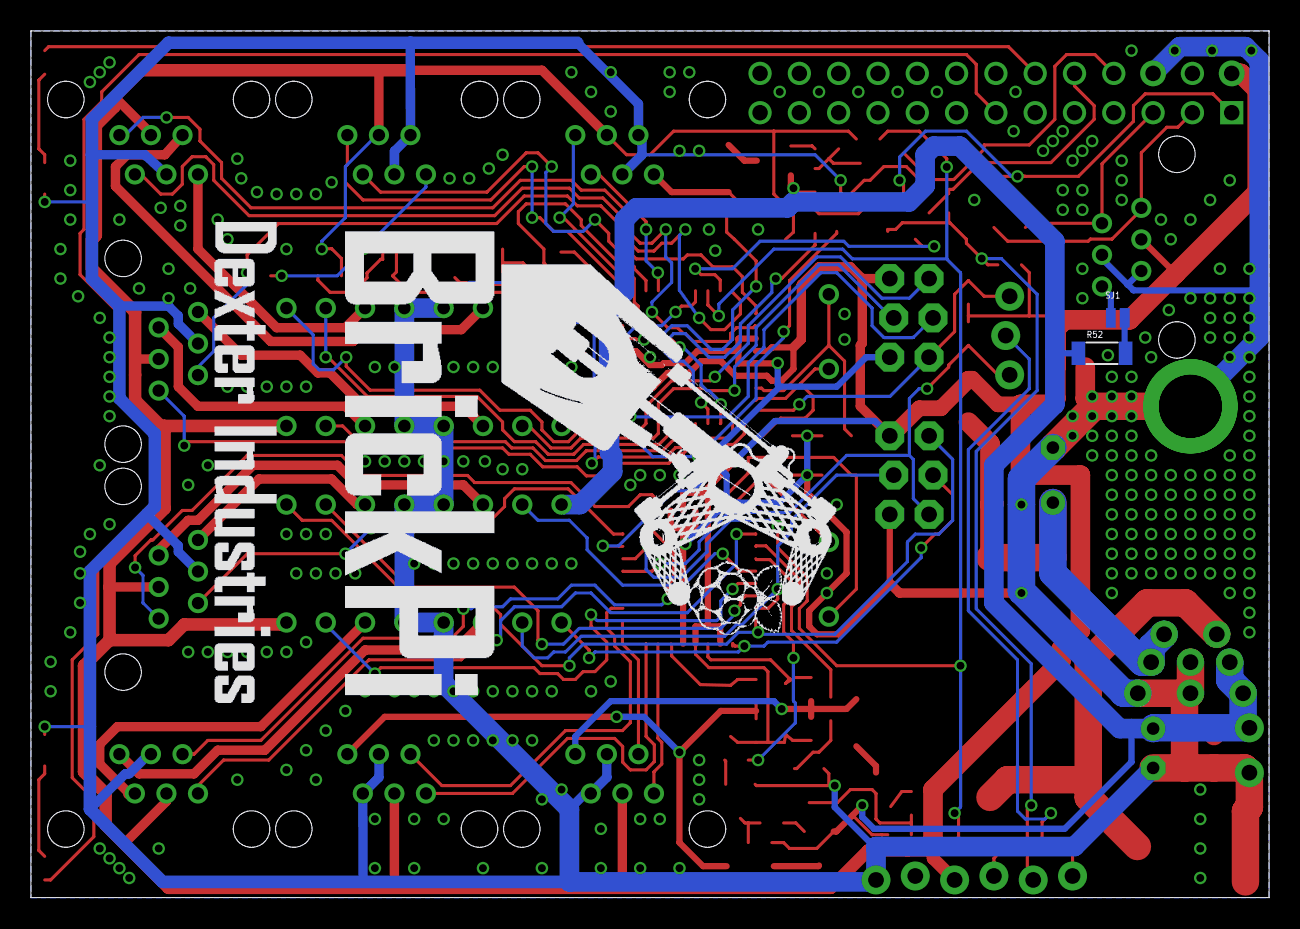
[picture p51: board BrickPi 1.7.3.brd from below]

Board: 2 copper layers, 80.0 x 56.0 mm, 92 parts (2 on the bottom side), 93 nets.
