DexterInd/BrickPi/Hardware Design/BrickPi 0_7.brd

## EAGLE design Hardware Design/BrickPi 0_7.brd (2013-05-13)

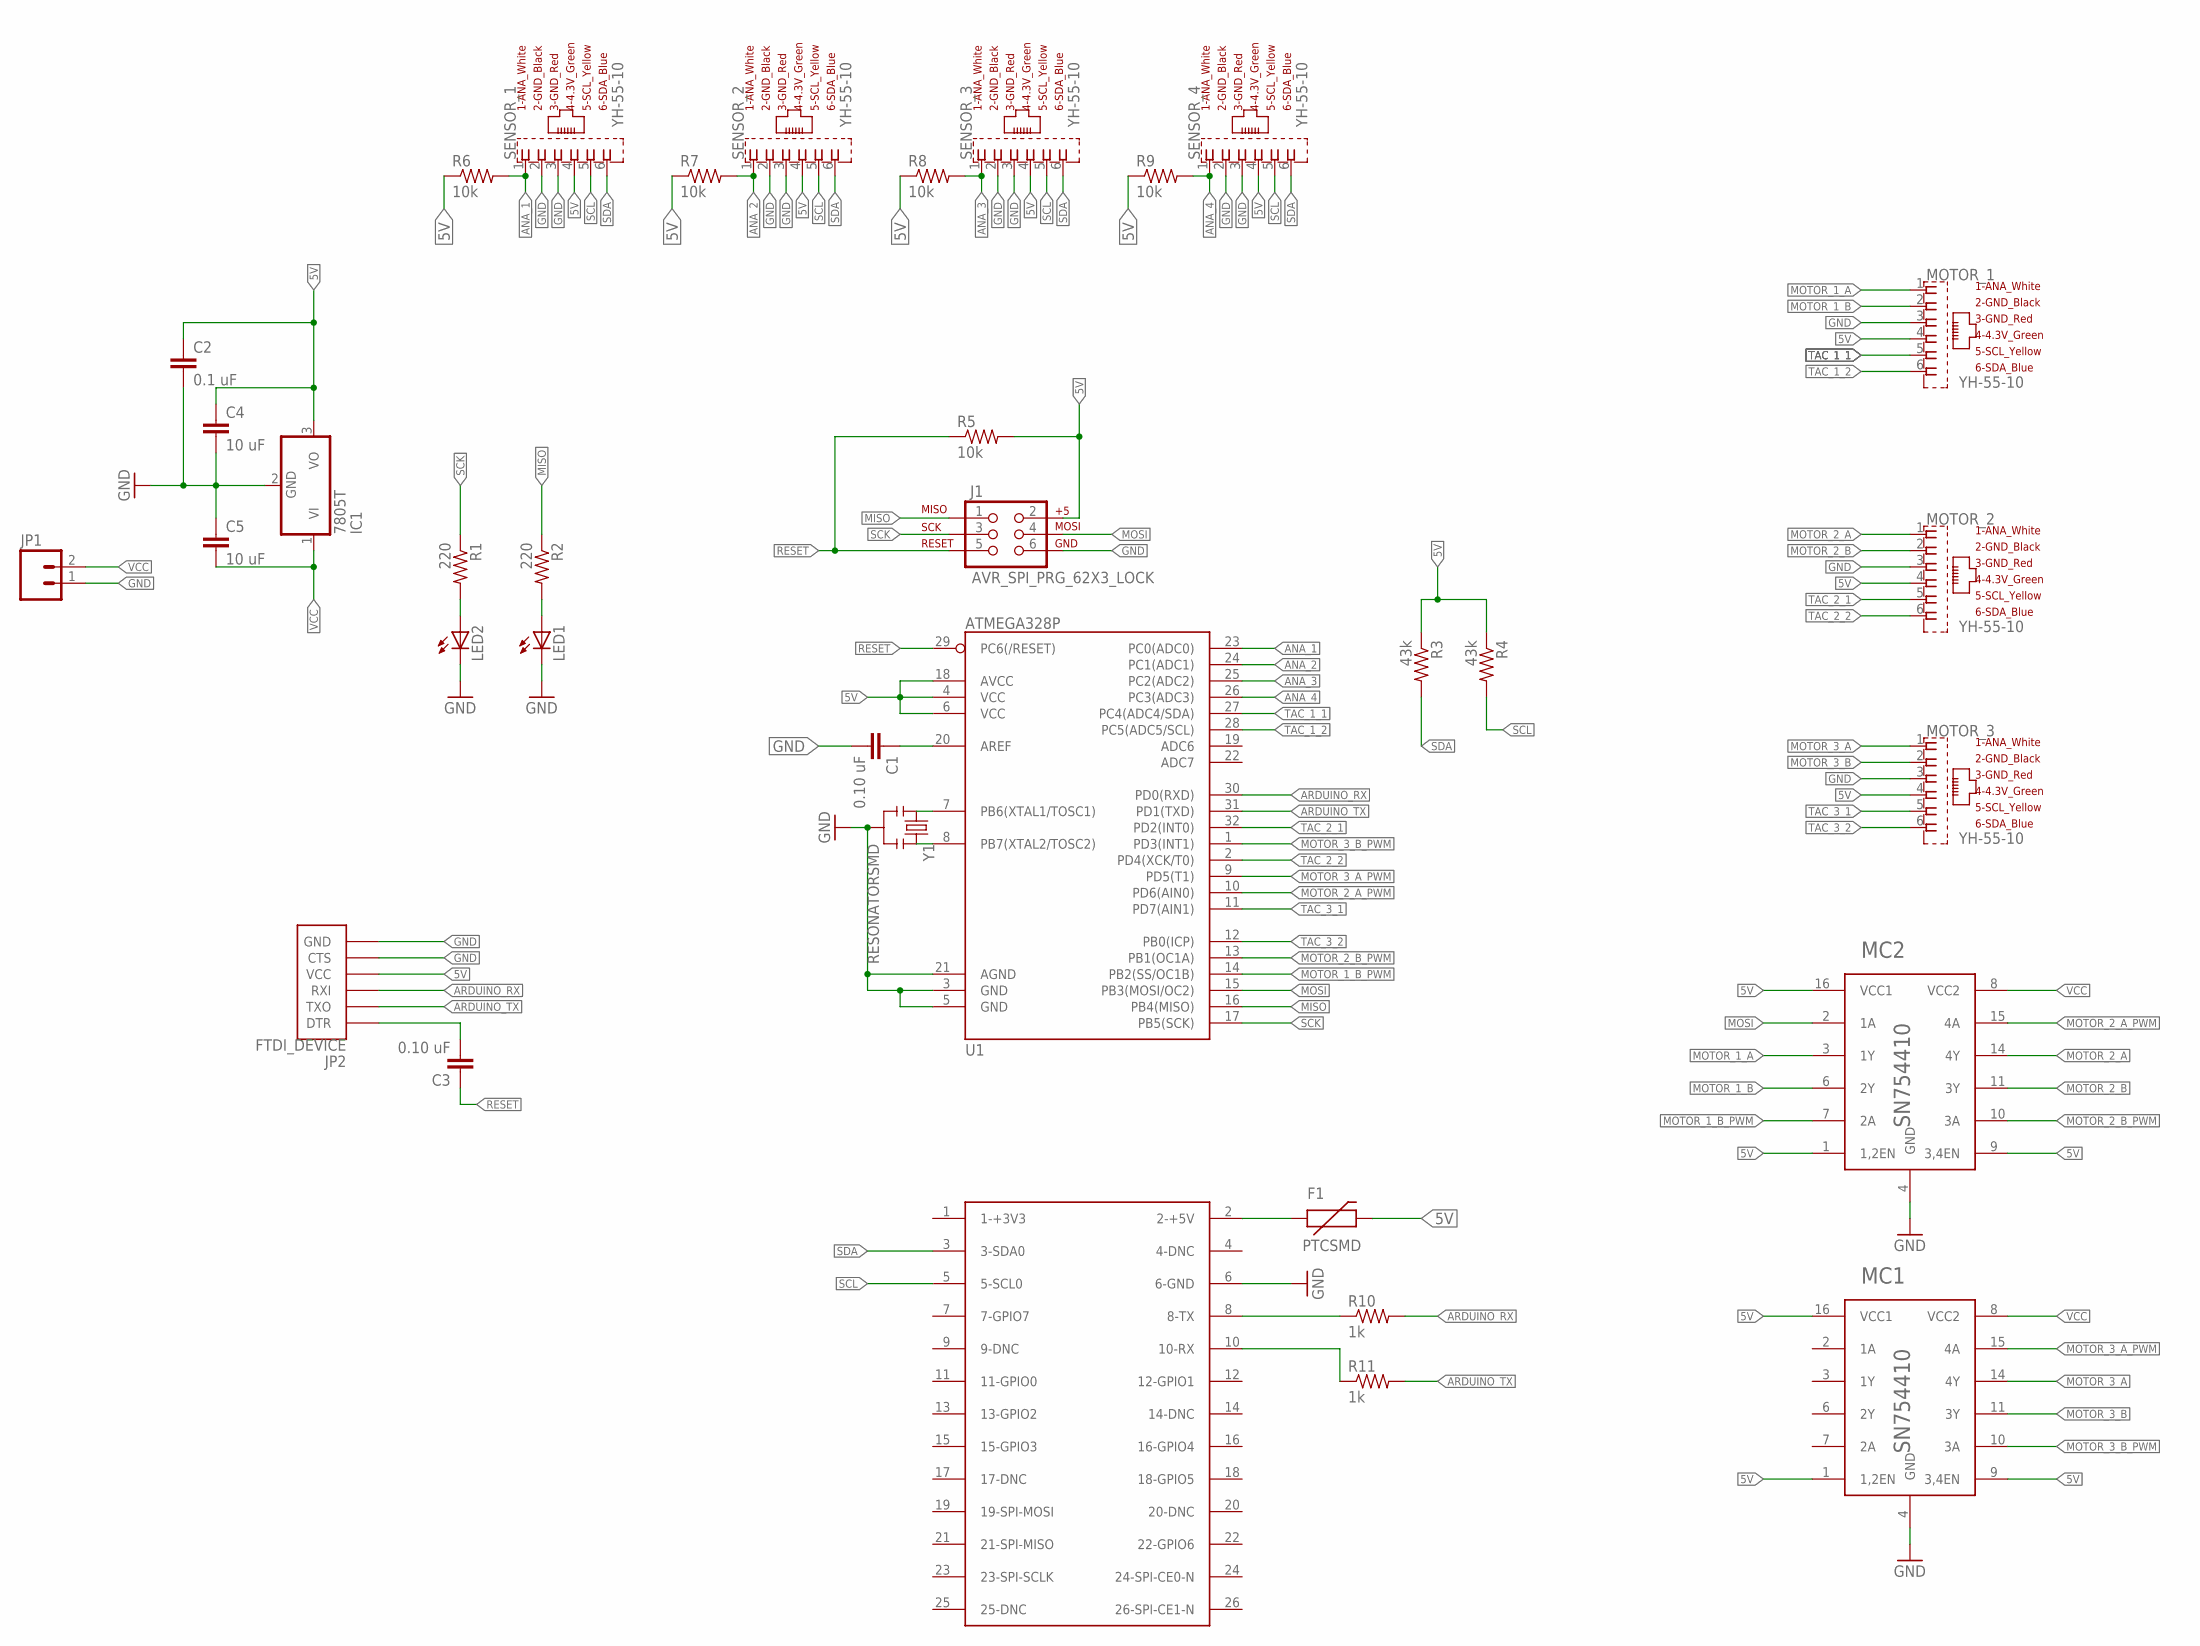
[picture p52: schematic BrickPi 0_7.sch]

Parts:
C1, C3: 0.10 uF; 0805
C2: 0.1 uF; 0805
C4, C5: 10 uF; 0805
F1: PTCSMD; PTC-1206
IC1: 7805T; TO220H
J1: AVR_SPI_PRG_62X3_LOCK; 2X3_LOCK
JP1: M02LOCK; 1X02_LOCK
JP2: FTDI_DEVICE; FTDI_DEVICE_SIDE
LED1, LED2: LED1206; LED-1206
MC1, MC2: SN754410; DIL16
MOTOR_1, MOTOR_2, MOTOR_3: YH-55-10
PI_OUTLINE: RASPBERRY-PI
R1, R2: 220; 0603-RES
R3, R4: 43k; 0603-RES
R5, R6, R7, R8, R9: 10k; 0603-RES
R10, R11: 1k; 0603-RES
SENSOR_1, SENSOR_2, SENSOR_3, SENSOR_4: YH-55-10
U1: ATMEGA328P; TQFP32-08
Y1: RESONATORSMD; RESONATOR-SMD

Connections:
5V: C2.1, C4.1, F1.2, IC1.3 (VO), J1.2, JP2.P$4 (VCC), MC1.1 (1,2EN), MC1.9 (3,4EN), MC1.16 (VCC1), MC2.1 (1,2EN), MC2.9 (3,4EN), MC2.16 (VCC1), MOTOR_1.4 (4_4.3V_GREEN), MOTOR_2.4 (4_4.3V_GREEN), MOTOR_3.4 (4_4.3V_GREEN), R3.1, R4.1, R5.2, R6.1, R7.1, R8.1, R9.1, SENSOR_1.4 (4_4.3V_GREEN), SENSOR_2.4 (4_4.3V_GREEN), SENSOR_3.4 (4_4.3V_GREEN), SENSOR_4.4 (4_4.3V_GREEN), U1.4 (VCC), U1.6 (VCC), U1.18 (AVCC)
ANA_1: R6.2, SENSOR_1.1 (1_ANA_WHITE), U1.23 (PC0(ADC0))
ANA_2: R7.2, SENSOR_2.1 (1_ANA_WHITE), U1.24 (PC1(ADC1))
ANA_3: R8.2, SENSOR_3.1 (1_ANA_WHITE), U1.25 (PC2(ADC2))
ANA_4: R9.2, SENSOR_4.1 (1_ANA_WHITE), U1.26 (PC3(ADC3))
ARDUINO_RX: JP2.P$3 (RXI), R10.2, U1.30 (PD0(RXD))
ARDUINO_TX: JP2.P$2 (TXO), R11.2, U1.31 (PD1(TXD))
GND: C1.2, C2.2, C4.2, C5.1, IC1.2 (GND), J1.6, JP1.1, JP2.P$5 (CTS), JP2.P$6 (GND), LED1.C, LED2.C, MC1.4 (GND), MC1.5 (GND), MC1.12 (GND), MC1.13 (GND), MC2.4 (GND), MC2.5 (GND), MC2.12 (GND), MC2.13 (GND), MOTOR_1.3 (3_GND_RED), MOTOR_2.3 (3_GND_RED), MOTOR_3.3 (3_GND_RED), PI_OUTLINE.6 (6-GND), SENSOR_1.2 (2_GND_BLACK), SENSOR_1.3 (3_GND_RED), SENSOR_2.2 (2_GND_BLACK), SENSOR_2.3 (3_GND_RED), SENSOR_3.2 (2_GND_BLACK), SENSOR_3.3 (3_GND_RED), SENSOR_4.2 (2_GND_BLACK), SENSOR_4.3 (3_GND_RED), U1.3 (GND), U1.5 (GND), U1.21 (AGND), Y1.2
MISO: J1.1, R2.1, U1.16 (PB4(MISO))
MOSI: J1.4, MC2.2 (1A), U1.15 (PB3(MOSI/OC2))
MOTOR_1_A: MC2.3 (1Y), MOTOR_1.1 (1_ANA_WHITE)
MOTOR_1_B: MC2.6 (2Y), MOTOR_1.2 (2_GND_BLACK)
MOTOR_1_B_PWM: MC2.7 (2A), U1.14 (PB2(SS/OC1B))
MOTOR_2_A: MC2.14 (4Y), MOTOR_2.1 (1_ANA_WHITE)
MOTOR_2_A_PWM: MC2.15 (4A), U1.10 (PD6(AIN0))
MOTOR_2_B: MC2.11 (3Y), MOTOR_2.2 (2_GND_BLACK)
MOTOR_2_B_PWM: MC2.10 (3A), U1.13 (PB1(OC1A))
MOTOR_3_A: MC1.14 (4Y), MOTOR_3.1 (1_ANA_WHITE)
MOTOR_3_A_PWM: MC1.15 (4A), U1.9 (PD5(T1))
MOTOR_3_B: MC1.11 (3Y), MOTOR_3.2 (2_GND_BLACK)
MOTOR_3_B_PWM: MC1.10 (3A), U1.1 (PD3(INT1))
unnamed: U1.7 (PB6(XTAL1/TOSC1)), Y1.1
unnamed: U1.8 (PB7(XTAL2/TOSC2)), Y1.3
unnamed: LED2.A, R1.2
unnamed: LED1.A, R2.2
unnamed: C1.1, U1.20 (AREF)
unnamed: C3.2, JP2.P$1 (DTR)
PI_POWER: F1.1, PI_OUTLINE.2 (2-+5V)
RESET: C3.1, J1.5, R5.1, U1.29 (PC6(/RESET))
RX_TO_PI: PI_OUTLINE.8 (8-TX), R10.1
SCK: J1.3, R1.1, U1.17 (PB5(SCK))
SCL: PI_OUTLINE.5 (5-SCL0), R4.2, SENSOR_1.5 (5_SCL_YELLOW), SENSOR_2.5 (5_SCL_YELLOW), SENSOR_3.5 (5_SCL_YELLOW), SENSOR_4.5 (5_SCL_YELLOW)
SDA: PI_OUTLINE.3 (3-SDA0), R3.2, SENSOR_1.6 (6_SDA_BLUE), SENSOR_2.6 (6_SDA_BLUE), SENSOR_3.6 (6_SDA_BLUE), SENSOR_4.6 (6_SDA_BLUE)
TAC_1_1: MOTOR_1.5 (5_SCL_YELLOW), U1.27 (PC4(ADC4/SDA))
TAC_1_2: MOTOR_1.6 (6_SDA_BLUE), U1.28 (PC5(ADC5/SCL))
TAC_2_1: MOTOR_2.5 (5_SCL_YELLOW), U1.32 (PD2(INT0))
TAC_2_2: MOTOR_2.6 (6_SDA_BLUE), U1.2 (PD4(XCK/T0))
TAC_3_1: MOTOR_3.5 (5_SCL_YELLOW), U1.11 (PD7(AIN1))
TAC_3_2: MOTOR_3.6 (6_SDA_BLUE), U1.12 (PB0(ICP))
TX_TO_PI: PI_OUTLINE.10 (10-RX), R11.1
VCC: C5.2, IC1.1 (VI), JP1.2, MC1.8 (VCC2), MC2.8 (VCC2)

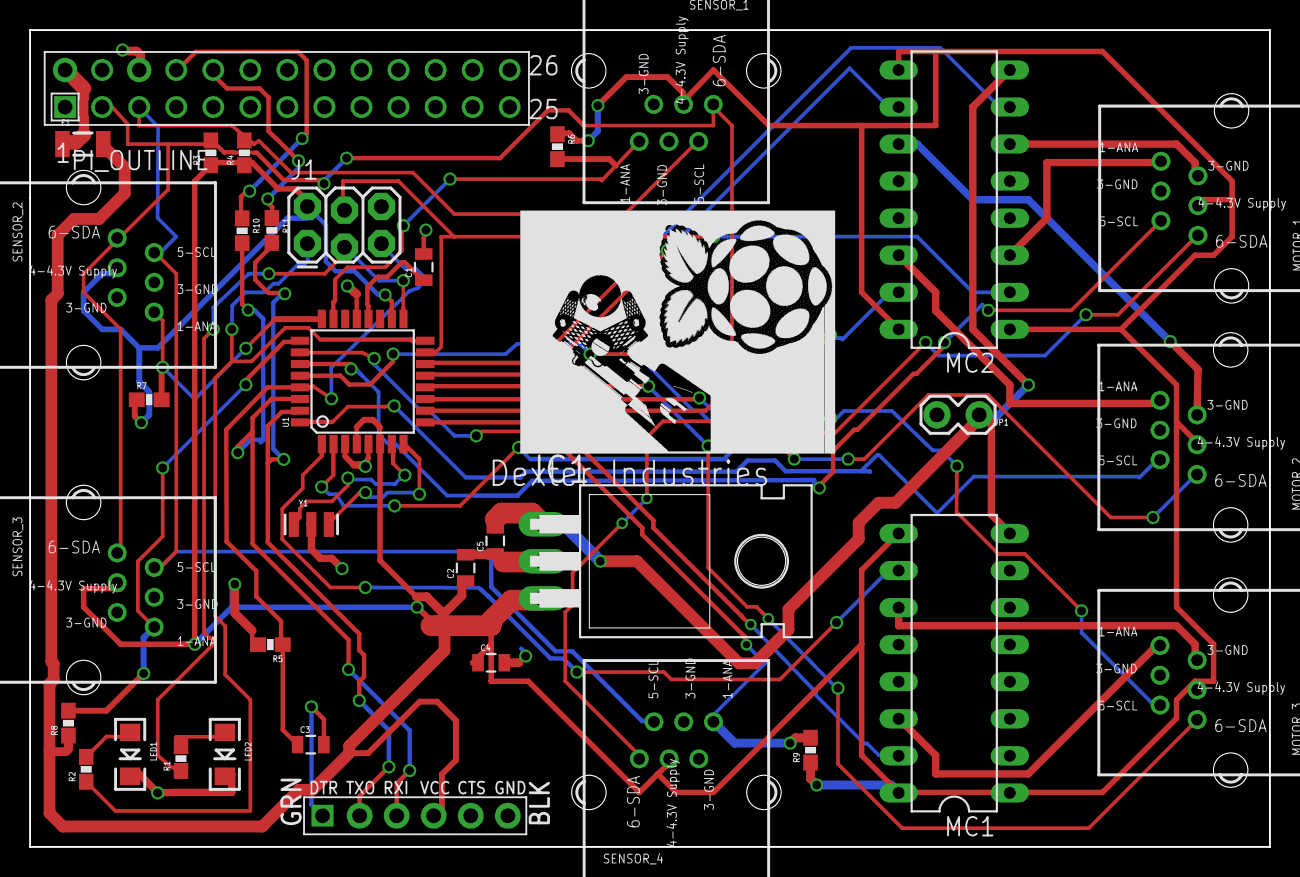
[picture p53: board BrickPi 0_7.brd from above]

Board: 2 copper layers, 85.0 x 56.0 mm, 35 parts (0 on the bottom side), 41 nets.
