DexterInd/BrickPi/BrickPi_Firmware/BrickPi_Firmware.ino

// BrickPi Firmware
// 2013 - John Cole, Dexter Industries
// This code is in the public domain.

/*
  This code does primarily:
  - Controls LED output
  - Controls Motor outputs 1-3
  - Reads Analog values of sensors 1-4
  - Reads Tachometer readings
  - Respond to I2C calls and commands
  - Speed controls (to be implemented at a later time)
  - Need to convert from % power to -128 - 128
*/

/*
Fuses:
  - Extended -  0x05
  - High     -  0xDA
  - Low      -  0xFF
*/

#include <Wire.h>

boolean debug_on = true;
int i = 0;

// Define Pins
const int Port1_Analog = A0;  // Analog input pin that the potentiometer is attached to
const int Port2_Analog = A1;  // Analog input pin that the potentiometer is attached to
const int Port3_Analog = A2;  // Analog input pin that the potentiometer is attached to
const int Port4_Analog = A3;  // Analog input pin that the potentiometer is attached to

const int Motor_1_A = 11; // MOSI // PB3
const int Motor_1_B = 10; // PB2
const int Motor_2_A = 6;  // PD6
const int Motor_2_B = 9; // PB1
const int Motor_3_A = 5; // PD5
const int Motor_3_B = 3; // PD3

const int LED_1 = 12;   // PB4 // MISO
const int LED_2 = 13;   // PB5 // SCK

///////////////////////////////////////////////////////////////////////////////////
// Encoder Variables
///////////////////////////////////////////////////////////////////////////////////
const int Tach_1_1 = 0;  //  PDO
const int Tach_1_2 = 1;  //  PD1
const int Tach_2_1 = 2;  //  PD2
const int Tach_2_2 = 4;  //  PD4
const int Tach_3_1 = 7;  //  PD7
const int Tach_3_2 = 8;  //  PB0

long n1 = 0;  
long n2 = 0;  
long n3 = 0;

long encoder1Pos = 0;
long encoder2Pos = 0;
long encoder3Pos = 0;

int encoder1PinALast = LOW;
int encoder2PinALast = LOW;
int encoder3PinALast = LOW;

//////////////////////////////////////////////////////
// I2C Registers and Data
//////////////////////////////////////////////////////

int motor_power[3] = {0,0,0};
long encoder_values[3] = {0,0,0};
unsigned int analog_values[3] = {0,0,0};
long motor_speed[3] = {0,0,0};    // To be implemented at a later time.

void setup()
{
  Wire.begin(0xF1);                // join i2c bus with address #4
  Wire.onRequest(requestEvent);    // Sending information back to the Pi!
  Wire.onReceive(receiveEvent);    // Receiving Information!
  

  // Initialize Analog Readings
  analogReference(EXTERNAL);   // EXTERNAL: the voltage applied to the AREF pin (0 to 5V only) is used as the reference.
  
  // Initialize motors as outputs.
    pinMode(Motor_1_A, OUTPUT);
    pinMode(Motor_1_B, OUTPUT);
    pinMode(Motor_2_A, OUTPUT);
    pinMode(Motor_2_B, OUTPUT);
    pinMode(Motor_3_A, OUTPUT);
    pinMode(Motor_3_B, OUTPUT);
  
  // Initialize Encoders.
    pinMode(Tach_1_1, INPUT);
    pinMode(Tach_1_2, INPUT);  
    pinMode(Tach_2_1, INPUT);
    pinMode(Tach_2_2, INPUT);
    pinMode(Tach_3_1, INPUT);
    pinMode(Tach_3_2, INPUT);  
  
  // Initialize LEDs.
    pinMode(LED_1, OUTPUT);
    pinMode(LED_2, OUTPUT);
    digitalWrite(LED_1, HIGH);
    digitalWrite(LED_2, HIGH);
    
  
  // Initialize all motors at 0.
    analogWrite(Motor_1_A, 0);  
    analogWrite(Motor_1_B, 0);
    analogWrite(Motor_2_A, 0);
    analogWrite(Motor_2_B, 0);
    analogWrite(Motor_3_A, 0);
    analogWrite(Motor_3_B, 0);
    
  // Initialize all encoder variables.
  
  // 
  
  if(debug_on){
      Serial.begin(57600);           // start serial for output
      while (!Serial) {
        ; // wait for serial port to connect. Needed for Leonardo only
      }
  }
}

void loop()
{
  pin_count();        // Update encoder variables.
  set_motor_power();  // Update the motor powers.
  if(debug_on){
    i++;
    if(i > 10){
      i = 0;
      //Serial.print(encoder_values[0]);
      //Serial.print(" ");
      Serial.print(encoder_values[1]);
      //Serial.print(" ");    
      //Serial.print(encoder_values[2]); 
      Serial.println(" ");
      digitalWrite(LED_1, HIGH);
      digitalWrite(LED_2, HIGH);      
    }
    digitalWrite(LED_1, LOW);
    digitalWrite(LED_2, LOW);    
    motor_power[0] = 128/2;
    motor_power[1] = -128/2;
    motor_power[2] = 128/4;
  }
  
}

// function that executes whenever data is received from master
// this function is registered as an event, see setup()
void receiveEvent(int howMany)
{
  int i = 0;
  while(Wire.available()) // loop through all but the last
  {
    data_request = Wire.receive();          // receive byte as an integer
    data_requested[i] = data_request;       // Position 1 in array is the data requested by NXT. 
    // Rest is a lat/lon coordinate number.  Should not be converted to anything.
    i++;
  }
  //int x = Wire.read();    // receive byte as an integer
  //Serial.println(x);         // print the integer
  switch(data_requested[0]){  
      case 0 :                                  // Time in UTC
        //
        // byte_send = 4;
        break;
      case 0x01 :                                  // Status
        motor_power[0] = data_request[1];
        break;  
      case 0x02 :                                  // Lattitude
        motor_power[1] = data_request[2];
        break;
      case0x03 :                                  // Lattitude
        motor_power[2] = data_request[3];
        break;      
      
      case0x0C :                                  // Lattitude
//        motor_power[2] = data_request[3];
        break;      
      
      case0x0C :                                  // Lattitude
//        motor_power[2] = data_request[3];
        break;      
            
      
        
  }  
  
}

// function that executes whenever data is requested by master
// this function is registered as an event, see setup()
void requestEvent()
{
  Wire.write("hello "); // respond with message of 6 bytes
                       // as expected by master
}

// Set Motor Directions
void set_motor_power(){
    // Motor A pin goes forward.
    // Motor B pin goes backward (negative).
    
    // Motor 1    
    if(motor_power[0] >=0){
      analogWrite(Motor_1_A, (motor_power[0]*2)); 
      analogWrite(Motor_1_B, 0);
    } else {
      analogWrite(Motor_1_A, 0); 
      analogWrite(Motor_1_B, (motor_power[0]*-2));
    }
    
    // Motor 2
    if(motor_power[1] >=0) {
      analogWrite(Motor_2_A, (motor_power[1]*2)); 
      analogWrite(Motor_2_B, 0);
    } else {
      analogWrite(Motor_2_A, 0); 
      analogWrite(Motor_2_B, (motor_power[1]*-2));
    };
    
    // Motor 3
    if(motor_power[2] >=0) {
      analogWrite(Motor_3_A, (motor_power[2]*2)); 
      analogWrite(Motor_3_B, 0);
    } else {
      analogWrite(Motor_3_A, 0); 
      analogWrite(Motor_3_B, (motor_power[2]*-2));
    };
    
}


// Check for changes on the encoders //
void pin_count(){
  n1 = digitalRead(Tach_1_1);
  if((encoder1PinALast == LOW) && (n1 == HIGH)){
   if(digitalRead(Tach_1_2) == LOW){ encoder1Pos--;  }else{  encoder1Pos++;  }
  }
  encoder1PinALast = n1;
  encoder_values[0] = encoder1Pos;
  
  n2 = digitalRead(Tach_2_1);
  if((encoder2PinALast == LOW) && (n2 == HIGH)){
   if(digitalRead(Tach_2_2) == LOW){ encoder2Pos--;  }else{  encoder2Pos++;  }
  }
  encoder2PinALast = n2;
  encoder_values[1] = encoder2Pos;
  
  n3 = digitalRead(Tach_3_1);
  if((encoder3PinALast == LOW) && (n3 == HIGH)){
   if(digitalRead(Tach_3_2) == LOW){ encoder3Pos--;  }else{  encoder3Pos++;  }
  }
  encoder3PinALast = n3;
  encoder_values[2] = encoder3Pos;
}
