DexterInd/BrickPi/Software/BrickPi_Python/Sensor_Examples/EV3-Infrared_remote.py

#!/usr/bin/env python
# BRICKPI LEGO EV3 INFRARED SENSOR EXAMPLE.
############################################
# 
# This example will show you how to use the LEGO EV3 Infrared sensor with the BrickPi.  
# Note you must have the latest firmware installed on the BrickPi or this example to work.  
# Connect the EV3 infrared Sensor to Sensor port S1.
##
# Select the mode of operation below.  These are the modes of operation for the gyro.
# TYPE_SENSOR_EV3_INFRARED_M0  		# Proximity, 0 to 100
# TYPE_SENSOR_EV3_INFRARED_M1   	# IR Seek, -25 (far left) to 25 (far right)
# TYPE_SENSOR_EV3_INFRARED_M2   	# IR Remote Control, 0 - 11 
##
#
# Original Author: John
# Initial Date:		Jun 13, 2014
# Updated:  		Aug 19, 2015
# Updated:          	Oct 28, 2016 Shoban
#
# You can learn more about BrickPi here:  http://www.dexterindustries.com/BrickPi
# Have a question about this example?  Ask on the forums here:  http://forum.dexterindustries.com/c/brickpi
#
# These files have been made available online through a Creative Commons Attribution-ShareAlike 3.0  license.
# (http://creativecommons.org/licenses/by-sa/3.0/)


def interpret_response(response_in):
	# Check for error reading.  If it's an error reading, return 0.
	if response_in < 4278190080:

		print response_in
		if response_in < 4278190336 and response_in >=  16777216:
			response_in = response_in / 16777216
			if response_in <= 9:
				return response_in
			else:
				print "Failure! "
				return -5
		
		elif response_in < 16777216 and response_in >=  65536:
			response_in = response_in / 65536
			if response_in <= 9:
				return response_in
			else:
				print "Failure!"
				return -5
		elif response_in < 65536 and response_in >=  256:
			response_in = response_in / 256
			if response_in <= 9:
				return response_in
			else:
				print "Failure!"
				return -5
		elif response_in < 256 and response_in >=  0:
				return response_in		
		else:
			return response_in
		
	else:
		return -3

def interpret_button(number):
	if number == 0:
		print "Nothing pressed!"
	elif number == 9:
		print "Top button pressed!"
	elif number == 1:
		print "Top red button pressed!"
	elif number == 2:
		print "Bottom red button pressed!"
	elif number == 3:
		print "Top blue button pressed!"
	elif number == 4:
		print "Bottom blue button pressed!"
	else:
		print "Something else was pressed!"
		
from BrickPi import *   								#import BrickPi.py file to use BrickPi operations
BrickPiSetup()  										# setup the serial port for communication
############################################
# !  Set the sensor type on the line below.  
BrickPi.SensorType[PORT_1] = TYPE_SENSOR_EV3_INFRARED_M2  	#Set the type of sensor at PORT_1.  M0 is proximity, 0 to 100. 
BrickPiSetupSensors()   									#Send the properties of sensors to BrickPi.  Set up the BrickPi.
# There's often a long wait for setup with the EV3 sensors.  Up to 5 seconds.


while True:
	result = BrickPiUpdateValues()  # Ask BrickPi to update values for sensors/motors 
	if not result :
		infrared = BrickPi.Sensor[PORT_1]
		button_value = interpret_response(infrared)
		if button_value >= 0:
			print "Button reads: "+str(button_value)
			interpret_button(button_value)
		
	time.sleep(.01)     # sleep for 10 ms
