DexterInd/BrickPi/Software/BrickPi_Python/Sensor_Examples/General-Analog_Sensor_Test.py

#!/usr/bin/env python
# Jaikrishna
# Initial Date: June 24, 2013
# Last Updated: June 24, 2013
#
# These files have been made available online through a Creative Commons Attribution-ShareAlike 3.0  license.
# (http://creativecommons.org/licenses/by-sa/3.0/)
#
# http://www.dexterindustries.com/
# This code is for testing the BrickPi with any Analog sensor

from BrickPi import *   #import BrickPi.py file to use BrickPi operations

BrickPiSetup()  # setup the serial port for communication

BrickPi.SensorType[PORT_1] = TYPE_SENSOR_RAW   #Set the type of sensor at PORT_1
BrickPi.SensorType[PORT_2] = TYPE_SENSOR_RAW
BrickPi.SensorType[PORT_3] = TYPE_SENSOR_RAW
BrickPi.SensorType[PORT_4] = TYPE_SENSOR_RAW

BrickPiSetupSensors()   #Send the properties of sensors to BrickPi

while True:
    result = BrickPiUpdateValues()  # Ask BrickPi to update values for sensors/motors 
    if not result :
        print BrickPi.Sensor[PORT_1], BrickPi.Sensor[PORT_2], BrickPi.Sensor[PORT_3], BrickPi.Sensor[PORT_4]     #BrickPi.Sensor[PORT] stores the value obtained from sensor
    time.sleep(.1)     # sleep for 100 ms
