DexterInd/BrickPi/(commit log)

2013-04-03 Motors and I2C Sensors Work
2013-04-03 Added hardware files.
    Added the hardware files for Eagle as well as the Todo list for
    implementation!
    [BrickPi - Registers and Information.xlsx, BrickPi 0.5.brd, BrickPi 0.5.sch]
2013-04-08 Adding the Case Enclosure
    Adding the casing enclosure under "Case Design". Version 2 files went
    in.
2013-04-11 Added Bill of Materials
    Added BOM, some other documents.
    [BrickPi BOM 0.5.xlsx]
2013-05-13 Updated Hardware Design
    Updated the hardware design, adding in Version 0.7, including a BOM.
    The firmware for this new hardware design was updated. The primary
    changes on this version include:
    - Comms between the BrickPi and the Arduino are done via serial.
    - 10k resistors were added to the analog lines on the Arduino chip.
    - And FTDI breakout was added.
    [BrickPi 0_7.brd, BrickPi 0_7.sch, BrickPi BOM 0.7.xlsx]
2013-05-17 Adding instructions to ignore the "Disable Bootup Info" section in the hobbytronics websites
    Jon recommended to ignore this section as it may interrupt serial communication on the Arduino.
2013-07-05 Added latest hardware and BOM.
    Also cleaned up the old files and put them into a repository for
    posterity.
    [BrickPi 0.5.brd, BrickPi 0.5.sch, BrickPi 0_7.brd, BrickPi 0_7.sch, BrickPi 1.6.brd, BrickPi 1.6.sch, BrickPi 1.7.3.brd, BrickPi 1.7.3.sch]
2013-07-09 Clean Up Added latest firmware, instructions for installing it, and cleaned up the older repositories, archived.
    [BrickPi - Registers and Information.xlsx]
2013-07-23 Adding wiringpi
2013-08-13 Add models, readmes
    [WiFi-Car-BOM.xlsx]
2013-08-28 Update firmware, building instructions.
    [Shooter_Bill_Of_Materials.xlsx, WiFi-Car-BOM.xlsx]
2013-08-28 Added more bom on the models, updates.
    [Tank_BOM.xlsx, arm_Bill_Of_Materials.xlsx]
2013-09-27 Updated with Schematic
    Updated with Schematic
2013-10-07 Updated pdf schematic
2013-11-05 SimpleBot Lego Designer Files and BOM added
    [simplebot_bom.xlsx]
2013-11-24 Updated balloon code!
    [data.csv]
2013-11-29 Updated Balloon files.
    [data.csv]
2014-01-29 Install script updated and moved to Setup Files
    - apt-get upgrade
    - use custom WiringPi
    - setup.py
2014-03-17 errors saved to file from the USB mount script
2014-04-28 Updated Tank Building Instructions
    [Tank_BOM.xlsx]
2014-06-04 July 7th Revert
    Reverted the code to July 7th code on BrickPiDev. The previous code was
    holed up in the branch HOLD_MATTS_CODE in case we have to come back.
    But this code compiles and goes on the Arduino of the BrickPi.
    [BrickPiA.cpp, BrickPiA.h, BrickPiCS.cpp, BrickPiCS.h, BrickPiFW_Compressed_Communication.ino, BrickPiUART.cpp, BrickPiUART.h]
2014-06-08 Firmware 2.0 updated to support EV3 Sensors
2014-06-18 Touch Sensor Working
    Touch sensor is working. Still need work in IR buttons.
2014-07-01 EV3 touch- (FW) averaging to remove noise
    [BrickPiEV3.cpp]
2014-07-24 Added Arduino Upload Scripts
    Scripts for firmware uploading from Raspberry Pi to BrickPi.
2015-04-19 Use markdown so this file is readable on GitHub.
    Also fixed a couple spelling errors.
2015-10-19 Update Hardware
    [BrickPi 1.7.3.brd, BrickPi 1.7.3.sch, BrickPi BOM 1.7.3.xlsx]
2016-01-21 eagle brd designs removed
    [BrickPi 0.5.brd, BrickPi 0.5.sch, BrickPi 0_7.brd, BrickPi 0_7.sch, BrickPi 1.6.brd, BrickPi 1.6.sch, BrickPi 1.7.3.brd, BrickPi 1.7.3.sch]
2017-01-05 Brought Software Over
    Brought Python/C/Scratch into this directory.
    [TcfTransactionLog.csv, profile-results.xlsx]
2017-01-06 Update BrickPi+ Install Script
    There were no dependencies, but I updated the wiringPi instructions.
2017-01-06 BrickPi+ Install Script Cleanup
    Removed WiringPi and use new install procedure.
    Consolidated Python Installation.
    Updated readme, added in Shoban's Dev notes.
2017-01-11 bring script up to date with functions_library.sh, wiringpi.sh
2017-03-31 Fixed bug
    Init_val is only modified when deg[i] == 0. Fixed it.
    [BrickPi.py]
